mulhearn/pacman/vivado/README

This approach is based on:

https://www.fpgadeveloper.com/2014/08/version-control-for-vivado-projects.html/
