mulhearn/pacman/docs/notes/table_JB1-3.tex

JB1.35 & TILE7\_POSI0 & B35\_L10\_N & IO\_L10N\_T1\_AD11N\_35 & A19 \\ 
JB1.37 & TILE7\_POSI1 & B35\_L10\_P & IO\_L10P\_T1\_AD11P\_35 & A18 \\ 
JB1.39 & TILE7\_POSI2 & B35\_L9\_N & IO\_L9N\_T1\_DQS\_AD3N\_35 & A17 \\ 
JB1.41 & TILE7\_POSI3 & B35\_L9\_P & IO\_L9P\_T1\_DQS\_AD3P\_35 & A16 \\ 
JB1.45 & TILE7\_PISO0 & B35\_L7\_N & IO\_L7N\_T1\_AD2N\_35 & B15 \\ 
JB1.47 & TILE7\_PISO1 & B35\_L7\_P & IO\_L7P\_T1\_AD2P\_35 & C15 \\ 
JB1.49 & TILE7\_PISO2 & B35\_L2\_N & IO\_L2N\_T0\_AD8N\_35 & D17 \\ 
JB1.51 & TILE7\_PISO3 & B35\_L2\_P & IO\_L2P\_T0\_AD8P\_35 & D16 \\ 
JB1.55 & TILE6\_POSI0 & B35\_L8\_N & IO\_L8N\_T1\_AD10N\_35 & B17 \\ 
JB1.57 & TILE6\_POSI1 & B35\_L8\_P & IO\_L8P\_T1\_AD10P\_35 & B16 \\ 
JB1.59 & TILE6\_POSI2 & B35\_L21\_N & IO\_L21N\_T3\_DQS\_AD14N\_35 & E20 \\ 
JB1.61 & TILE6\_POSI3 & B35\_L21\_P & IO\_L21P\_T3\_DQS\_AD14P\_35 & E19 \\ 
JB1.65 & TILE6\_PISO0 & B35\_L11\_N & IO\_L11N\_T1\_SRCC\_35 & C18 \\ 
JB1.67 & TILE6\_PISO1 & B35\_L11\_P & IO\_L11P\_T1\_SRCC\_35 & C17 \\ 
JB1.69 & TILE6\_PISO2 & B35\_L23\_N & IO\_L23N\_T3\_35 & F22 \\ 
JB1.71 & TILE6\_PISO3 & B35\_L23\_P & IO\_L23P\_T3\_35 & F21 \\ 
JB1.75 & TILE9\_POSI0 & B35\_L5\_N & IO\_L5N\_T0\_AD9N\_35 & E18 \\ 
JB1.77 & TILE9\_POSI1 & B35\_L5\_P & IO\_L5P\_T0\_AD9P\_35 & F18 \\ 
JB1.79 & TILE9\_POSI2 & B35\_L3\_N & IO\_L3N\_T0\_DQS\_AD1N\_35 & D15 \\ 
JB1.81 & TILE9\_POSI3 & B35\_L3\_P & IO\_L3P\_T0\_DQS\_AD1P\_35 & E15 \\ 
JB1.85 & TILE9\_PISO0 & B35\_L6\_N & IO\_L6N\_T0\_VREF\_35 & F17 \\ 
JB1.87 & TILE9\_PISO1 & B35\_L6\_P & IO\_L6P\_T0\_35 & G17 \\ 
JB1.93 & TILE9\_PISO2 & B35\_L1\_N & IO\_L1N\_T0\_AD0N\_35 & E16 \\ 
JB1.95 & TILE9\_PISO3 & B35\_L1\_P & IO\_L1P\_T0\_AD0P\_35 & F16 \\ 
JB1.97 & ADC\_D2 & B35\_L19\_N & IO\_L19N\_T3\_VREF\_35 & H20 \\ 
JB1.99 & ADC\_D3 & B35\_L19\_P & IO\_L19P\_T3\_35 & H19 \\ 
JB1.32 & TILE4\_POSI0 & B35\_L16\_N & IO\_L16N\_T2\_35 & C22 \\ 
JB1.34 & TILE4\_POSI1 & B35\_L16\_P & IO\_L16P\_T2\_35 & D22 \\ 
JB1.36 & TILE4\_POSI2 & B35\_L24\_N & IO\_L24N\_T3\_AD15N\_35 & G22 \\ 
JB1.38 & TILE4\_POSI3 & B35\_L24\_P & IO\_L24P\_T3\_AD15P\_35 & H22 \\ 
JB1.42 & TILE4\_PISO0 & B35\_L18\_N & IO\_L18N\_T2\_AD13N\_35 & B22 \\ 
JB1.44 & TILE4\_PISO1 & B35\_L18\_P & IO\_L18P\_T2\_AD13P\_35 & B21 \\ 
JB1.46 & TILE4\_PISO2 & B35\_L15\_N & IO\_L15N\_T2\_DQS\_AD12N\_35 & A22 \\ 
JB1.48 & TILE4\_PISO3 & B35\_L15\_P & IO\_L15P\_T2\_DQS\_AD12P\_35 & A21 \\ 
JB1.50 & TILE1\_ENABLE & B35\_L22\_N & IO\_L22N\_T3\_AD7N\_35 & G21 \\ 
JB1.52 & TILE1\_TRIG & B35\_L22\_P & IO\_L22P\_T3\_AD7P\_35 & G20 \\ 
JB1.56 & TILE1\_POSI0 & B35\_L17\_N & IO\_L17N\_T2\_AD5N\_35 & D21 \\ 
JB1.58 & TILE1\_POSI1 & B35\_L17\_P & IO\_L17P\_T2\_AD5P\_35 & E21 \\ 
JB1.60 & TILE1\_POSI2 & B35\_L13\_N & IO\_L13N\_T2\_MRCC\_35 & B20 \\ 
JB1.62 & TILE1\_POSI3 & B35\_L13\_P & IO\_L13P\_T2\_MRCC\_35 & B19 \\ 
JB1.66 & TILE1\_PISO0 & B35\_L14\_N & IO\_L14N\_T2\_AD4N\_SRCC\_35 & C20 \\
JB1.68 & TILE1\_PISO1 & B35\_L14\_P & IO\_L14P\_T2\_AD4P\_SRCC\_35 & D20 \\ 
JB1.70 & TILE1\_PISO2 & B35\_L4\_N & IO\_L4N\_T0\_34 & M17 \\
JB1.72 & TILE1\_PISO3 & B35\_L4\_P & IO\_L4P\_T0\_35 & G15 \\ 
JB1.76 & GLOBAL\_CLK & B35\_L12\_N & IO\_L12N\_T1\_MRCC\_35 & C19 \\ 
JB1.78 & TILE1\_SYNC & B35\_L12\_P & IO\_L12P\_T1\_MRCC\_35 & D18 \\ 
JB1.82 & ADC\_D0 & B35\_L20\_N & IO\_L20N\_T3\_AD6N\_35 & F19 \\ 
JB1.84 & ADC\_D1 & B35\_L20\_P & IO\_L20P\_T3\_AD6P\_35 & G19 \\ 
JB2.13 & SFP\_TDATA\_P & B33\_L4\_P & IO\_L4P\_T0\_33 & W20 \\ 
JB2.15 & SFP\_TDATA\_N & B33\_L4\_N & IO\_L4N\_T0\_33 & W21 \\ 
JB2.21 & CDR\_CLK\_P & B33\_L13\_P & IO\_L13P\_T2\_MRCC\_33 & W17 \\ 
JB2.23 & CDR\_CLK\_N & B33\_L13\_N & IO\_L13N\_T2\_MRCC\_33 & W18 \\ 
JB2.25 & CDR\_DATA\_P & B33\_L14\_P & IO\_L14P\_T2\_SRCC\_33 & W16 \\ 
JB2.27 & CDR\_DATA\_N & B33\_L14\_N & IO\_L14N\_T2\_SRCC\_33 & Y16 \\ 
JB2.31 & TILE2\_POSI0 & B13\_L5\_P & IO\_L5P\_T0\_13 & U12 \\ 
JB2.33 & TILE2\_POSI1 & B13\_L5\_N & IO\_L5N\_T0\_13 & U11 \\ 
JB2.35 & TILE2\_POSI2 & B13\_L6\_P & IO\_L6P\_T0\_13 & U10 \\ 
JB2.37 & TILE2\_POSI3 & B13\_L6\_N & IO\_L6N\_T0\_VREF\_13 & U9 \\ 
JB2.41 & TILE2\_PISO0 & B13\_L1\_P & IO\_L1P\_T0\_13 & V10 \\ 
JB2.43 & TILE2\_PISO1 & B13\_L1\_N & IO\_L1N\_T0\_13 & V9 \\ 
JB2.45 & TILE2\_PISO2 & B13\_L12\_P & IO\_L12P\_T1\_MRCC\_13 & Y9 \\ 
JB2.47 & TILE2\_PISO3 & B13\_L12\_N & IO\_L12N\_T1\_MRCC\_13 & Y8 \\ 
JB2.51 & TILE3\_POSI0 & B13\_L14\_P & IO\_L14P\_T2\_SRCC\_13 & AA7 \\ 
JB2.53 & TILE3\_POSI1 & B13\_L14\_N & IO\_L14N\_T2\_SRCC\_13 & AA6 \\ 
JB2.55 & TILE3\_POSI2 & B13\_L13\_P & IO\_L13P\_T2\_MRCC\_13 & Y6 \\ 
JB2.57 & TILE3\_POSI3 & B13\_L13\_N & IO\_L13N\_T2\_MRCC\_13 & Y5 \\ 
JB2.61 & TILE3\_PISO0 & B13\_L4\_P & IO\_L4P\_T0\_13 & V12 \\ 
JB2.63 & TILE3\_PISO1 & B13\_L4\_N & IO\_L4N\_T0\_13 & W12 \\ 
JB2.65 & TILE3\_PISO2 & B13\_L3\_P & IO\_L3P\_T0\_DQS\_13 & W11 \\ 
JB2.67 & TILE3\_PISO3 & B13\_L3\_N & IO\_L3N\_T0\_DQS\_13 & W10 \\ 
JB2.71 & TILE10\_POSI0 & B13\_L10\_P & IO\_L10P\_T1\_13 & Y11 \\ 
JB2.73 & TILE10\_POSI1 & B13\_L10\_N & IO\_L10N\_T1\_13 & Y10 \\ 
JB2.75 & TILE10\_POSI2 & B13\_L2\_P & IO\_L2P\_T0\_13 & V8 \\ 
JB2.77 & TILE10\_POSI3 & B13\_L2\_N & IO\_L2N\_T0\_13 & W8 \\ 
JB2.81 & TILE10\_PISO0 & B13\_L23\_P & IO\_L23P\_T3\_13 & V7 \\ 
JB2.83 & TILE10\_PISO1 & B13\_L23\_N & IO\_L23N\_T3\_13 & W7 \\ 
JB2.85 & TILE10\_PISO2 & B13\_L24\_P & IO\_L24P\_T3\_13 & W6 \\ 
JB2.87 & TILE10\_PISO3 & B13\_L24\_N & IO\_L24N\_T3\_13 & W5 \\ 
JB2.91 & ADC\_D4 & B13\_L19\_P & IO\_L19P\_T3\_13 & R6 \\ 
JB2.93 & ADC\_D5 & B13\_L19\_N & IO\_L19N\_T3\_VREF\_13 & T6 \\ 
JB2.95 & ADC\_D6 & B13\_L22\_P & IO\_L22P\_T3\_13 & U6 \\ 
JB2.97 & ADC\_D7 & B13\_L22\_N & IO\_L22N\_T3\_13 & U5 \\ 
JB2.12  & SFP\_TCLK\_P & B33\_L7\_P & IO\_L7P\_T1\_33 & AA22 \\ 
JB2.14 & SFP\_TCLK\_N & B33\_L7\_N & IO\_L7N\_T1\_33 & AB22 \\ 
JB2.16 & SFP\_FAULT & B33\_L8\_P & IO\_L8P\_T1\_33 & AA21 \\ 
JB2.18 & SFP\_LOS & B33\_L8\_N & IO\_L8N\_T1\_33 & AB21 \\ 
JB2.22 & SFP\_MOD & B33\_L11\_P & IO\_L11P\_T1\_SRCC\_33 & Y19 \\ 
JB2.24 & SFP\_DISABLE & B33\_L11\_N & IO\_L11N\_T1\_SRCC\_33 & AA19 \\ 
JB2.26 & ADC\_D8 & B33\_L12\_P & IO\_L12P\_T1\_MRCC\_33 & Y18 \\ 
JB2.28 & ADC\_D9 & B33\_L12\_N & IO\_L12N\_T1\_MRCC\_33 & AA18 \\ 
JB2.32 & ADC\_D10 & B33\_L17\_P & IO\_L17P\_T2\_33 & AA17 \\ 
JB2.34 & ADC\_D11 & B33\_L17\_N & IO\_L17N\_T2\_33 & AB17 \\
JB2.36 & ADC\_OF & B33\_L18\_P & IO\_L18P\_T2\_33 & AA16 \\ 
JB2.38 & ADC\_EN & B33\_L18\_N & IO\_L18N\_T2\_33 & AB16 \\ 
JB2.42 & TILE5\_POSI3 & B13\_L7\_P & IO\_L7P\_T1\_13 & AA12 \\ 
JB2.44 & TILE5\_POSI2 & B13\_L7\_N & IO\_L7N\_T1\_13 & AB12 \\ 
JB2.46 & TILE5\_POSI1 & B13\_L8\_P & IO\_L8P\_T1\_13 & AA11 \\ 
JB2.48 & TILE5\_POSI0 & B13\_L8\_N & IO\_L8N\_T1\_13 & AB11 \\ 
JB2.52 & TILE5\_PISO3 & B13\_L11\_P & IO\_L11P\_T1\_SRCC\_13 & AA9 \\ 
JB2.54 & TILE5\_PISO2 & B13\_L11\_N & IO\_L11N\_T1\_SRCC\_13 & AA8 \\ 
JB2.56 & TILE5\_PISO1 & B13\_L9\_P & IO\_L9P\_T1\_DQS\_13 & AB10 \\ 
JB2.58 & TILE5\_PISO0 & B13\_L9\_N & IO\_L9N\_T1\_DQS\_13 & AB9 \\ 
JB2.62 & TILE8\_POSI3 & B13\_L20\_P & IO\_L20P\_T3\_13 & T4 \\ 
JB2.64 & TILE8\_POSI2 & B13\_L20\_N & IO\_L20N\_T3\_13 & U4 \\ 
JB2.66 & TILE8\_POSI1 & B13\_L17\_P & IO\_L17P\_T2\_13 & AB7 \\ 
JB2.68 & TILE8\_POSI0 & B13\_L17\_N & IO\_L17N\_T2\_13 & AB6 \\ 
JB2.72 & TILE8\_PISO3 & B13\_L16\_P & IO\_L16P\_T2\_13 & AB5 \\ 
JB2.74 & TILE8\_PISO2 & B13\_L16\_N & IO\_L16N\_T2\_13 & AB4 \\ 
JB2.76 & TILE8\_PISO1 & B13\_L18\_P & IO\_L18P\_T2\_13 & Y4 \\ 
JB2.78 & TILE8\_PISO0 & B13\_L18\_N & IO\_L18N\_T2\_13 & AA4 \\ 
JB2.82 & TEST\_OUT1 & B13\_L15\_P & IO\_L15P\_T2\_DQS\_13 & AB2 \\ 
JB2.84 & TEST\_OUT2 & B13\_L15\_N & IO\_L15N\_T2\_DQS\_13 & AB1 \\ 
JB2.86 & CDR\_LOL & B13\_L21\_P & IO\_L21P\_T3\_DQS\_13 & V5 \\ 
JB2.88 & CDR\_LOS & B13\_L21\_N & IO\_L21N\_T3\_DQS\_13 & V4 \\ 
JB3.7 & ADC\_CLK & B34\_L1\_P & IO\_L1P\_T0\_34 & J15 \\ 
JB3.9 & TILE4\_ENABLE & B34\_L1\_N & IO\_L1N\_T0\_34 & K15 \\ 
JB3.13 & TILE7\_ENABLE & B34\_L18\_P & IO\_L18P\_T2\_34 & P20 \\ 
JB3.15 & TILE6\_ENABLE & B34\_L18\_N & IO\_L18N\_T2\_34 & P21 \\ 
JB3.19 & TILE3\_ENABLE & B34\_L20\_P & IO\_L20P\_T3\_34 & P17 \\ 
JB3.21 & TILE2\_ENABLE & B34\_L20\_N & IO\_L20N\_T3\_34 & P18 \\ 
JB3.25 & TILE5\_ENABLE & B34\_L10\_P & IO\_L10P\_T1\_34 & L21 \\ 
JB3.27 & TILE8\_ENABLE & B34\_L10\_N & IO\_L10N\_T1\_34 & L22 \\ 
JB3.31 & TILE9\_ENABLE & B34\_L13\_P & IO\_L13P\_T2\_MRCC\_34 & M19 \\ 
JB3.33 & TILE10\_ENABLE & B34\_L13\_N & IO\_L13N\_T2\_MRCC\_34 & M20 \\ 
JB3.37 & (not used) & B34\_L21\_P & IO\_L21P\_T3\_DQS\_34 & T16 \\ 
JB3.39 & TILE4\_TRIG & B34\_L21\_N & IO\_L21N\_T3\_DQS\_34 & T17 \\ 
JB3.41 & TILE7\_TRIG & B34\_L15\_P & IO\_L15P\_T2\_DQS\_34 & M21 \\ 
JB3.43 & TILE6\_TRIG & B34\_L15\_N & IO\_L15N\_T2\_DQS\_34 & M22 \\ 
JB3.47 & TILE3\_TRIG & B34\_L17\_P & IO\_L17P\_T2\_34 & R20 \\ 
JB3.49 & TILE2\_TRIG & B34\_L17\_N & IO\_L17N\_T2\_34 & R21 \\ 
JB3.51 & TILE5\_TRIG & B34\_L23\_P & IO\_L23P\_T3\_34 & R18 \\ 
JB3.53 & TILE8\_TRIG & B34\_L23\_N & IO\_L23N\_T3\_34 & T18 \\ 
JB3.57 & TILE9\_TRIG & B34\_L14\_P & IO\_L14P\_T2\_SRCC\_34 & N19 \\ 
JB3.59 & TILE10\_TRIG & B34\_L14\_N & IO\_L14N\_T2\_SRCC\_34 & N20 \\ 
JB3.8 & TRIG\_ISO & B34\_L7\_P & IO\_L7P\_T1\_34 & J18 \\ 
JB3.10 & SYNC\_ISO & B34\_L7\_N & IO\_L7N\_T1\_34 & K18 \\ 
JB3.14 & ANALOG\_PWR\_EN & B34\_L2\_P & IO\_L2P\_T0\_34 & J16 \\ 
JB3.16 & TILE2\_SYNC & B34\_L2\_N & IO\_L2N\_T0\_34 & J17 \\ 
JB3.20 & TILE3\_SYNC & B34\_L4\_P & IO\_L4P\_T0\_34 & L17 \\ 
JB3.22 & TILE4\_SYNC & B34\_L4\_N & IO\_L4N\_T0\_34 & M17 \\ 
JB3.26 & TILE5\_SYNC & B34\_L5\_P & IO\_L5P\_T0\_34 & N17 \\ 
JB3.28 & TILE6\_SYNC & B34\_L5\_N & IO\_L5N\_T0\_34 & N18 \\ 
JB3.32 & ISO\_SIGNAL0 & B34\_L12\_P & IO\_L12P\_T1\_MRCC\_34 & L18 \\ 
JB3.34 & ISO\_SIGNAL1 & B34\_L12\_N & IO\_L12N\_T1\_MRCC\_34 & L19 \\ 
JB3.38 & TILE7\_SYNC & B34\_L8\_P & IO\_L8P\_T1\_34 & J21 \\ 
JB3.40 & TILE8\_SYNC & B34\_L8\_N & IO\_L8N\_T1\_34 & J22 \\ 
JB3.42 & TILE9\_SYNC & B34\_L9\_P & IO\_L9P\_T1\_DQS\_34 & J20 \\ 
JB3.44 & TILE10\_SYNC & B34\_L9\_N & IO\_L9N\_T1\_DQS\_34 & K21 \\ 
JB3.58 & LED-2 & B34\_L22\_P & IO\_L22P\_T3\_34 & R19 \\ 
JB3.60 & LED-3 & B34\_L22\_N & IO\_L22N\_T3\_34 & T19
