mulhearn/pacman/docs/legacy/v1r2/hardware.txt

Schematics for the TE0720-03-1CFA:
https://www.trenz-electronic.de/fileadmin/docs/Trenz_Electronic/Modules_and_Module_Carriers/4x5/TE0720/REV03/Documents/SCH-TE0720-03-1CFA.PDF

From which we see that it contains a XC7Z020-1CLG484C with pinout from:
https://www.xilinx.com/support/documentation/user_guides/ug865-Zynq-7000-Pkg-Pinout.pdf
https://www.xilinx.com/support/packagefiles/z7packages/xc7z020clg484pkg.txt

Tutorial that includes AXI:
https://www.xilinx.com/support/documentation/sw_manuals/xilinx2018_3/ug1165-zynq-embedded-design-tutorial.pdf

Schematics for one of our carriers:
http://www.trenz-electronic.de/fileadmin/docs/Trenz_Electronic/Modules_and_Module_Carriers/4x5/4x5_Carriers/TE0703/REV05/Documents/TRM-TE0703-05.pdf
