mulhearn/pacman/docs/demos/dma_sg/axi-dma.png

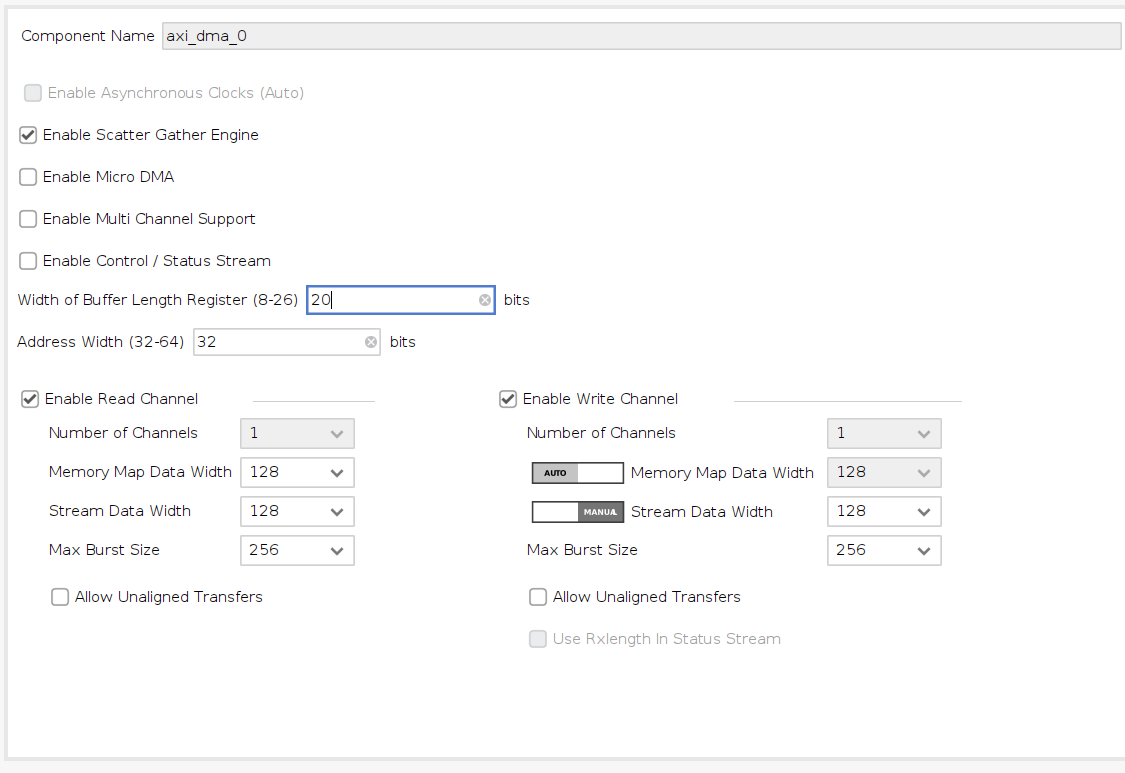
docs/demos/dma_sg/axi-dma.png
