mulhearn/pacman/docs/demos/dma_sg/fifo_a.png

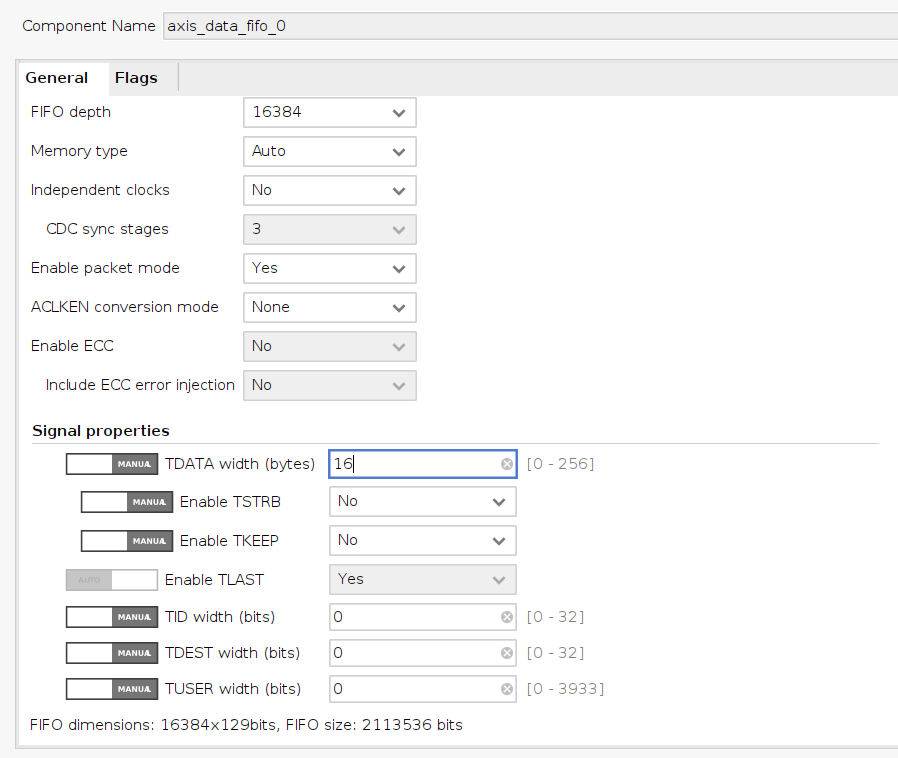
docs/demos/dma_sg/fifo_a.png
