mulhearn/pacman/docs/demos/dma_sg/fifo_b.png

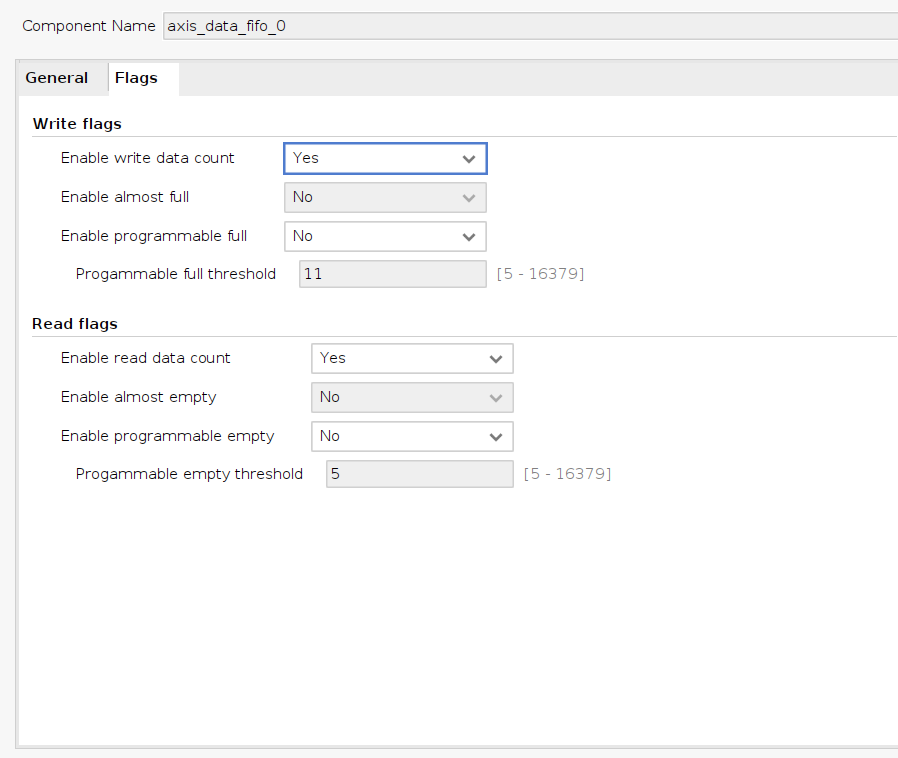
docs/demos/dma_sg/fifo_b.png
