mulhearn/pacman/petalinux/src/trenz/project-spec/configs/flash_parts.txt

flash_type=spi
boot=0 0x100000
kernel=0x100000 0x1400000
