mulhearn/pacman/docs/notes/PacMan_V5_HGB_20240520_schematics.pdf

6 | 5 | 4 | 3 | 2 | 1

D

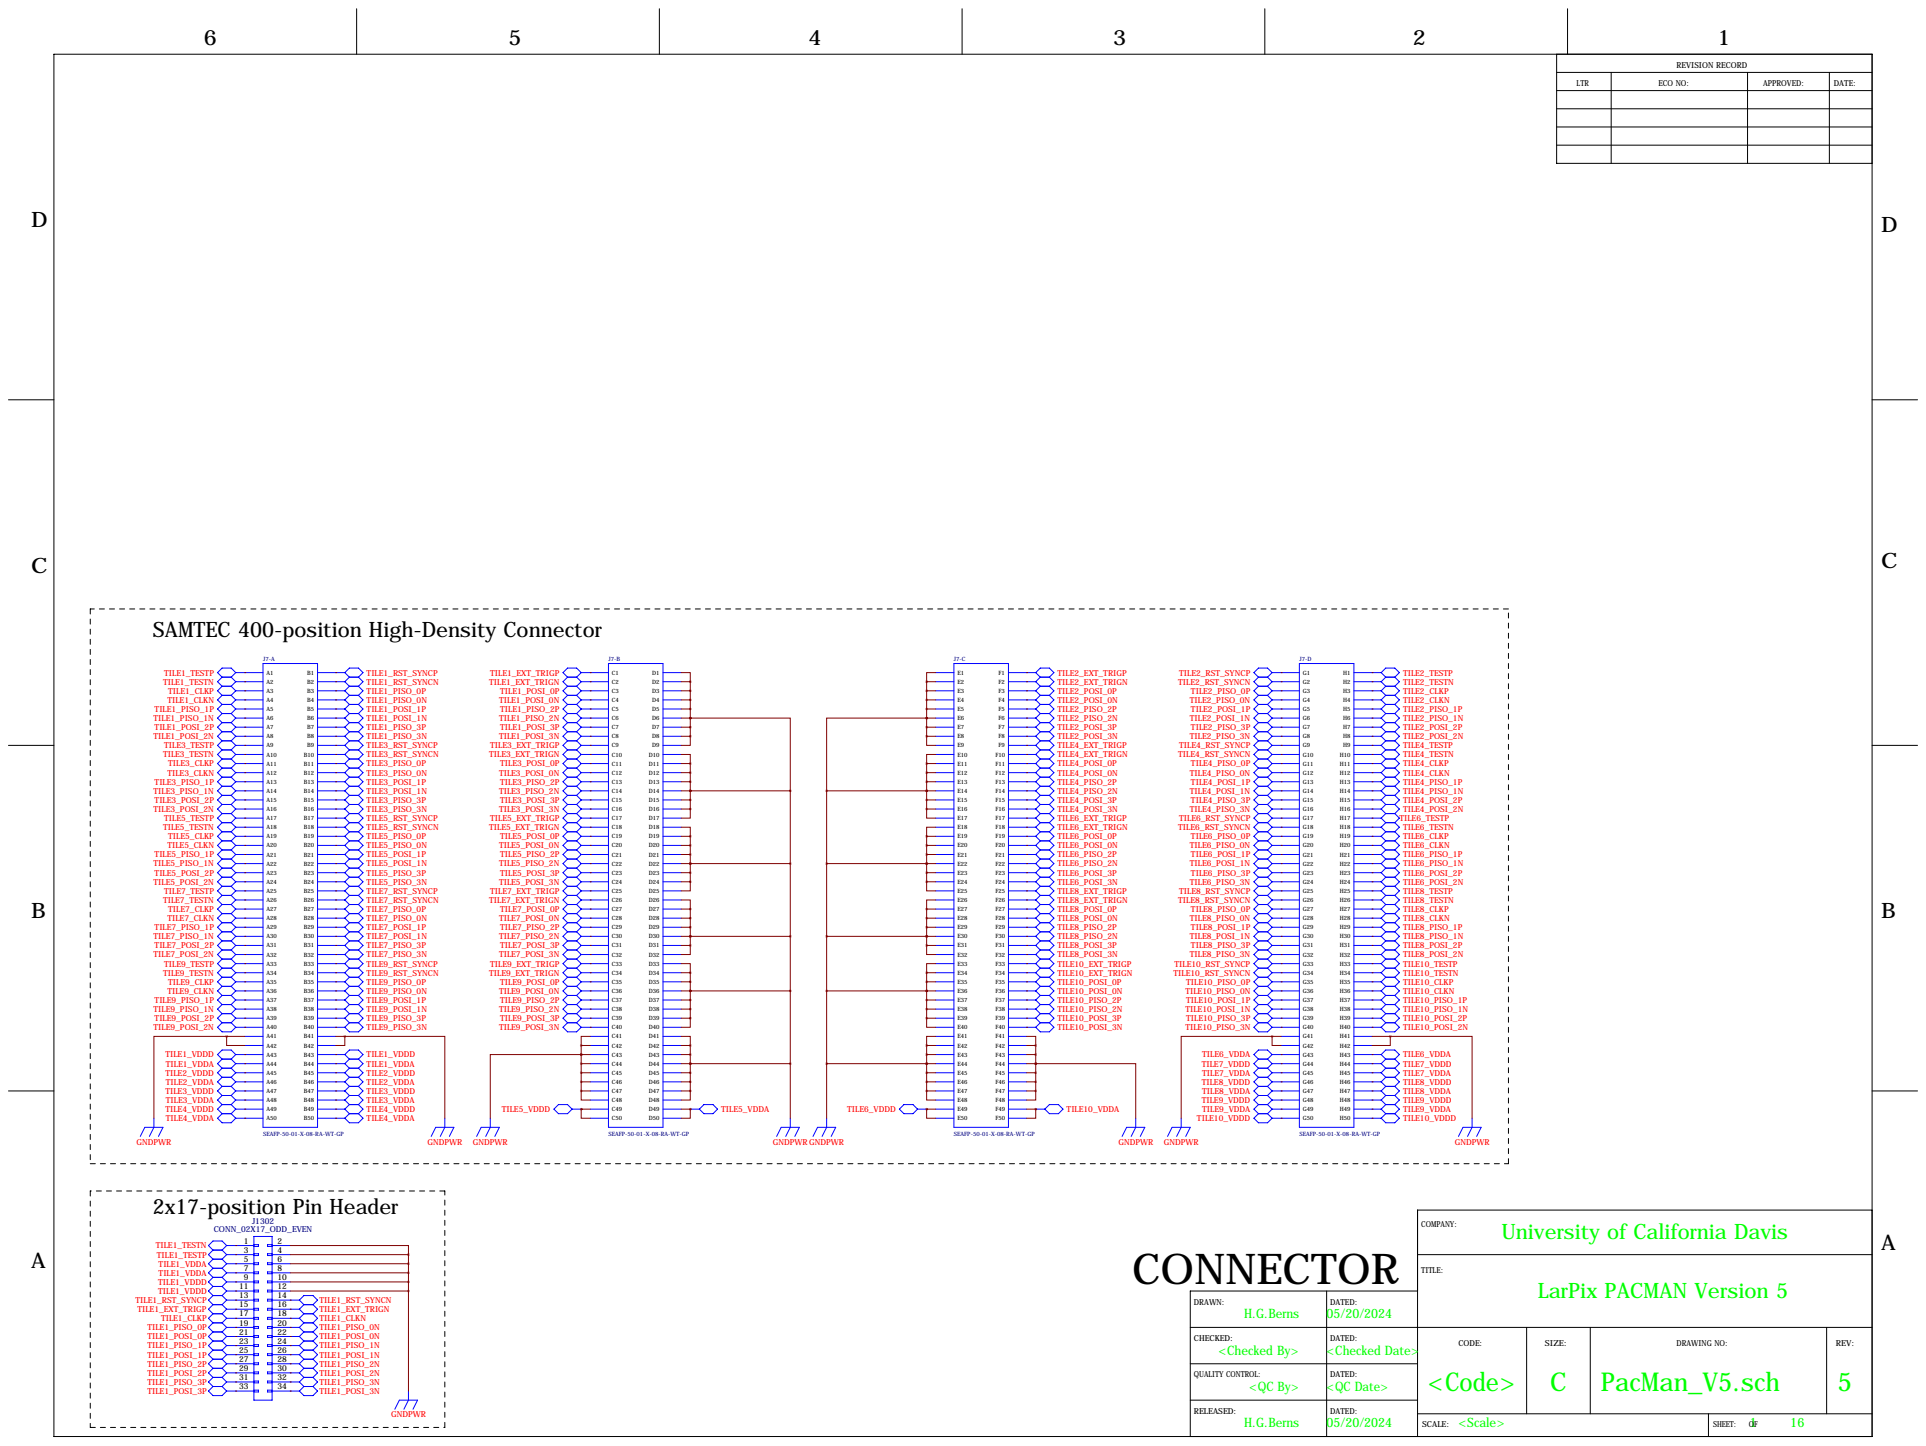
[picture p4: page 1]

REVISION RECORD

LTR | ECO NO: | APPROVED: | DATE:

SAMTEC 400-position High-Density Connector

SEAFP-50-01-X-08-RA-WT-GP

University of California Davis

DRAWN: H.G.Berns | DATED: 05/20/2024

CHECKED: <Checked By> | DATED: <Checked Date> | CODE: <Code> | SIZE: C | DRAWING NO: PacMan_V5.sch | REV: 5

QUALITY CONTROL: <QC By> | DATED: <QC Date>

RELEASED: H.G.Berns | DATED:

<Scale> SCALE: | 1 16 SHEET: OF

D
D

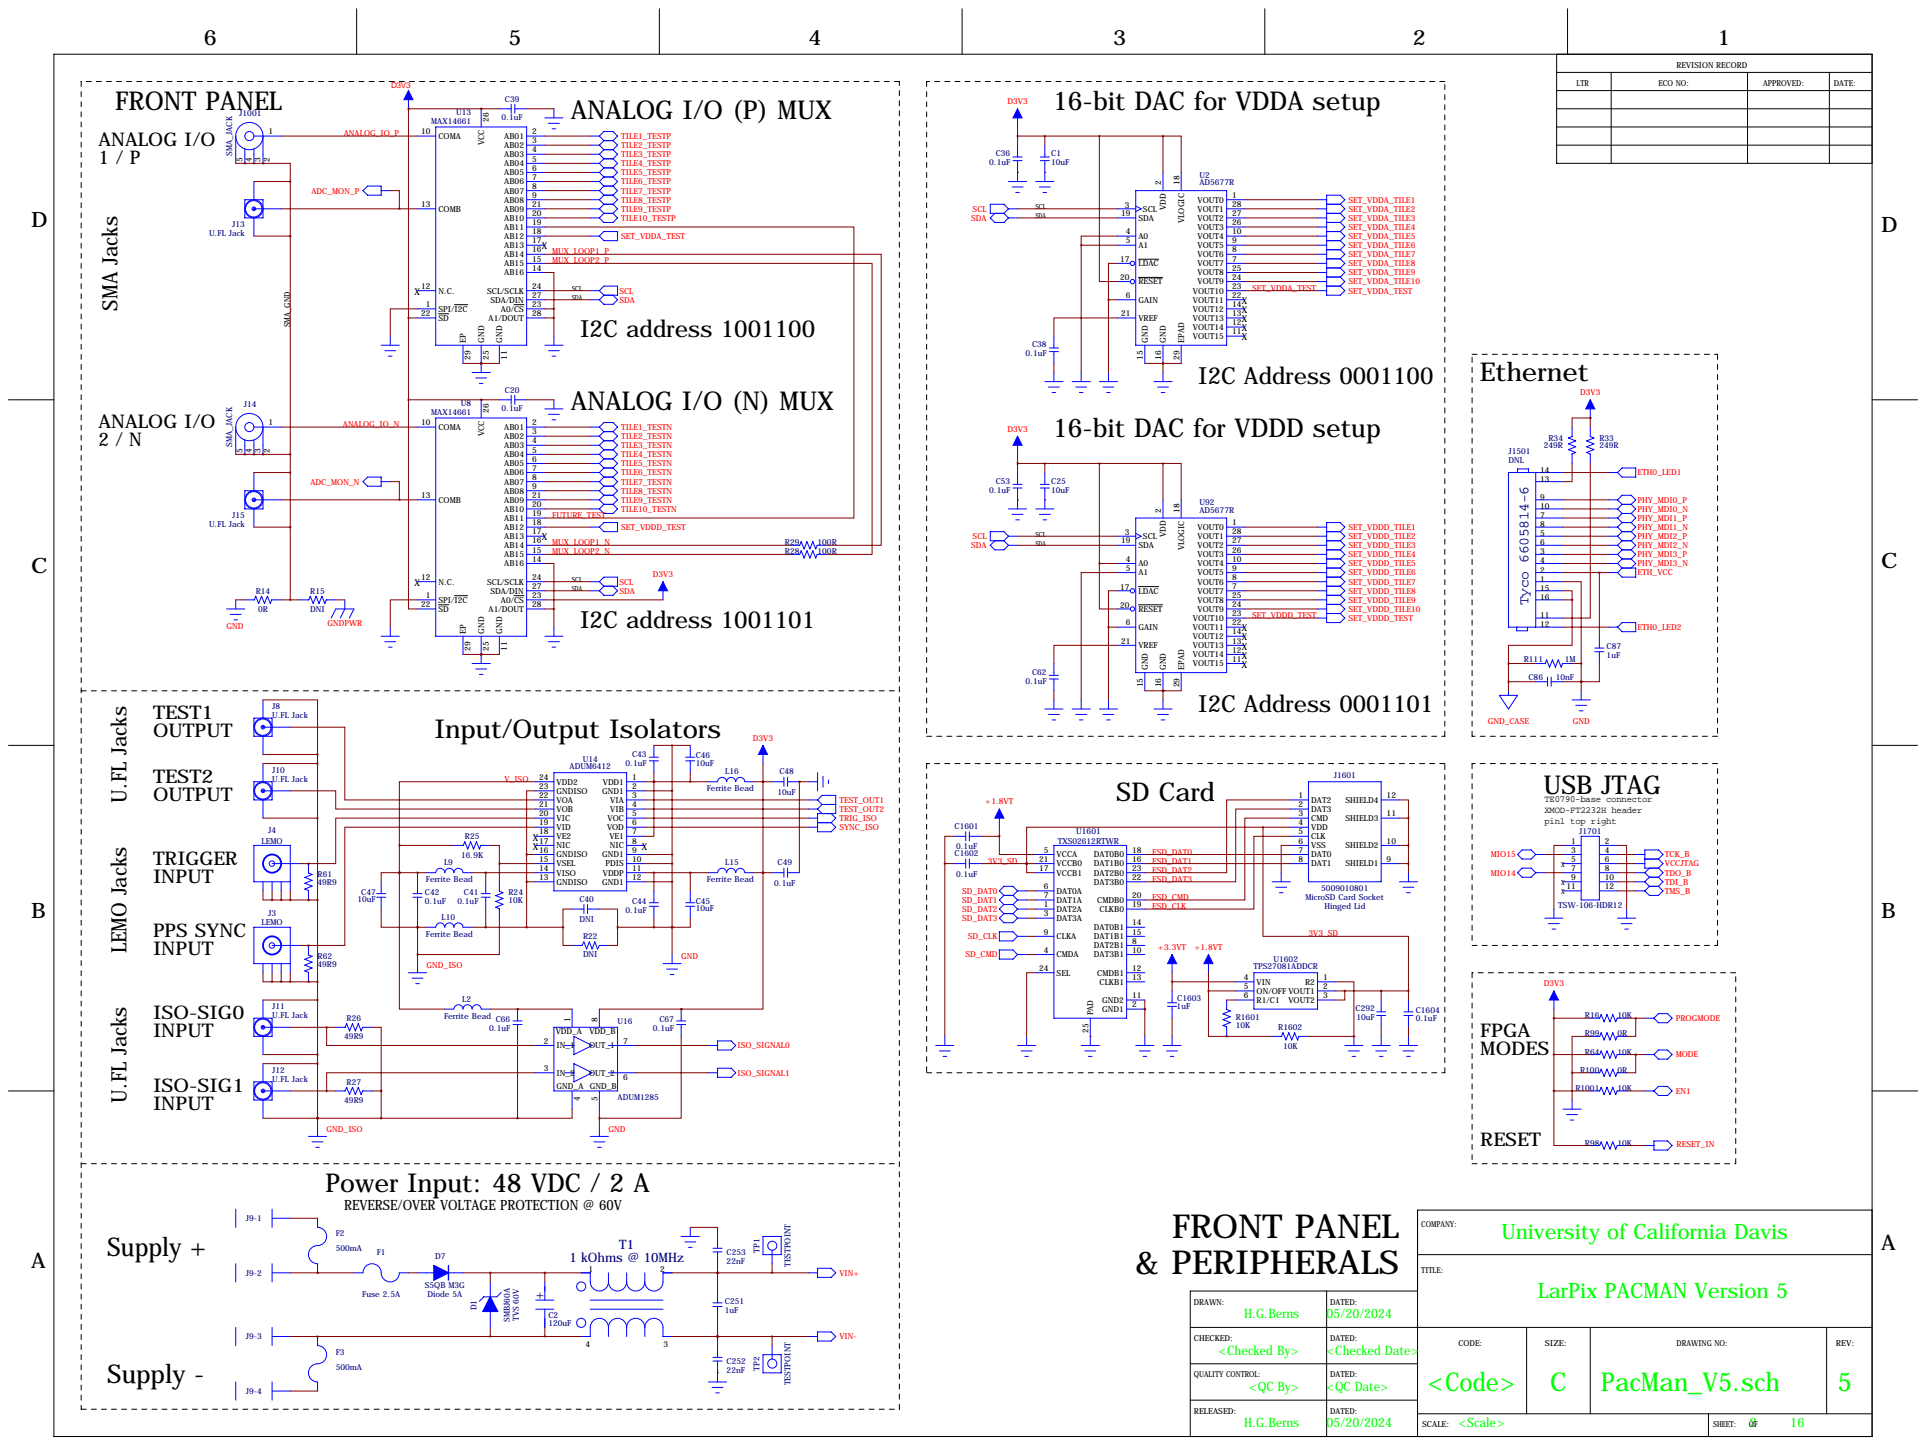
[picture p5: page 2]

24 SCL/SCLK 25 GND ²⁶ VCC

16-bit DAC for VDDA setup

16-bit DAC for VDDD setup

U.FL Jacks LEMO Jacks
TRIGGER
INPUT

REVERSE/OVER VOLTAGE PROTECTION @ 60V

University of California Davis

DRAWN: H.G.Berns | DATED: 05/20/2024
CHECKED: | DATED: | CODE: <Code> | SIZE: C | DRAWING NO: PacMan_V5.sch | REV: 5

D
D

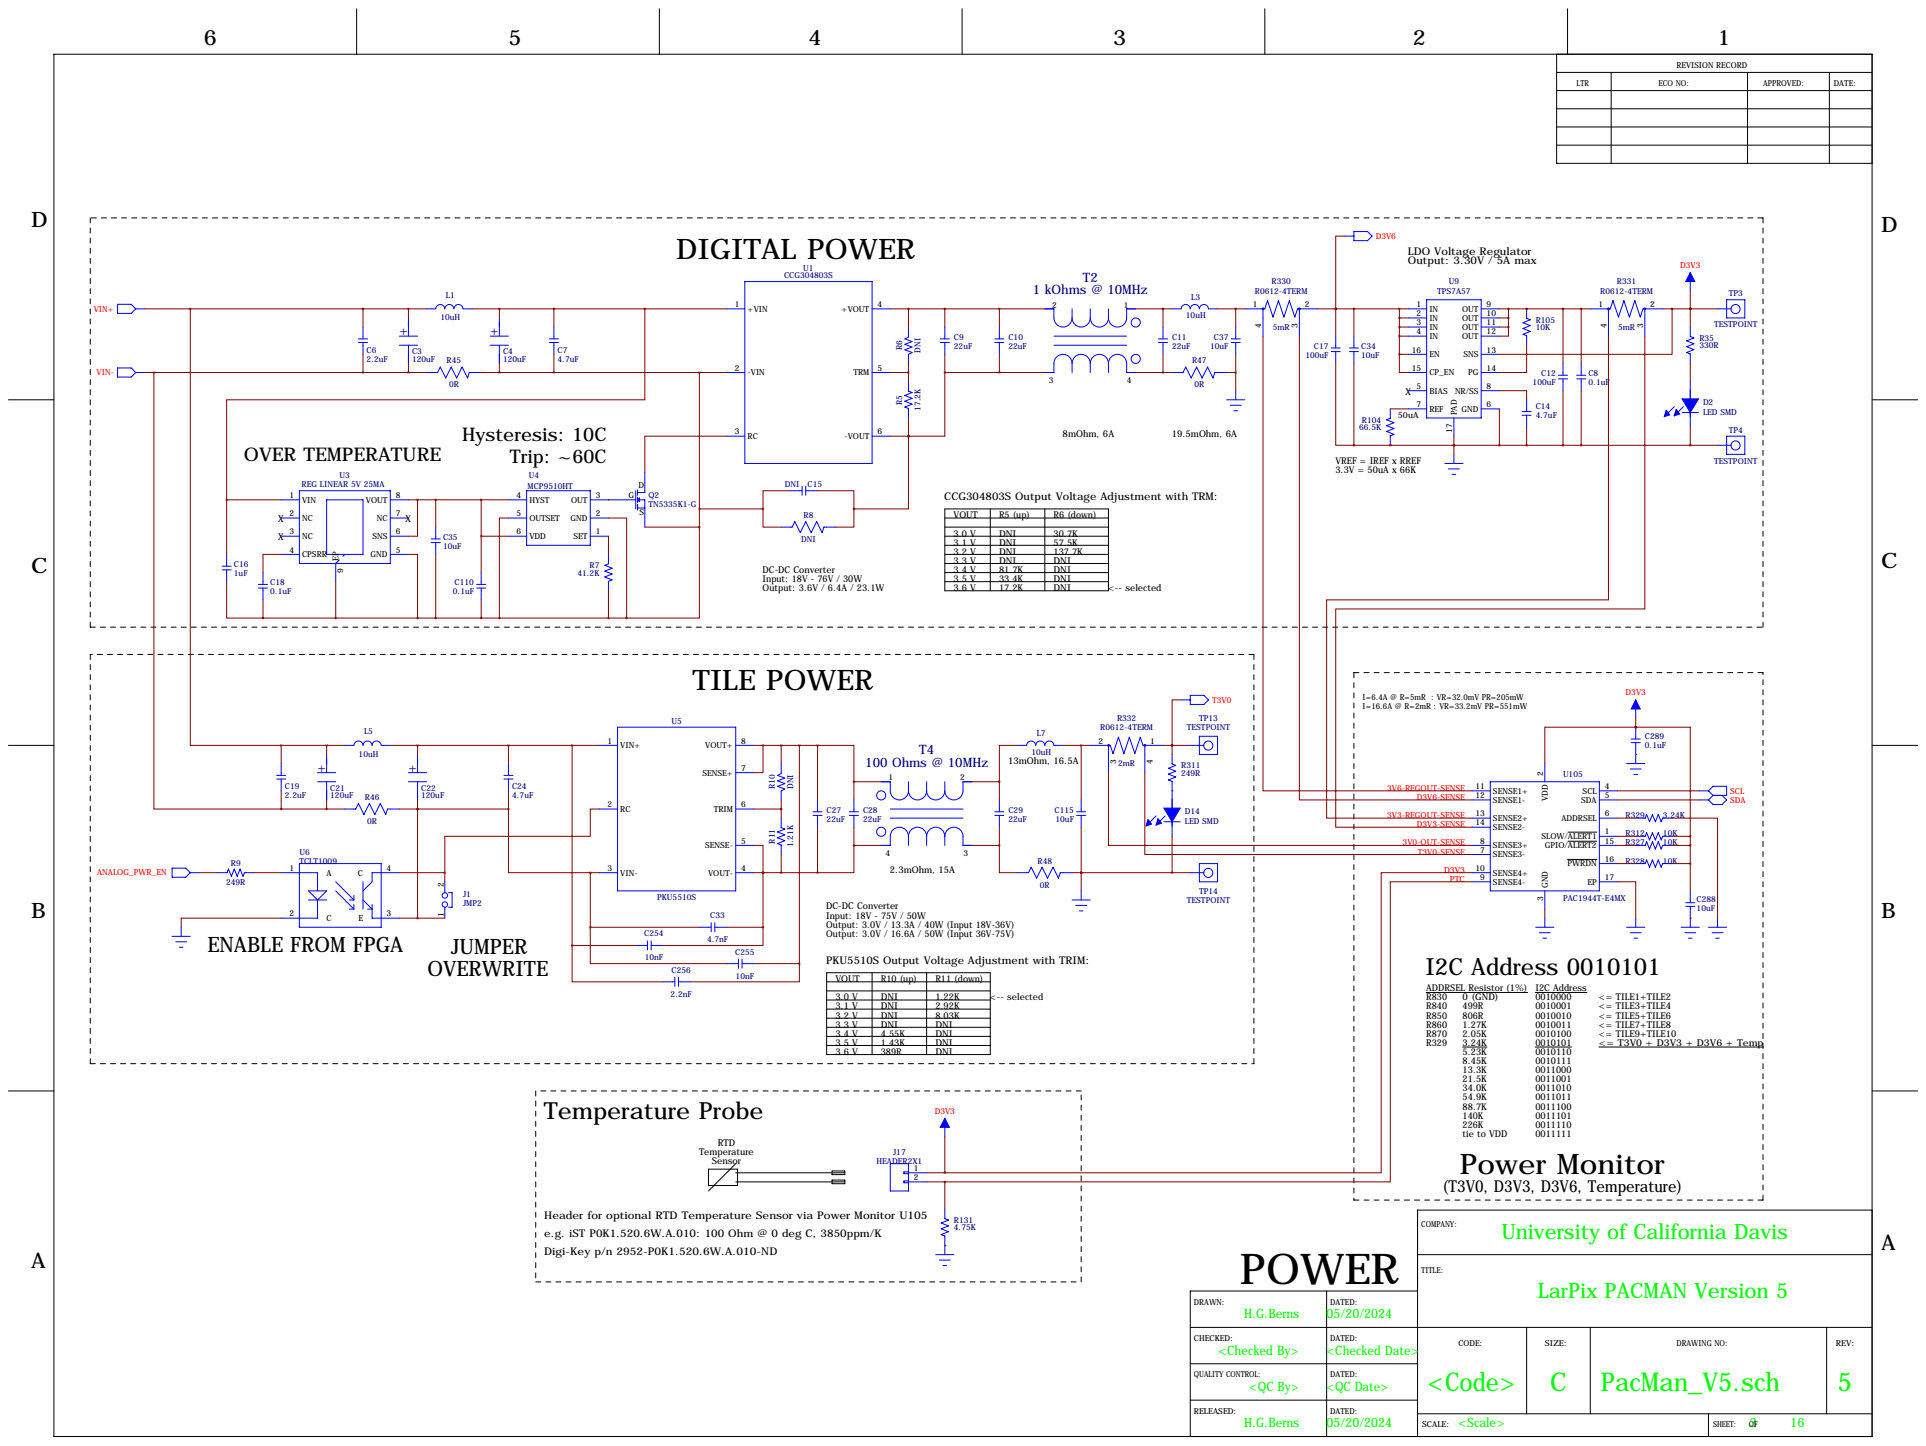
[picture p6: page 3]

CCG304803S Output Voltage Adjustment with TRM:

3.2 V | DNI | 137.7K
3.3 V | DNI | DNI
3.4 V | 81.7K | DNI
3.5 V | 33.4K | DNI
3.6 V | 17.2K | DNI

PKU5510S Output Voltage Adjustment with TRIM:

3.1 V | DNI | 2.92K
3.2 V | DNI | 8.03K
3.4 V | 4.55K | DNI
3.5 V | 1.43K | DNI
3.6 V | 389R | DNI

Header for optional RTD Temperature Sensor via Power Monitor U105

University of California Davis

DRAWN: H.G.Berns | DATED: 05/20/2024

CHECKED: | DATED: | CODE: | SIZE: | DRAWING NO: | REV:

D
D

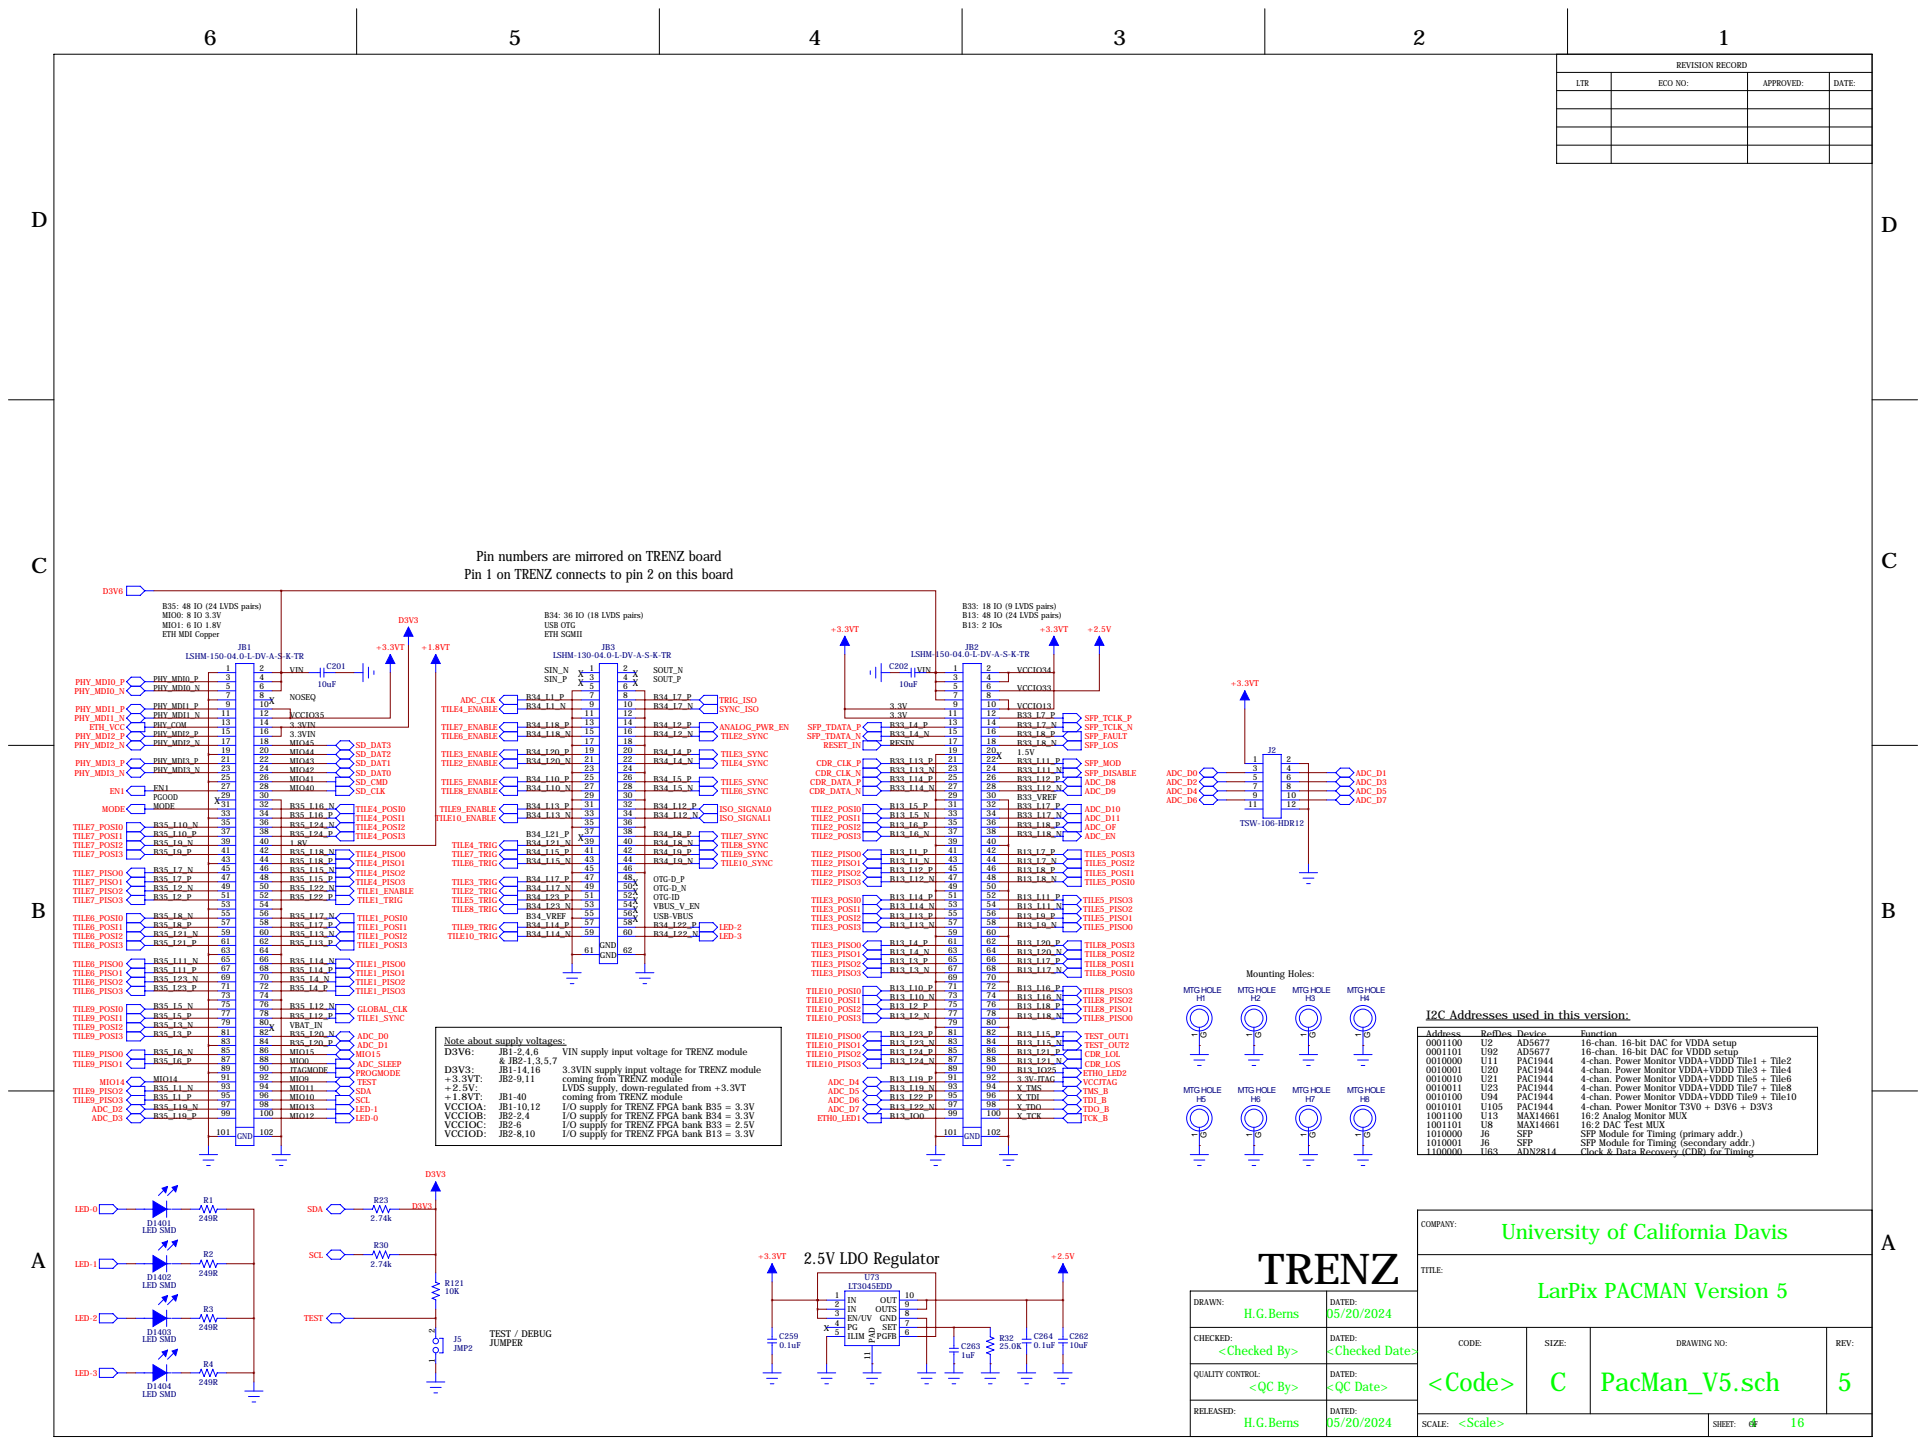
[picture p7: page 4]

Pin numbers are mirrored on TRENZ board
Pin 1 on TRENZ connects to pin 2 on this board

I2C Addresses used in this version:

Note about supply voltages:

16-chan. 16-bit DAC for VDDA setup
16-chan. 16-bit DAC for VDDD setup
4-chan. Power Monitor VDDA+VDDD Tile1 + Tile2
4-chan. Power Monitor VDDA+VDDD Tile3 + Tile4
4-chan. Power Monitor VDDA+VDDD Tile5 + Tile6
4-chan. Power Monitor VDDA+VDDD Tile7 + Tile8
4-chan. Power Monitor VDDA+VDDD Tile9 + Tile10
4-chan. Power Monitor T3V0 + D3V6 + D3V3
16:2 Analog Monitor MUX
16:2 DAC Test MUX
SFP Module for Timing (primary addr.)

VIN supply input voltage for TRENZ module

coming from TRENZ module

I/O supply for TRENZ FPGA bank B35 = 3.3V
I/O supply for TRENZ FPGA bank B34 = 3.3V
I/O supply for TRENZ FPGA bank B33 = 2.5V
I/O supply for TRENZ FPGA bank B13 = 3.3V

SFP Module for Timing (secondary addr.)
Clock & Data Recovery (CDR) for Timing

University of California Davis

D
D

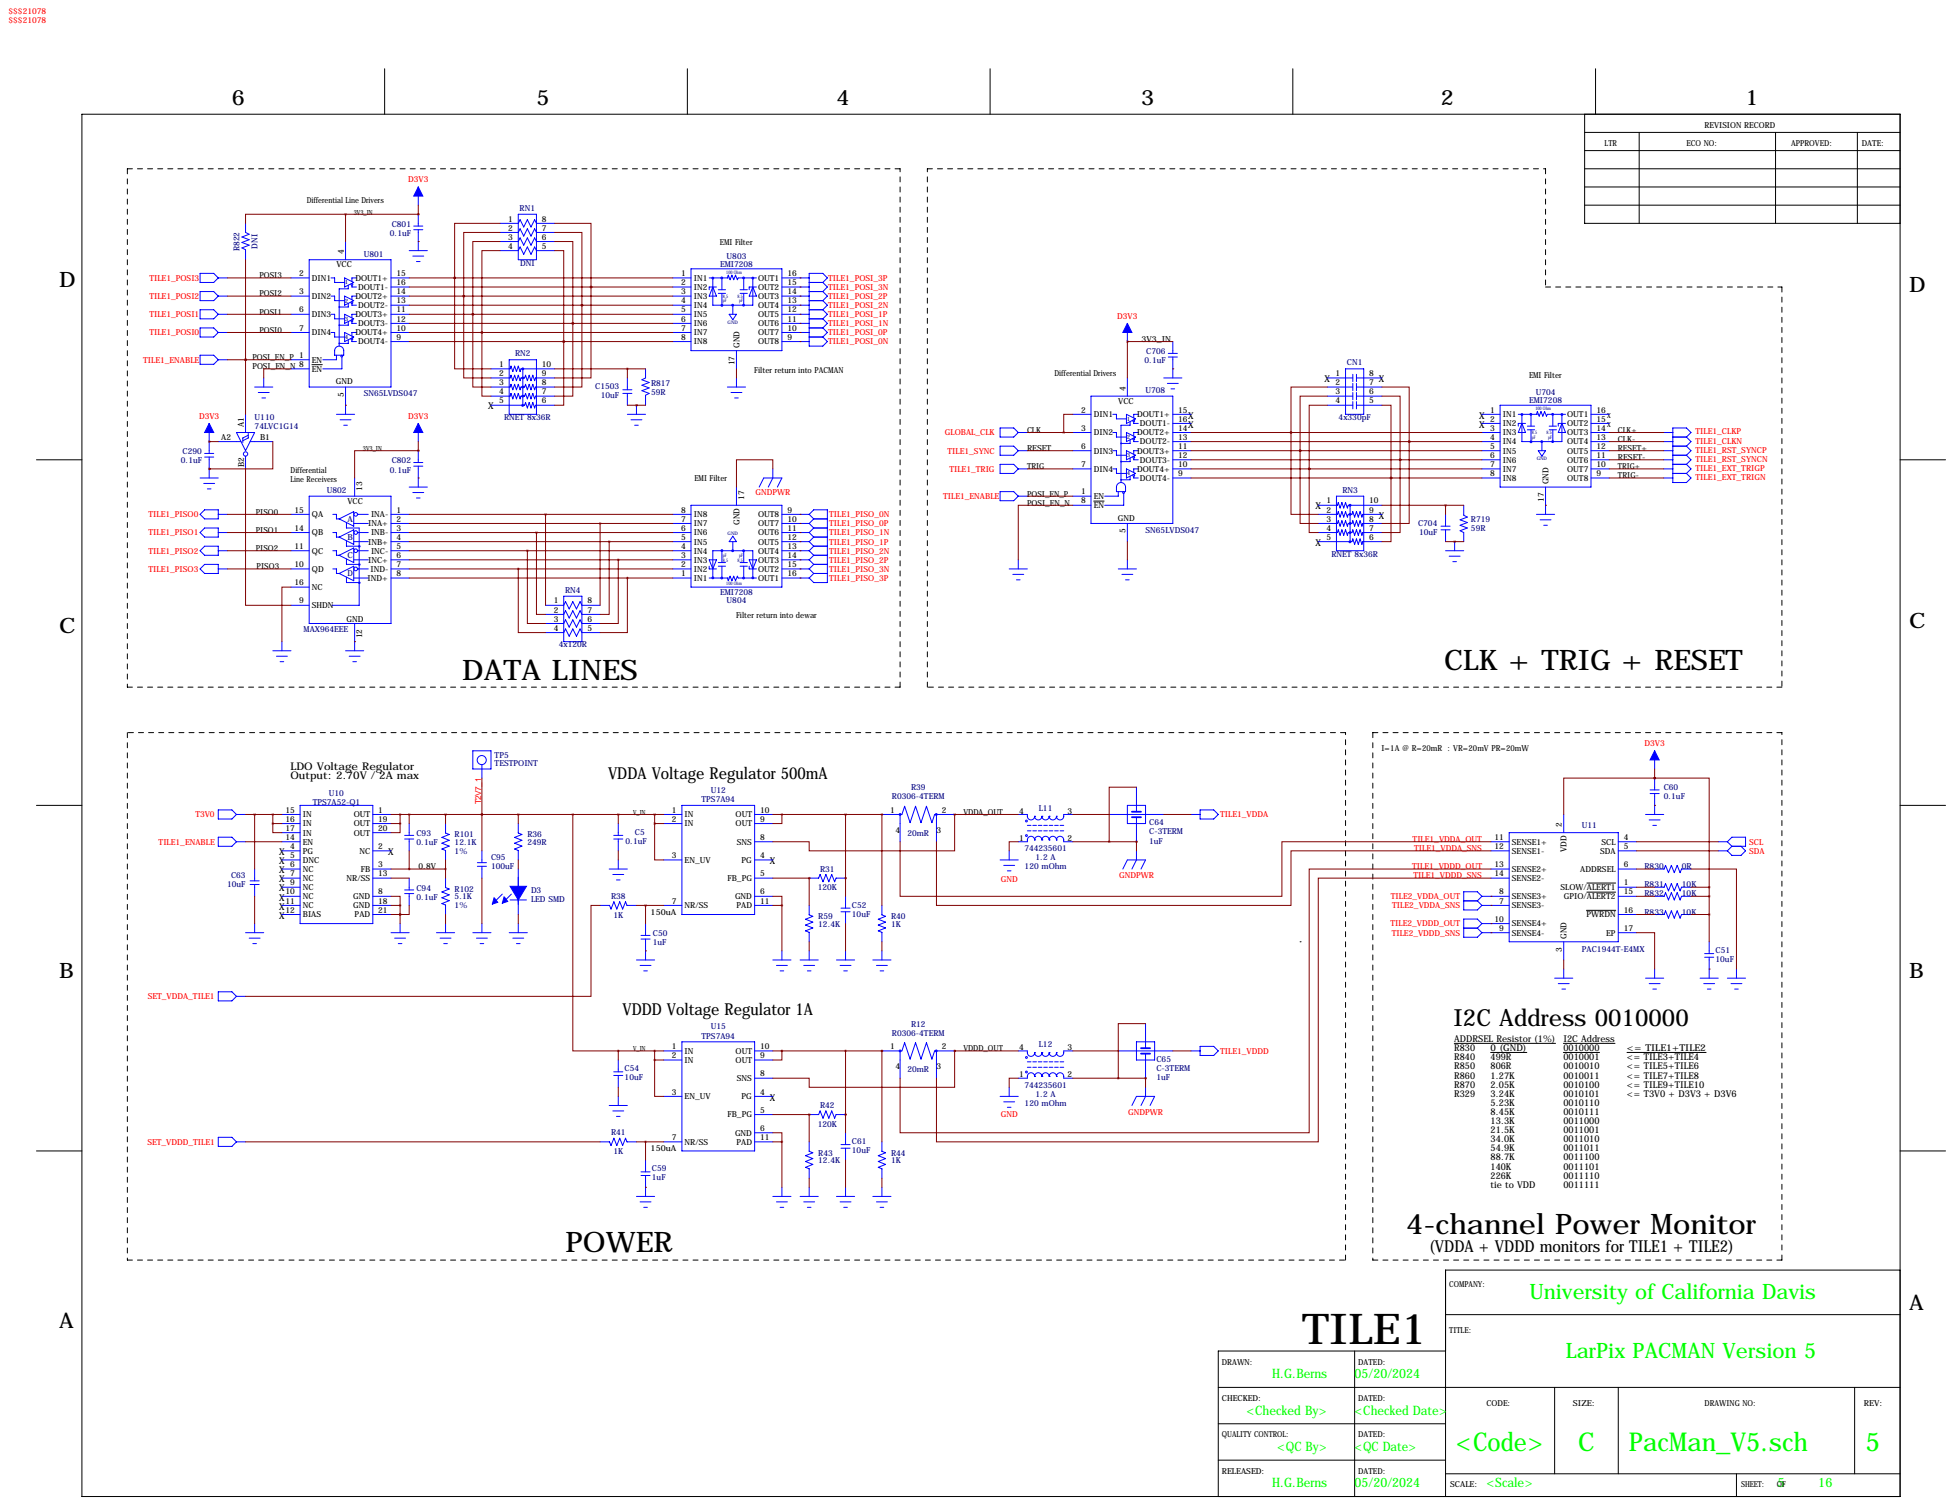
[picture p8: page 5]

Filter return into PACMAN

Filter return into dewar

4-channel Power Monitor
(VDDA + VDDD monitors for TILE1 + TILE2)

University of California Davis

DRAWN: H.G.Berns | DATED: 05/20/2024

CHECKED: | DATED: | CODE: | SIZE: | DRAWING NO: | REV:

D
D

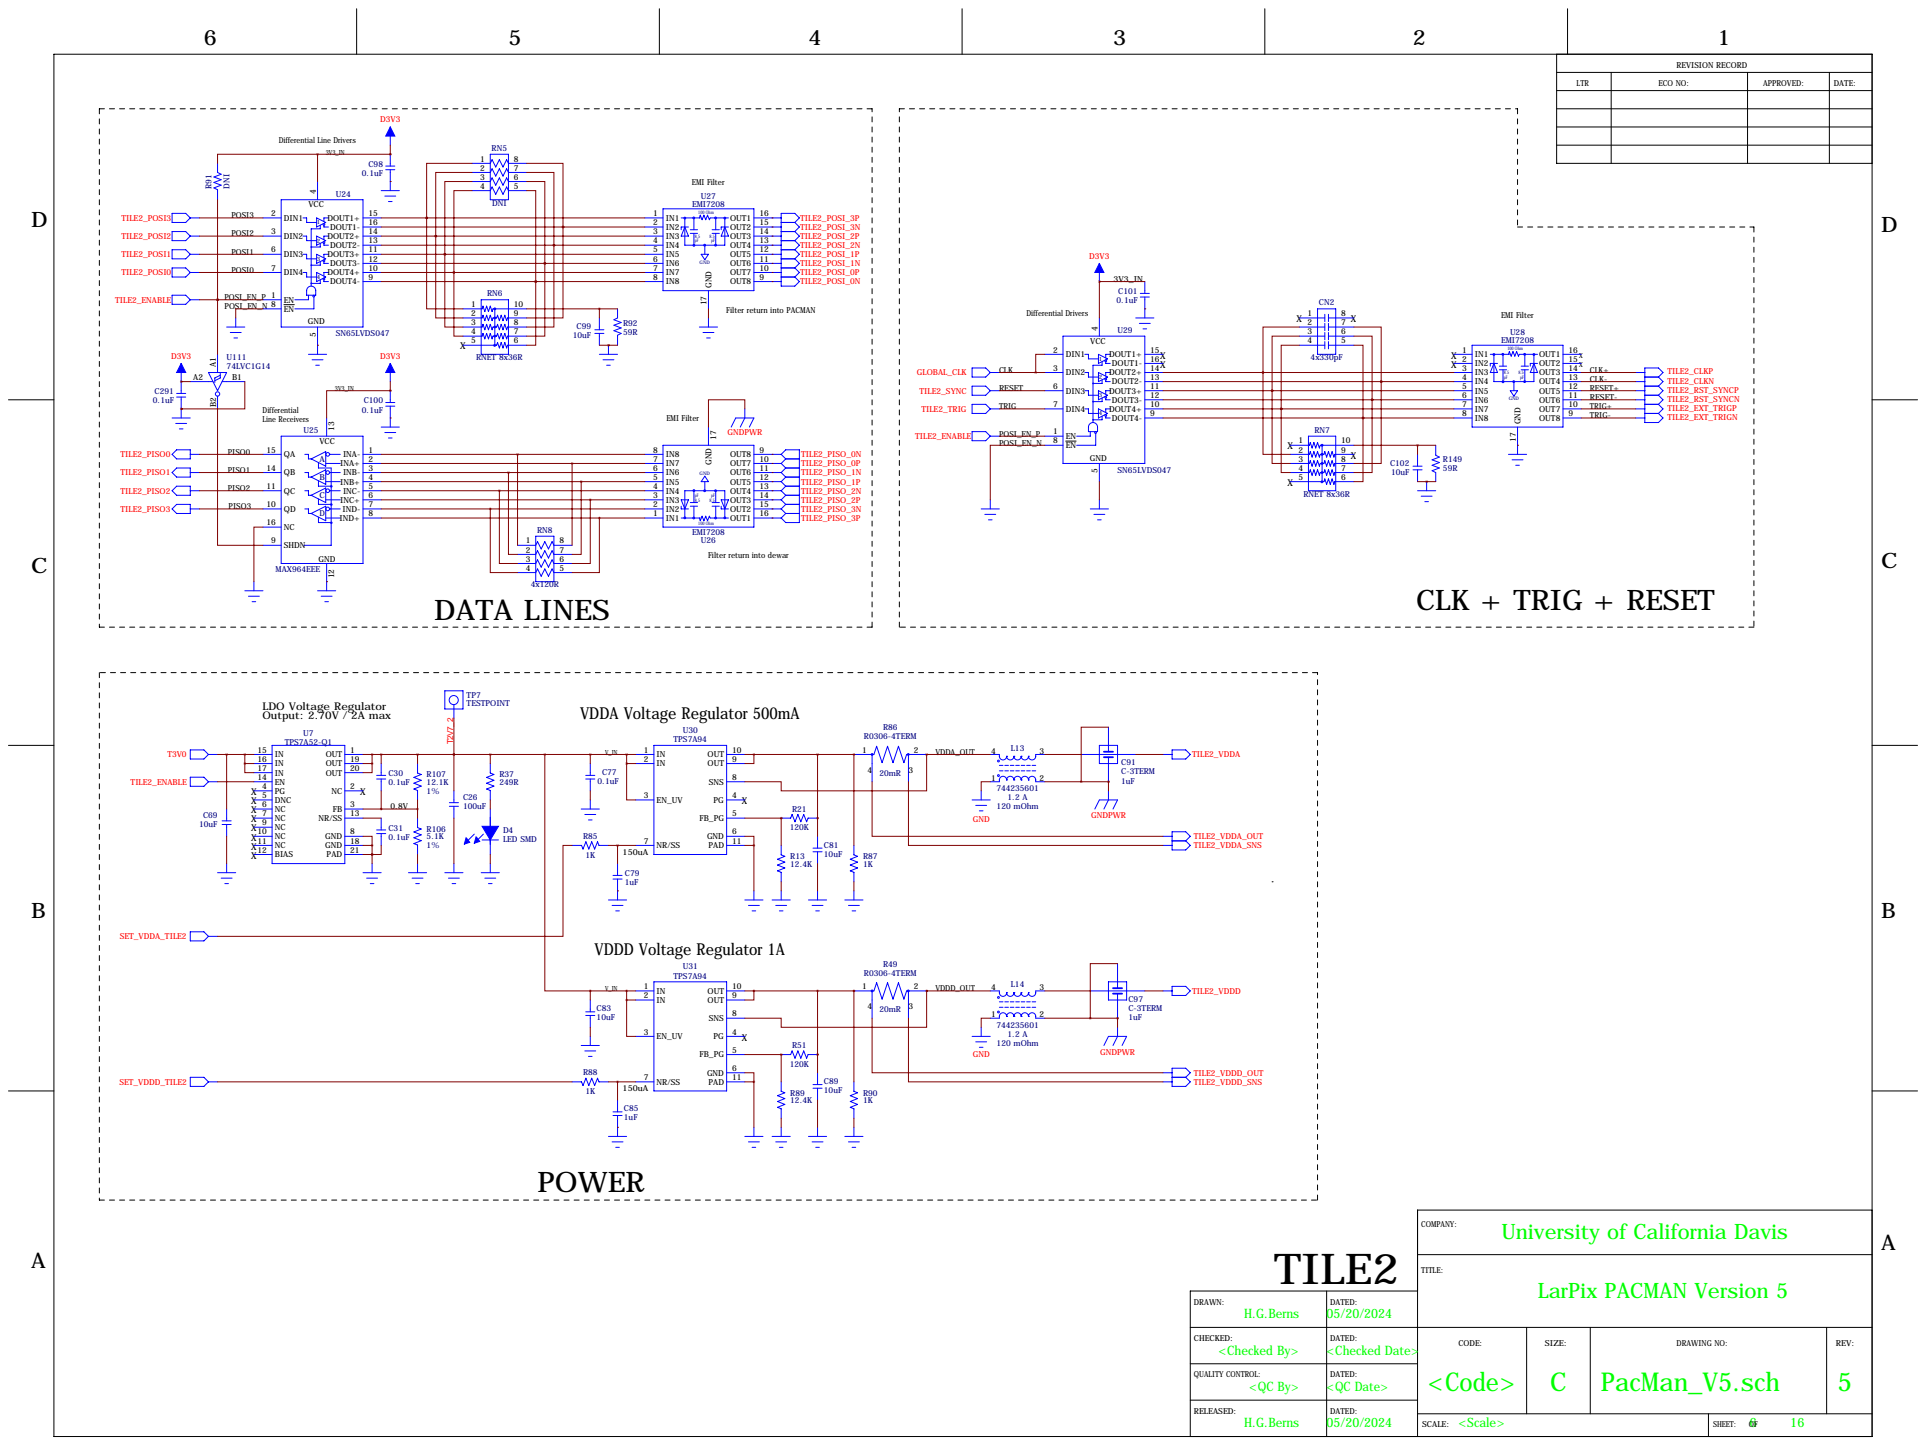
[picture p9: page 6]

Filter return into PACMAN

Filter return into dewar

University of California Davis

DRAWN: H.G.Berns | DATED: 05/20/2024

CHECKED: | DATED: | CODE: | SIZE: | DRAWING NO: | REV:

D
D

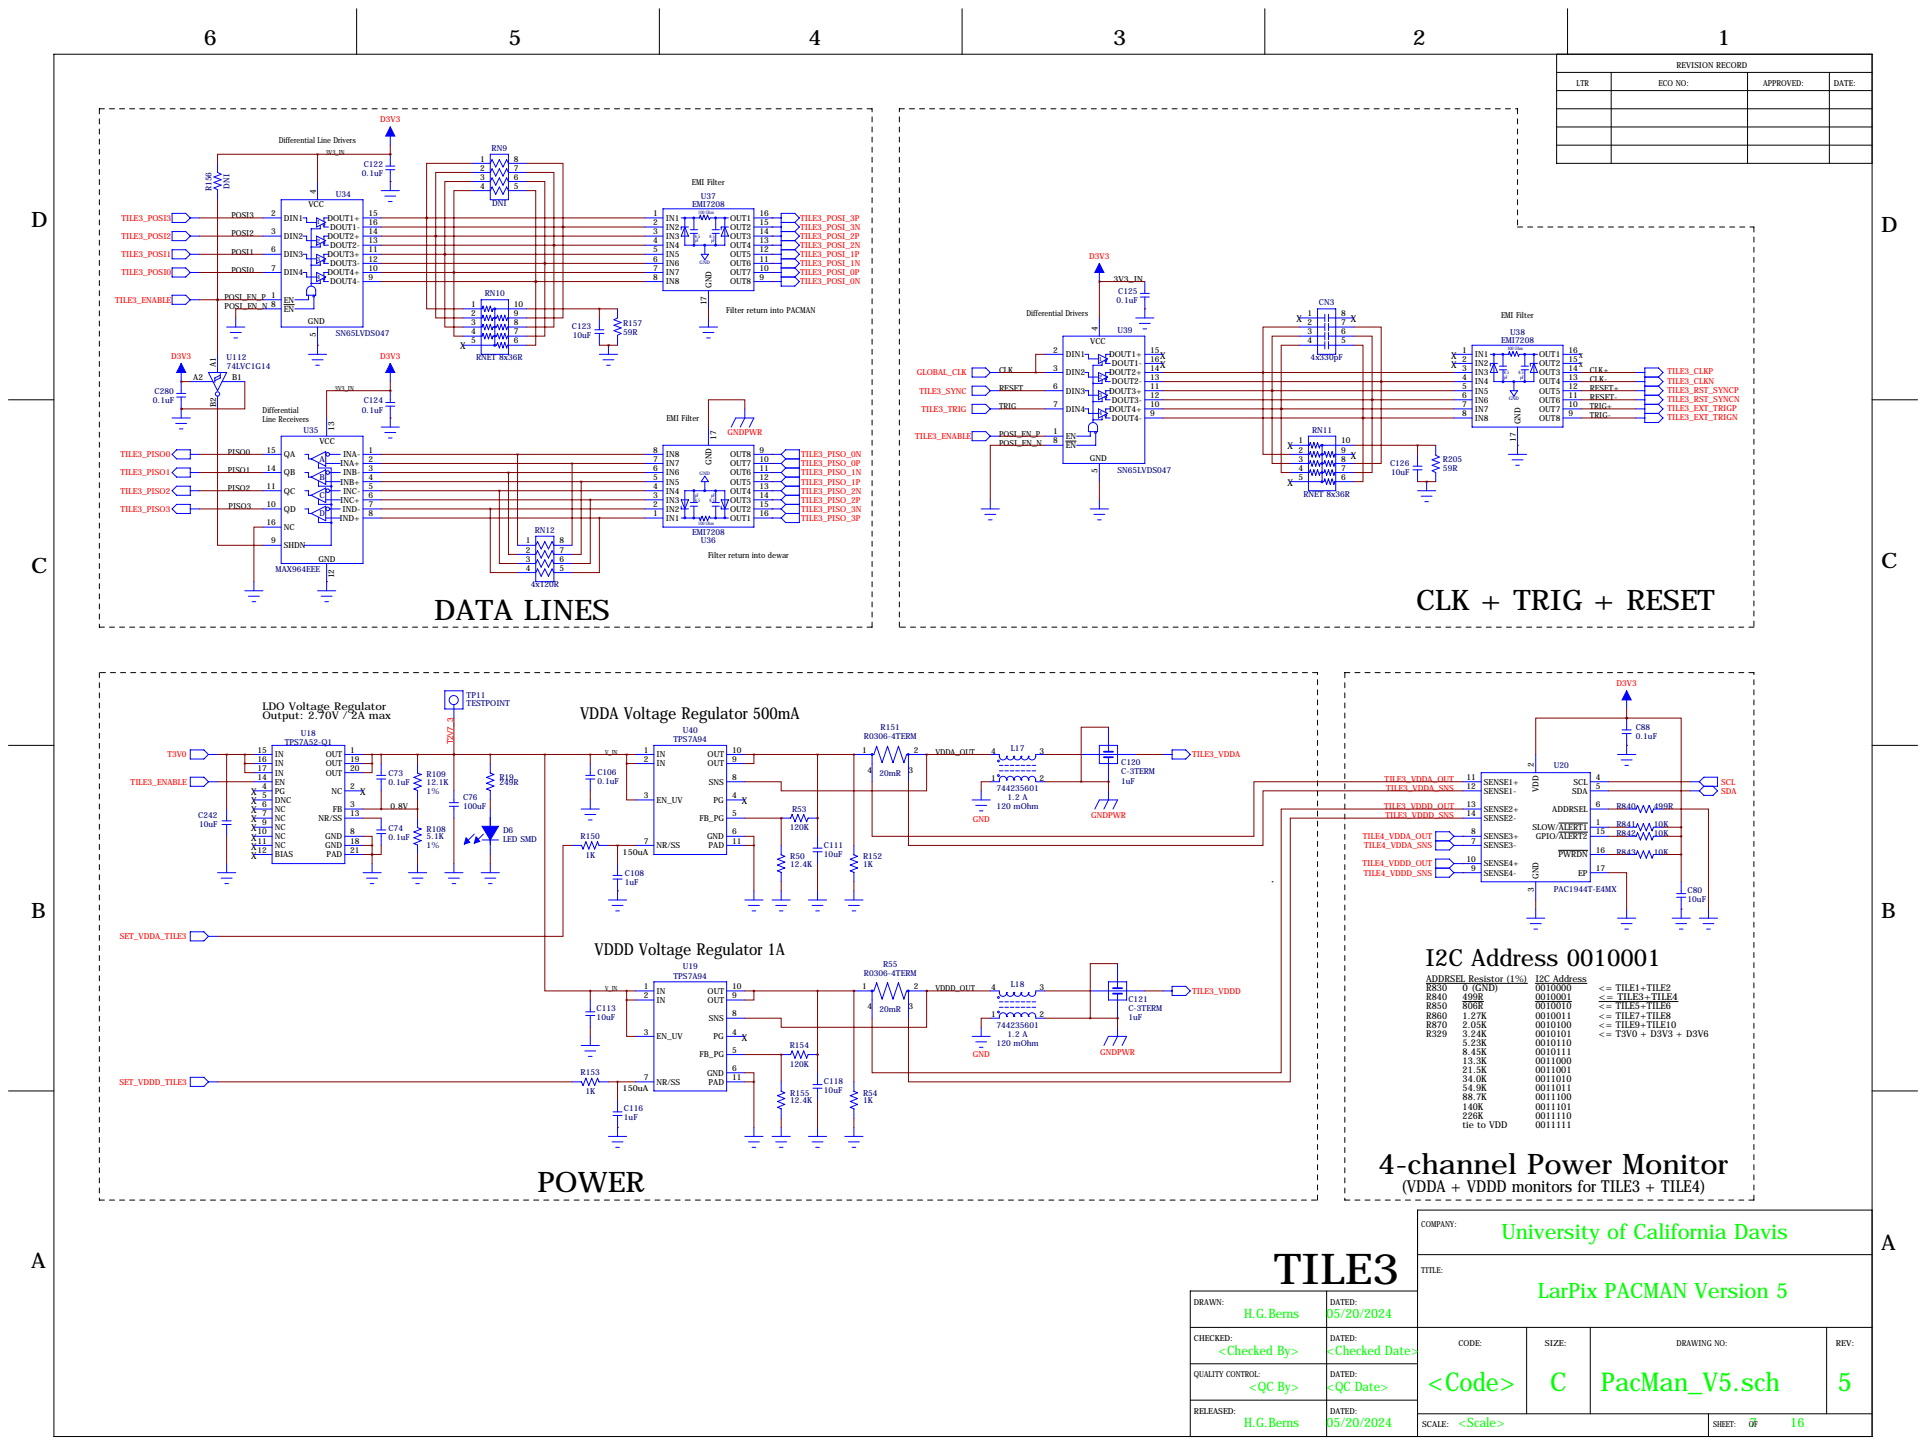
[picture p10: page 7]

Filter return into PACMAN

Filter return into dewar

4-channel Power Monitor
(VDDA + VDDD monitors for TILE3 + TILE4)

University of California Davis

DRAWN: H.G.Berns | DATED: 05/20/2024

CHECKED: | DATED: | CODE: | SIZE: | DRAWING NO: | REV:

D
D

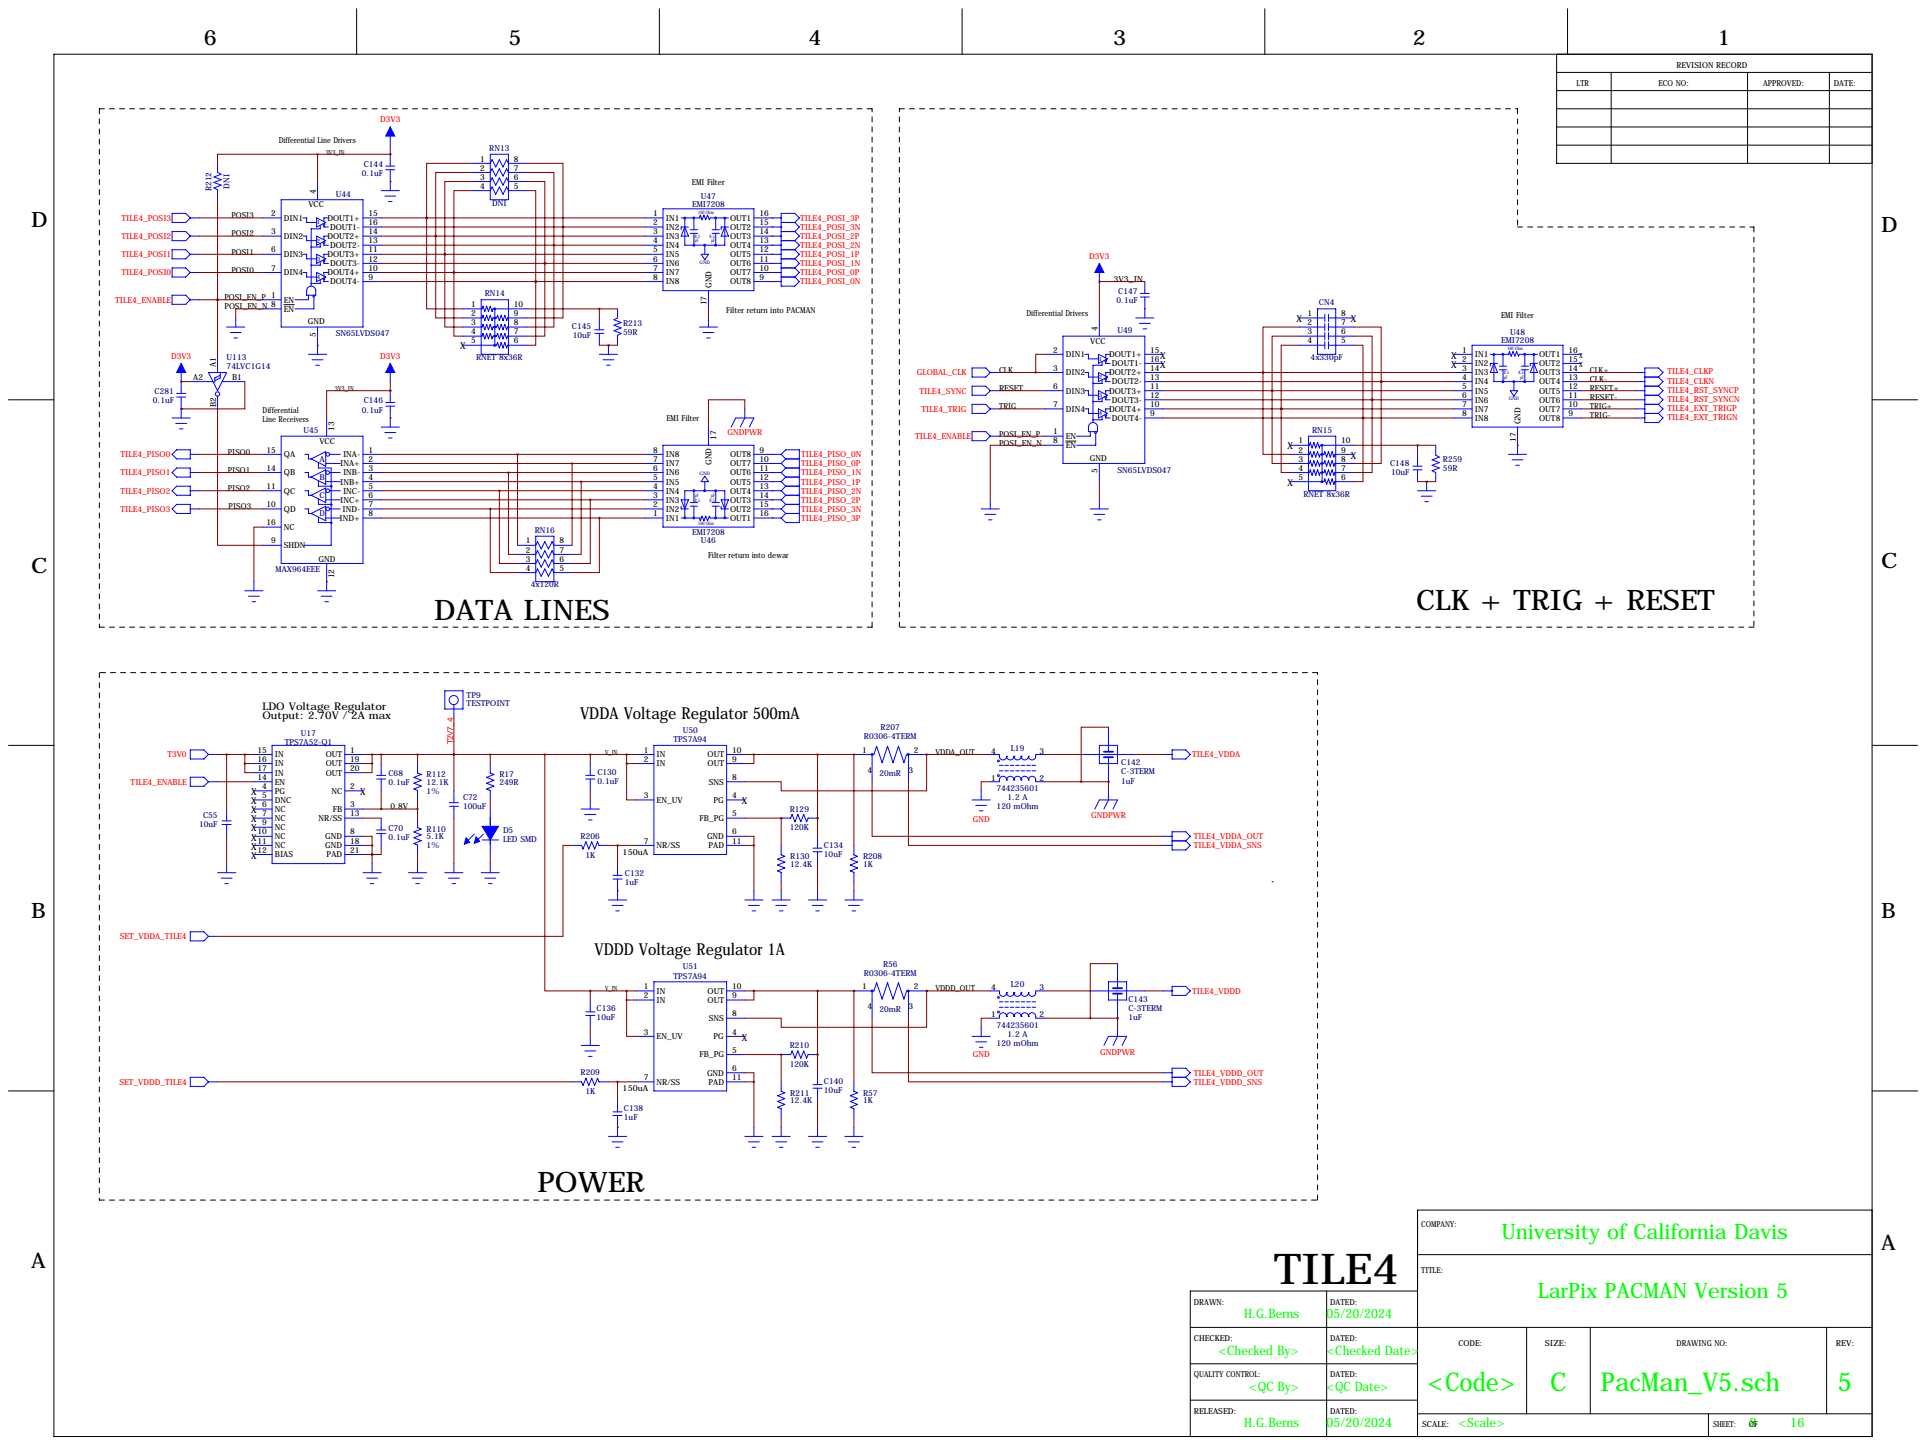
[picture p11: page 8]

Filter return into PACMAN

Filter return into dewar

University of California Davis

DRAWN: H.G.Berns | DATED: 05/20/2024

CHECKED: | DATED: | CODE: | SIZE: | DRAWING NO: | REV:

D
D

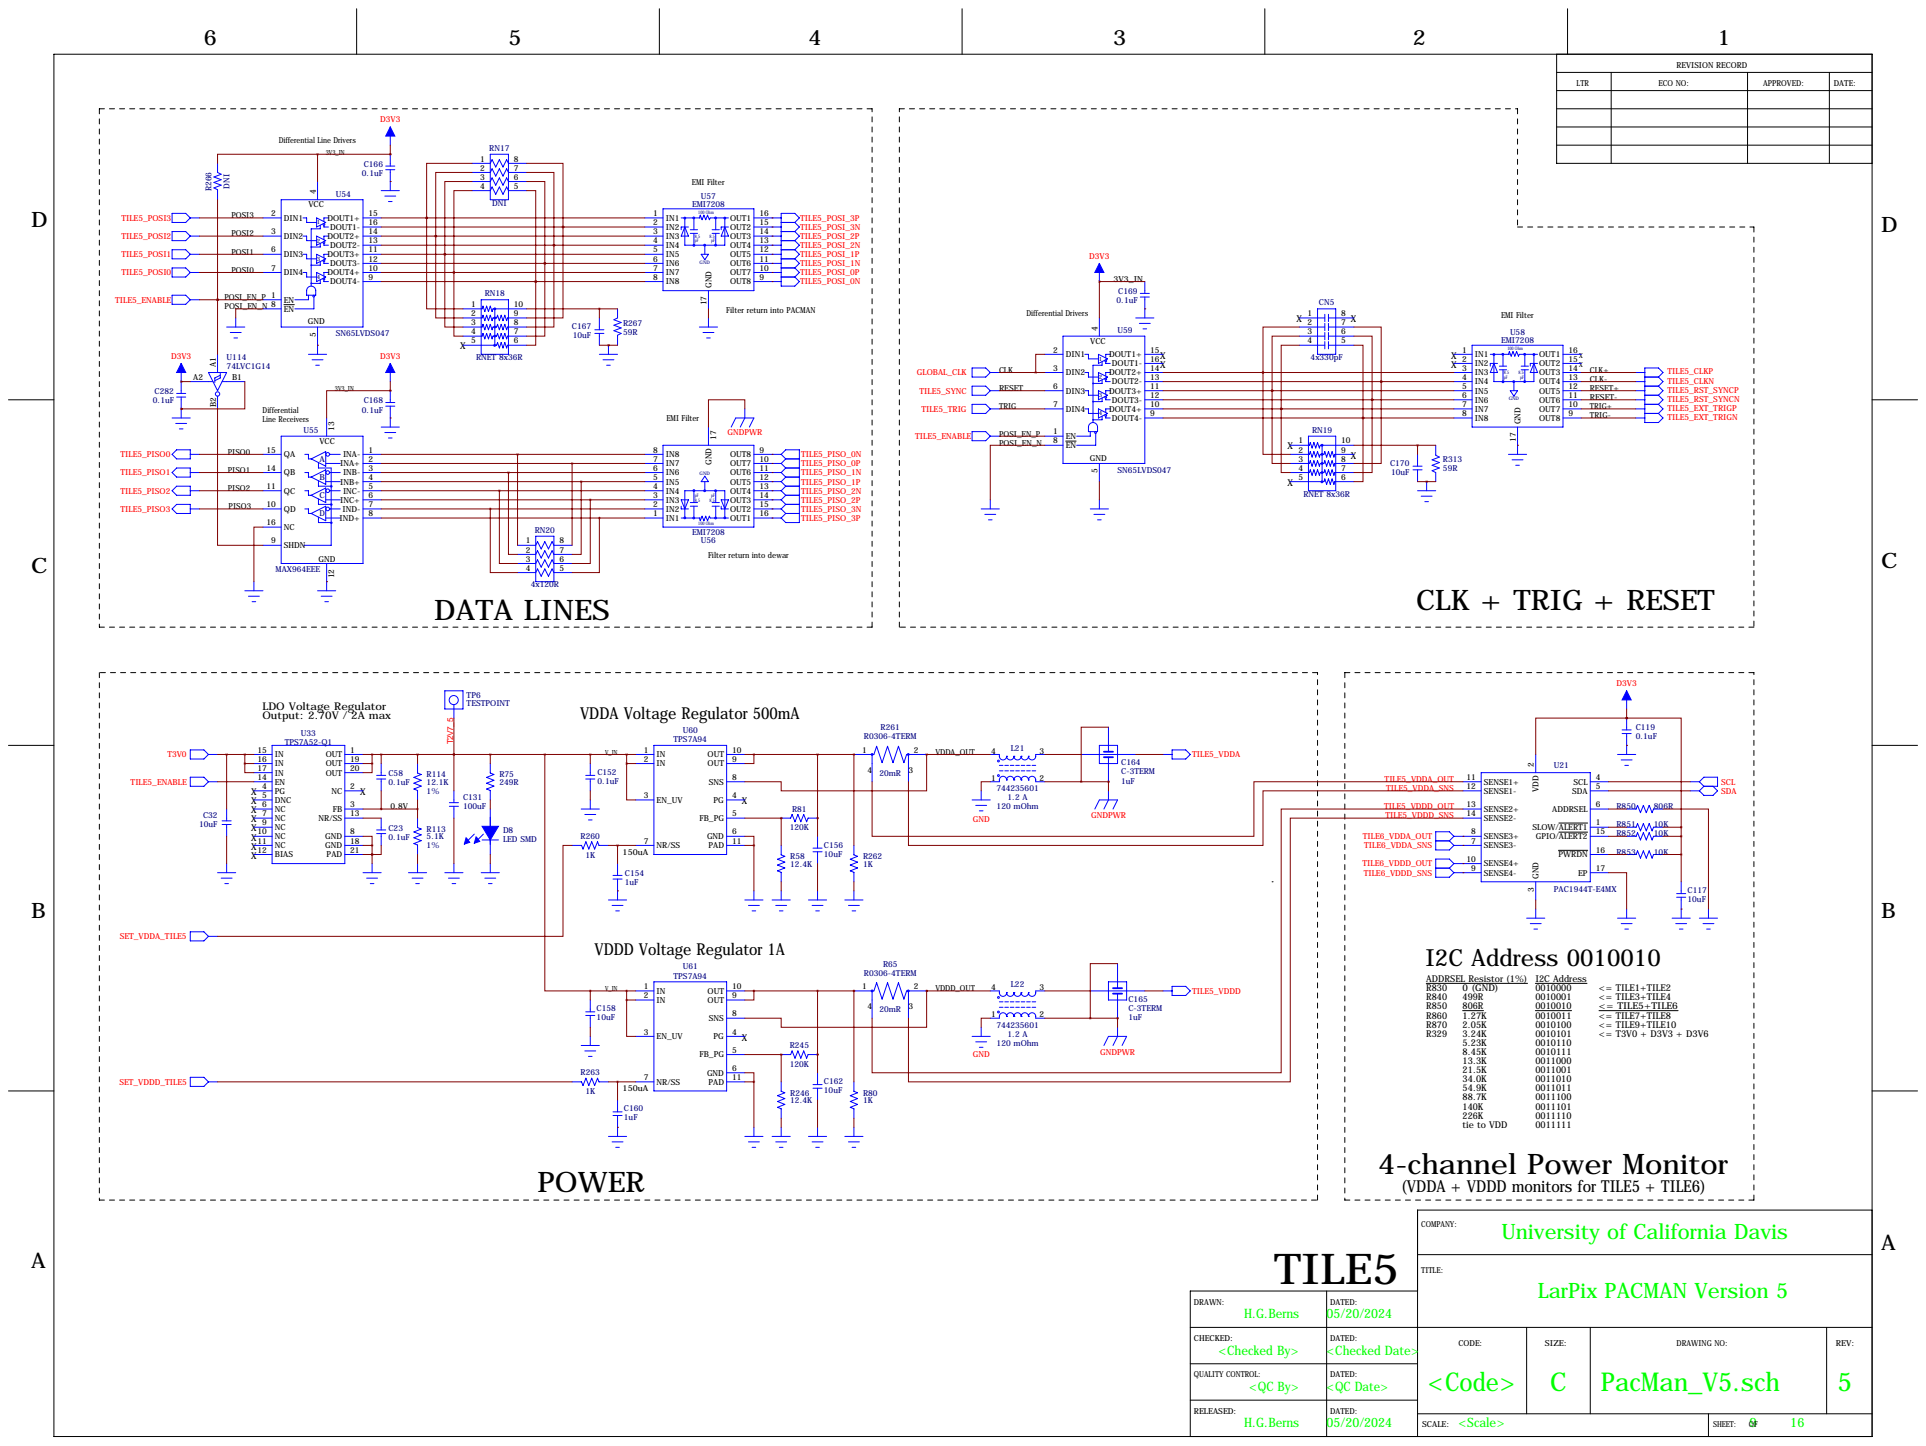
[picture p12: page 9]

Filter return into PACMAN

Filter return into dewar

4-channel Power Monitor
(VDDA + VDDD monitors for TILE5 + TILE6)

University of California Davis

DRAWN: H.G.Berns | DATED: 05/20/2024

CHECKED: | DATED: | CODE: | SIZE: | DRAWING NO: | REV:

D
D

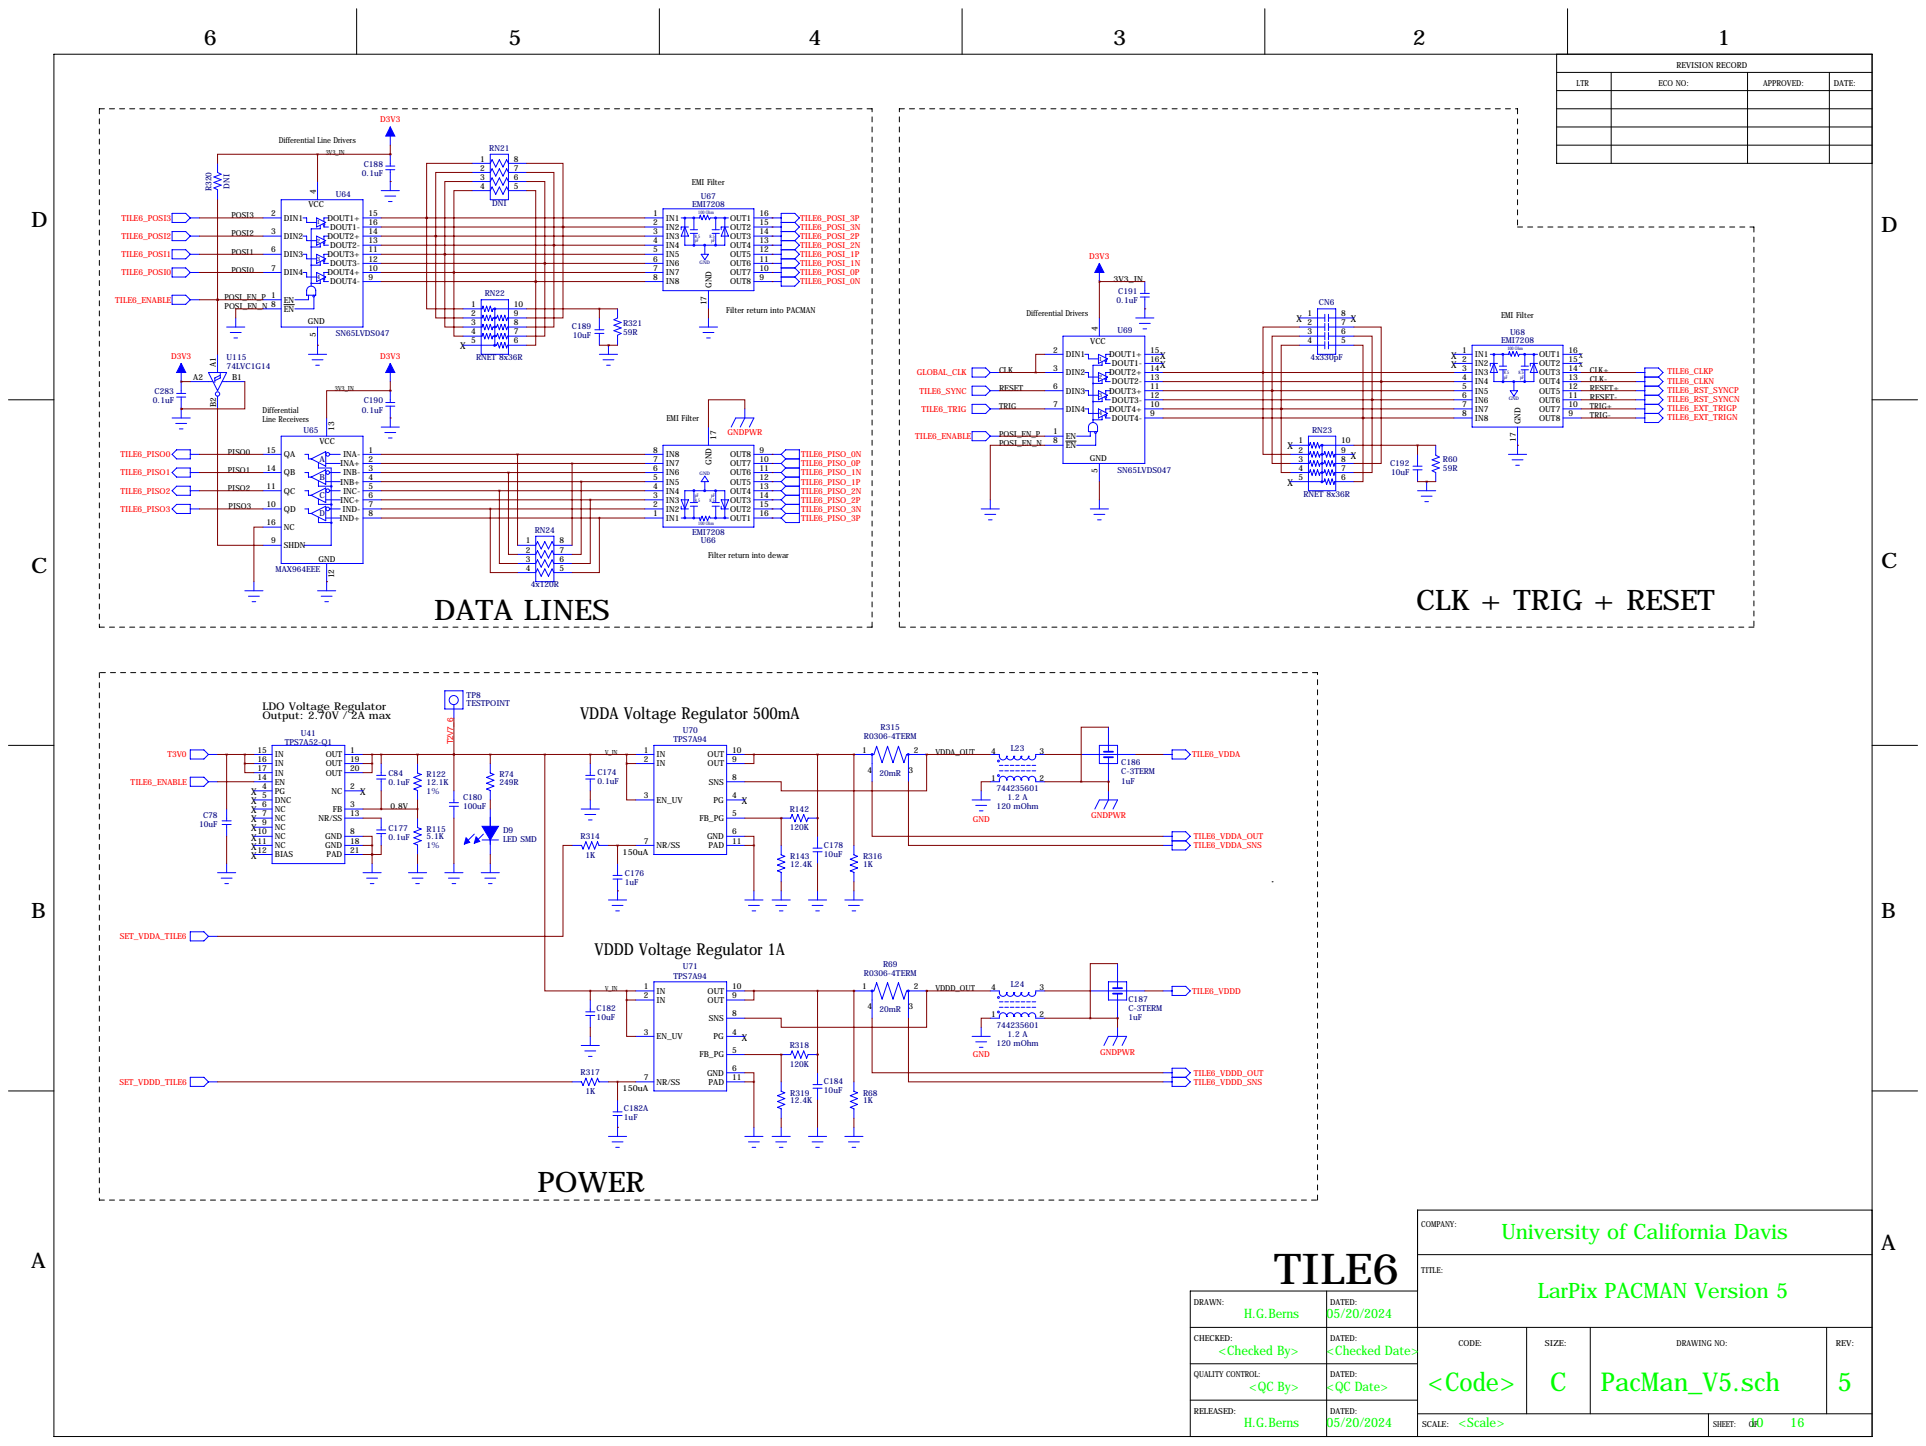
[picture p13: page 10]

Filter return into PACMAN

Filter return into dewar

University of California Davis

DRAWN: H.G.Berns | DATED: 05/20/2024

CHECKED: | DATED: | CODE: | SIZE: | DRAWING NO: | REV:

D
D

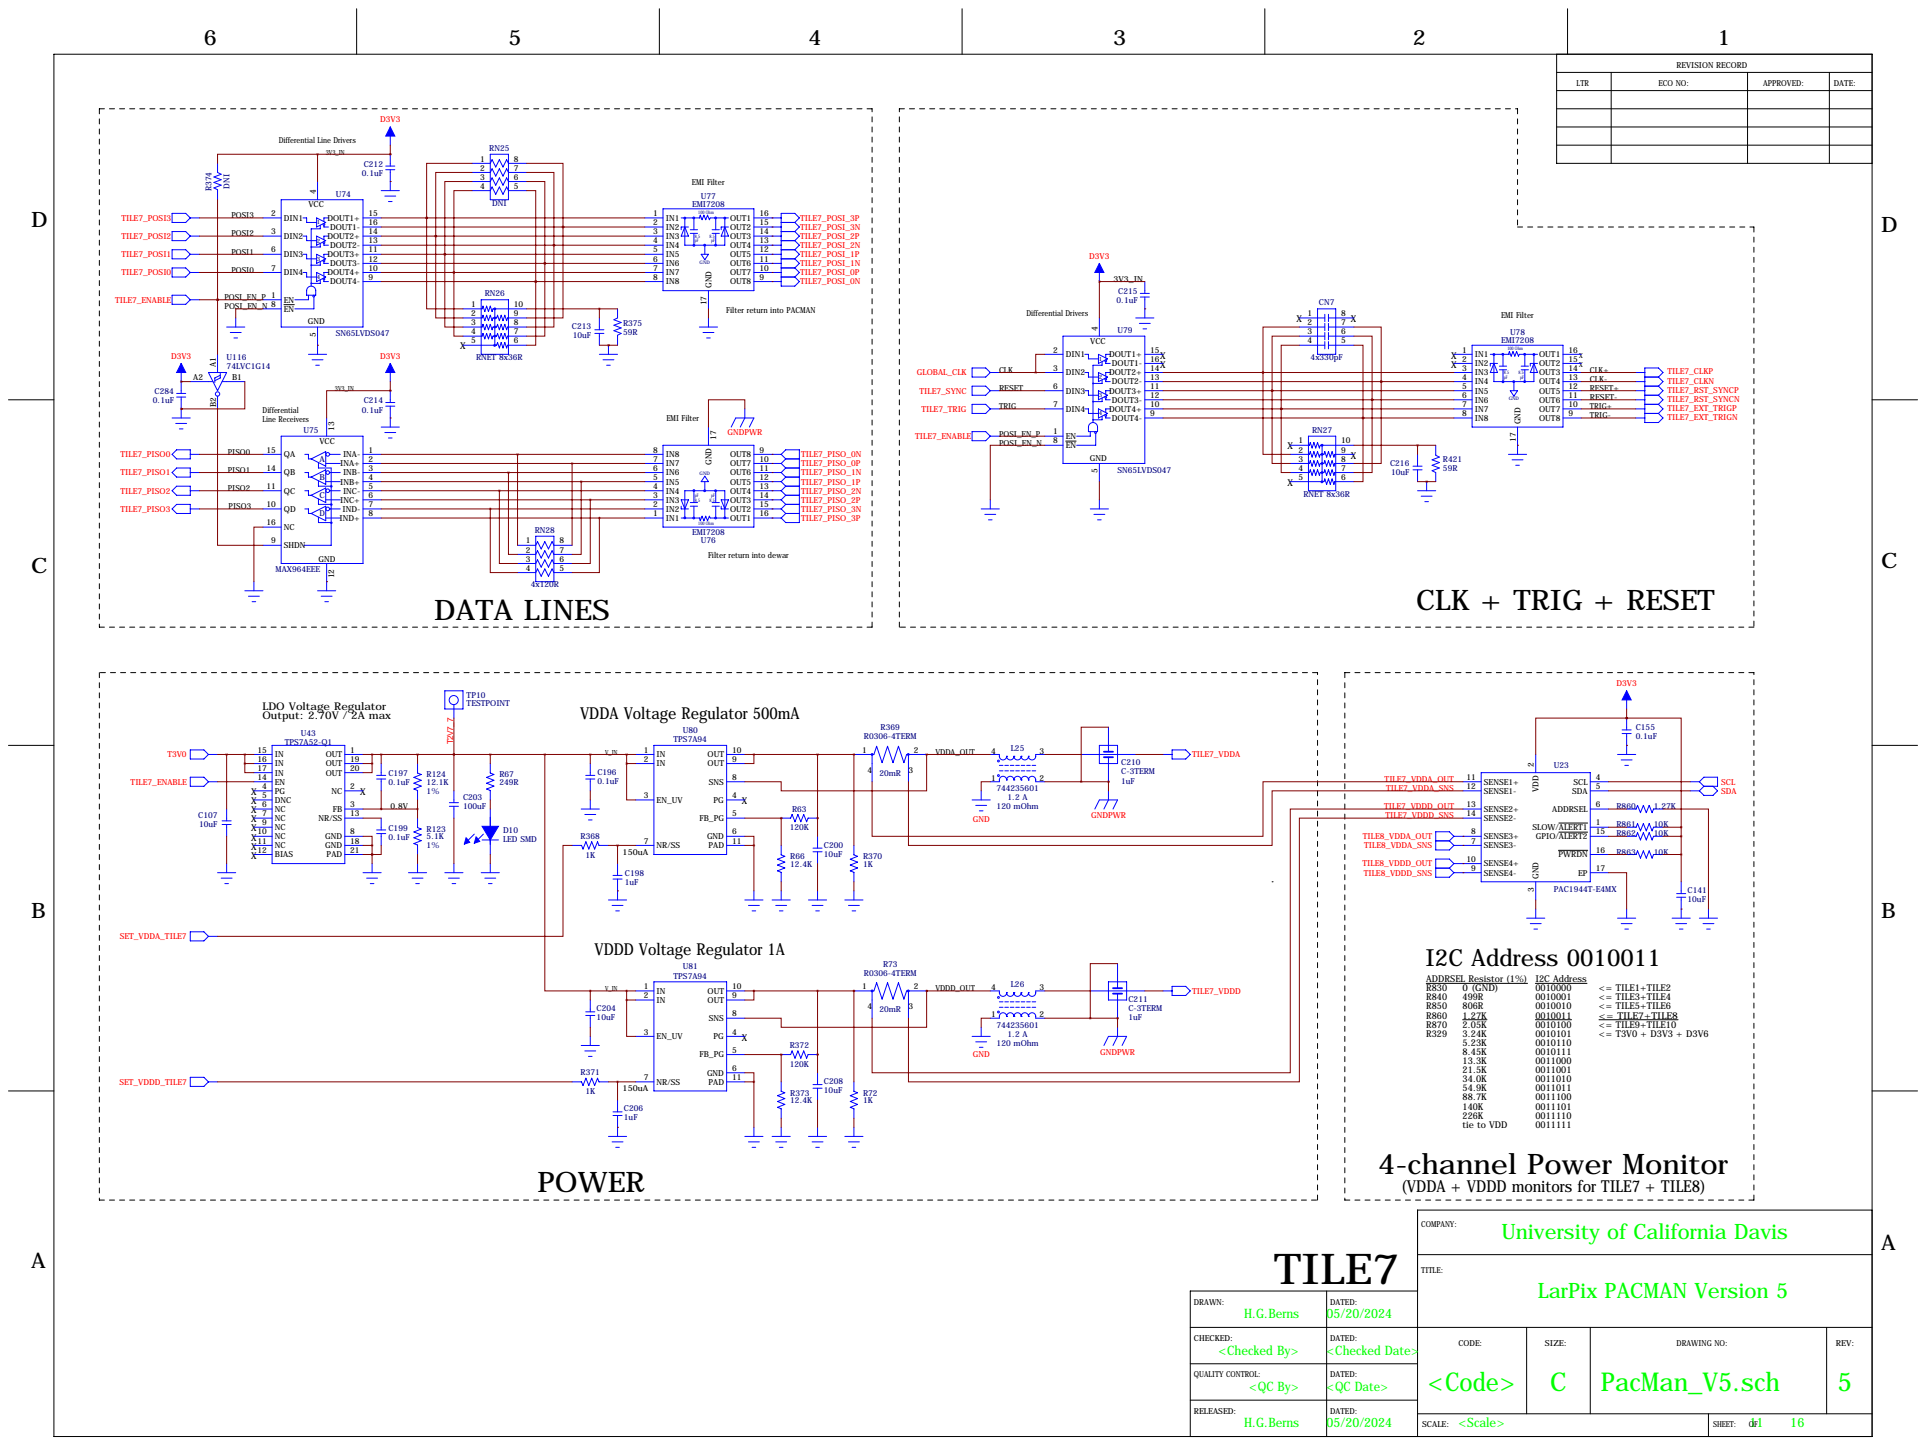
[picture p14: page 11]

Filter return into PACMAN

Filter return into dewar

4-channel Power Monitor
(VDDA + VDDD monitors for TILE7 + TILE8)

University of California Davis

DRAWN: H.G.Berns | DATED: 05/20/2024

CHECKED: | DATED: | CODE: | SIZE: | DRAWING NO: | REV:

D
D

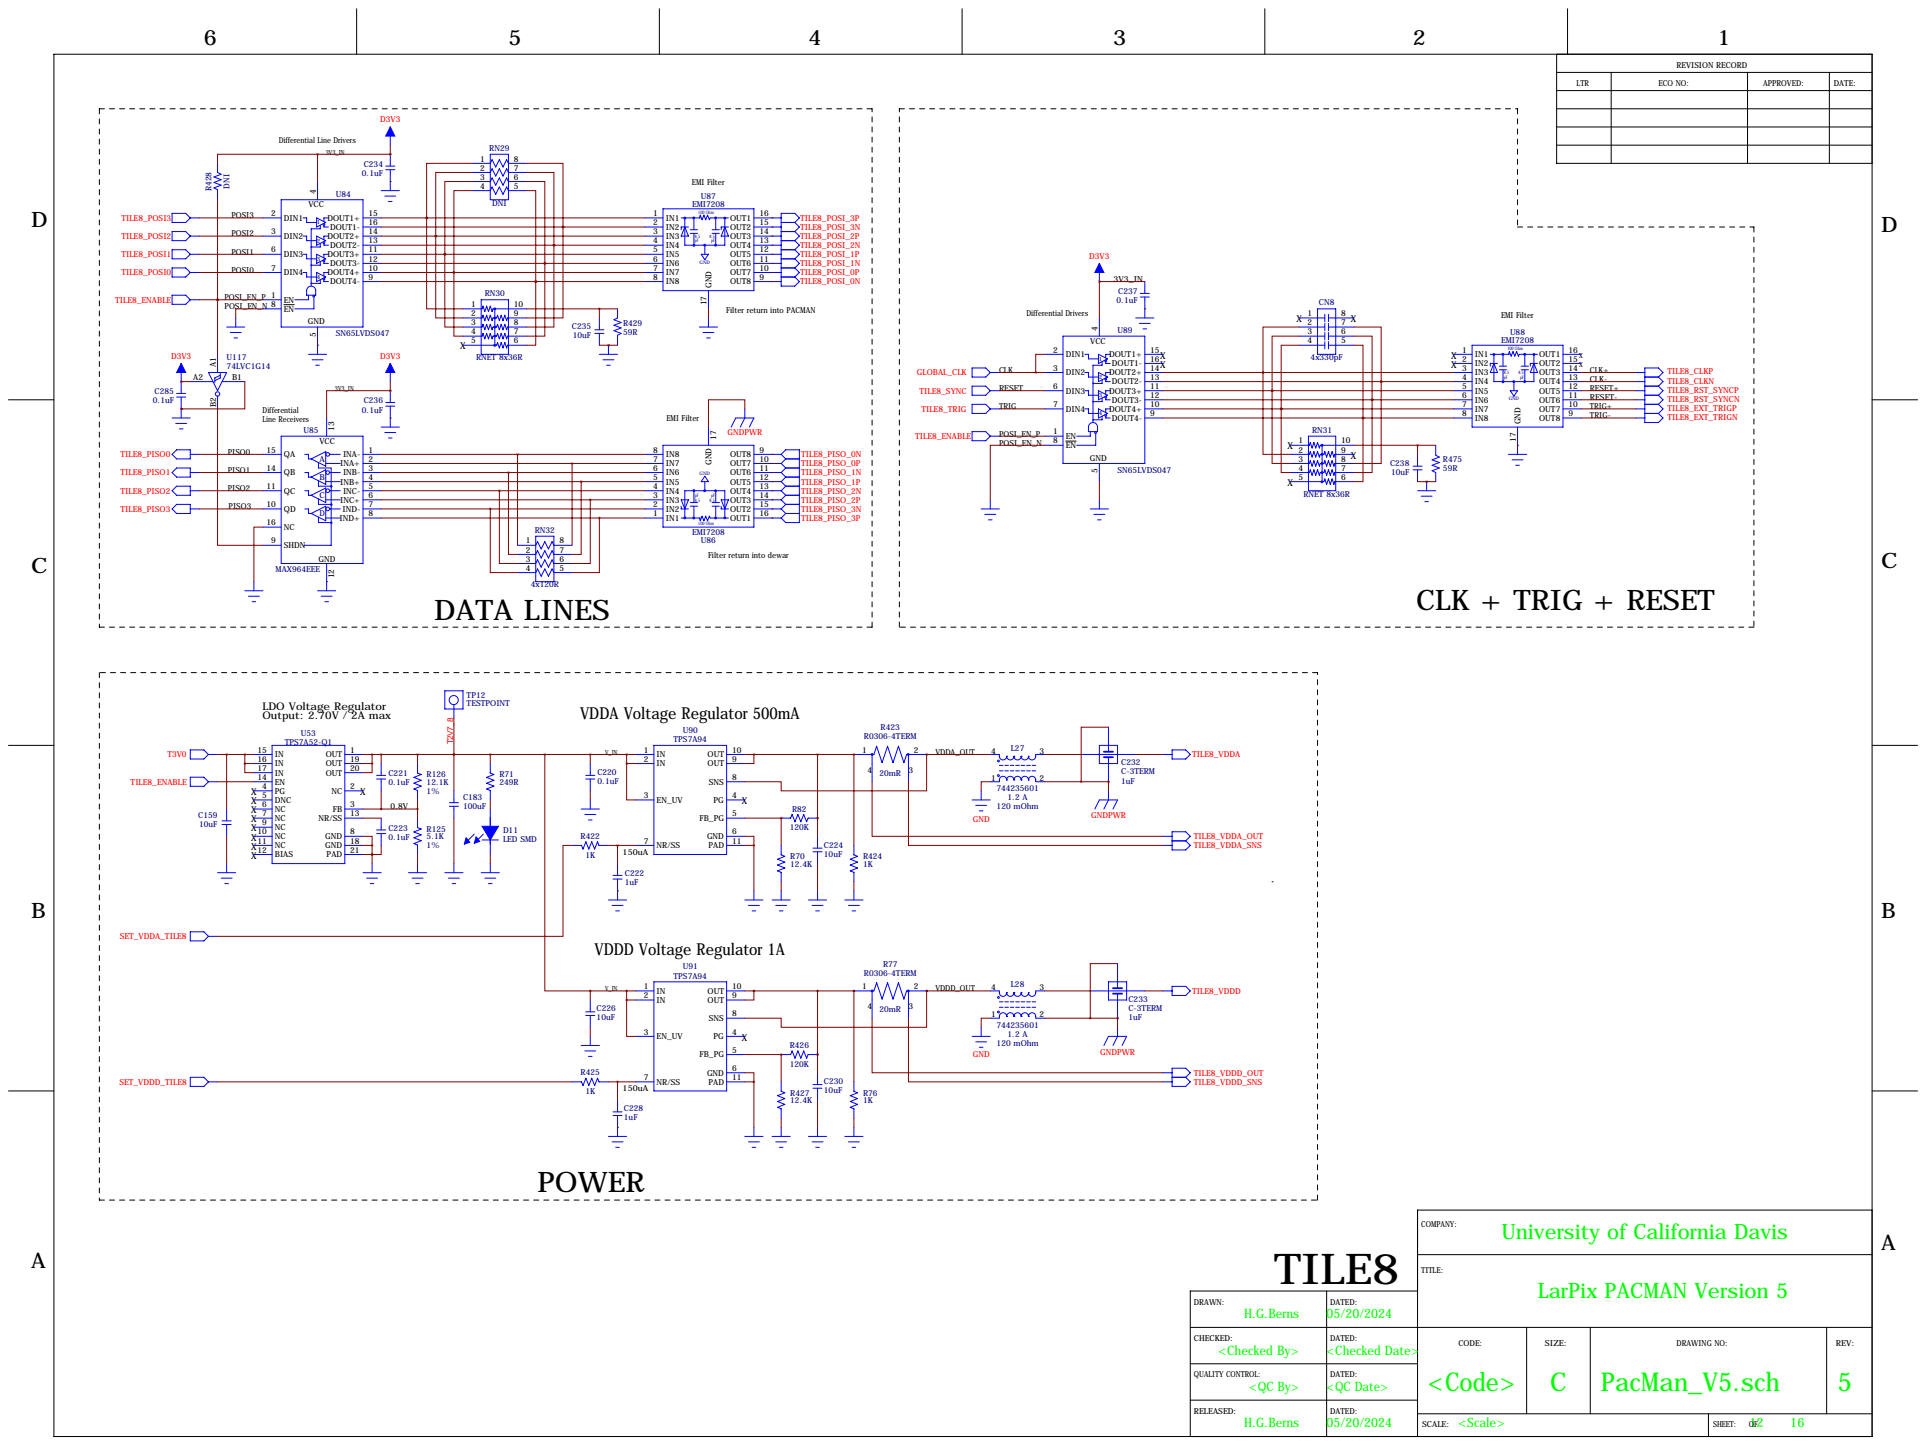
[picture p15: page 12]

Filter return into PACMAN

Filter return into dewar

University of California Davis

DRAWN: H.G.Berns | DATED: 05/20/2024

CHECKED: | DATED: | CODE: | SIZE: | DRAWING NO: | REV:

D
D

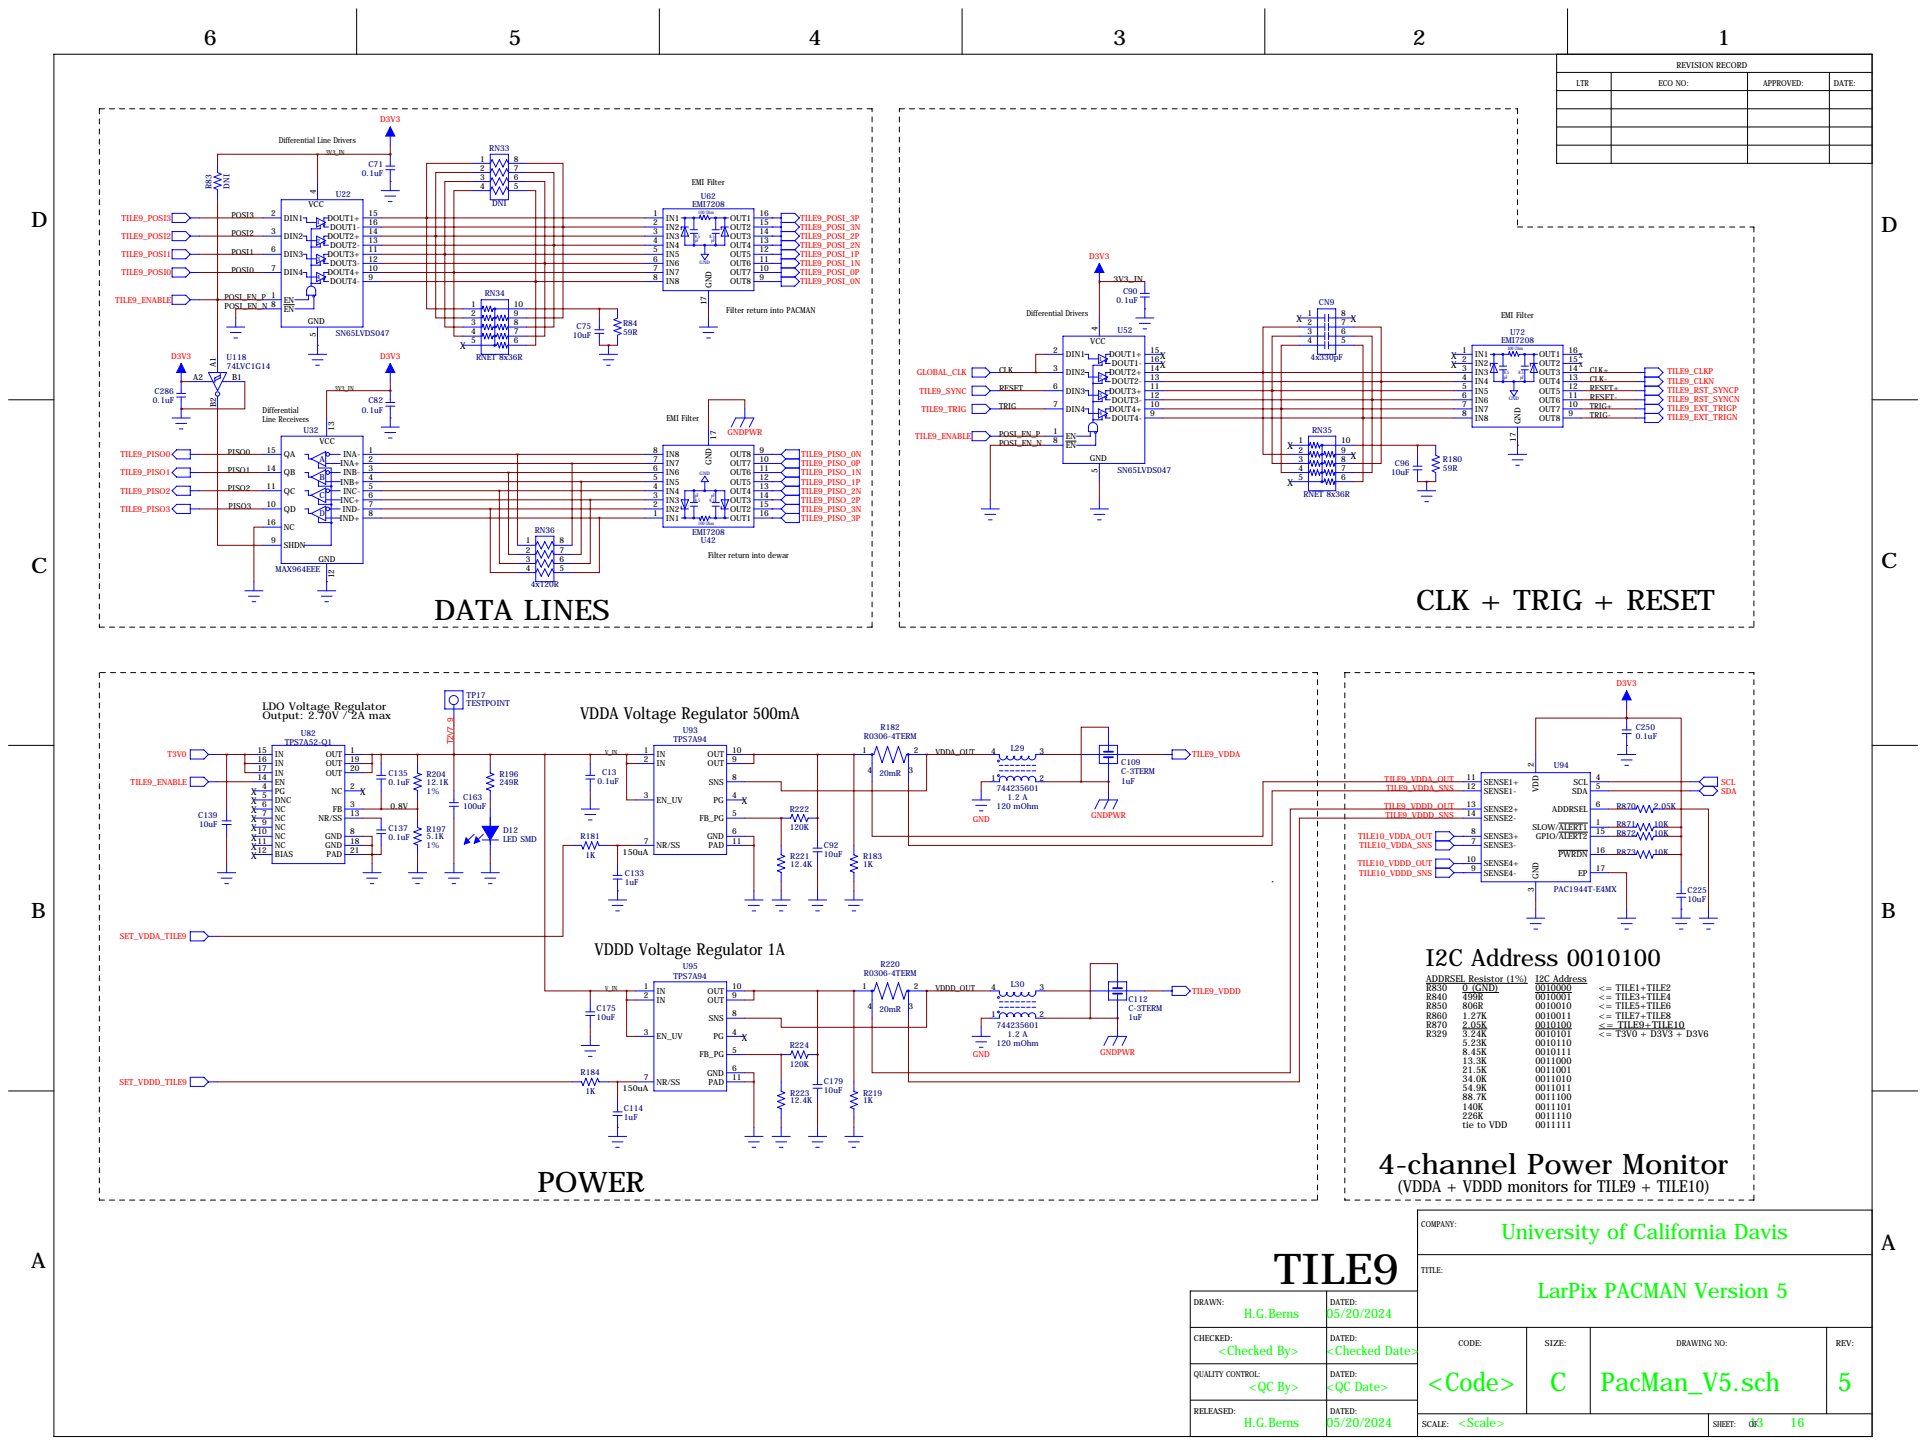
[picture p16: page 13]

Filter return into PACMAN

Filter return into dewar

4-channel Power Monitor
(VDDA + VDDD monitors for TILE9 + TILE10)

University of California Davis

DRAWN: H.G.Berns | DATED: 05/20/2024

CHECKED: | DATED: | CODE: | SIZE: | DRAWING NO: | REV:

D
D

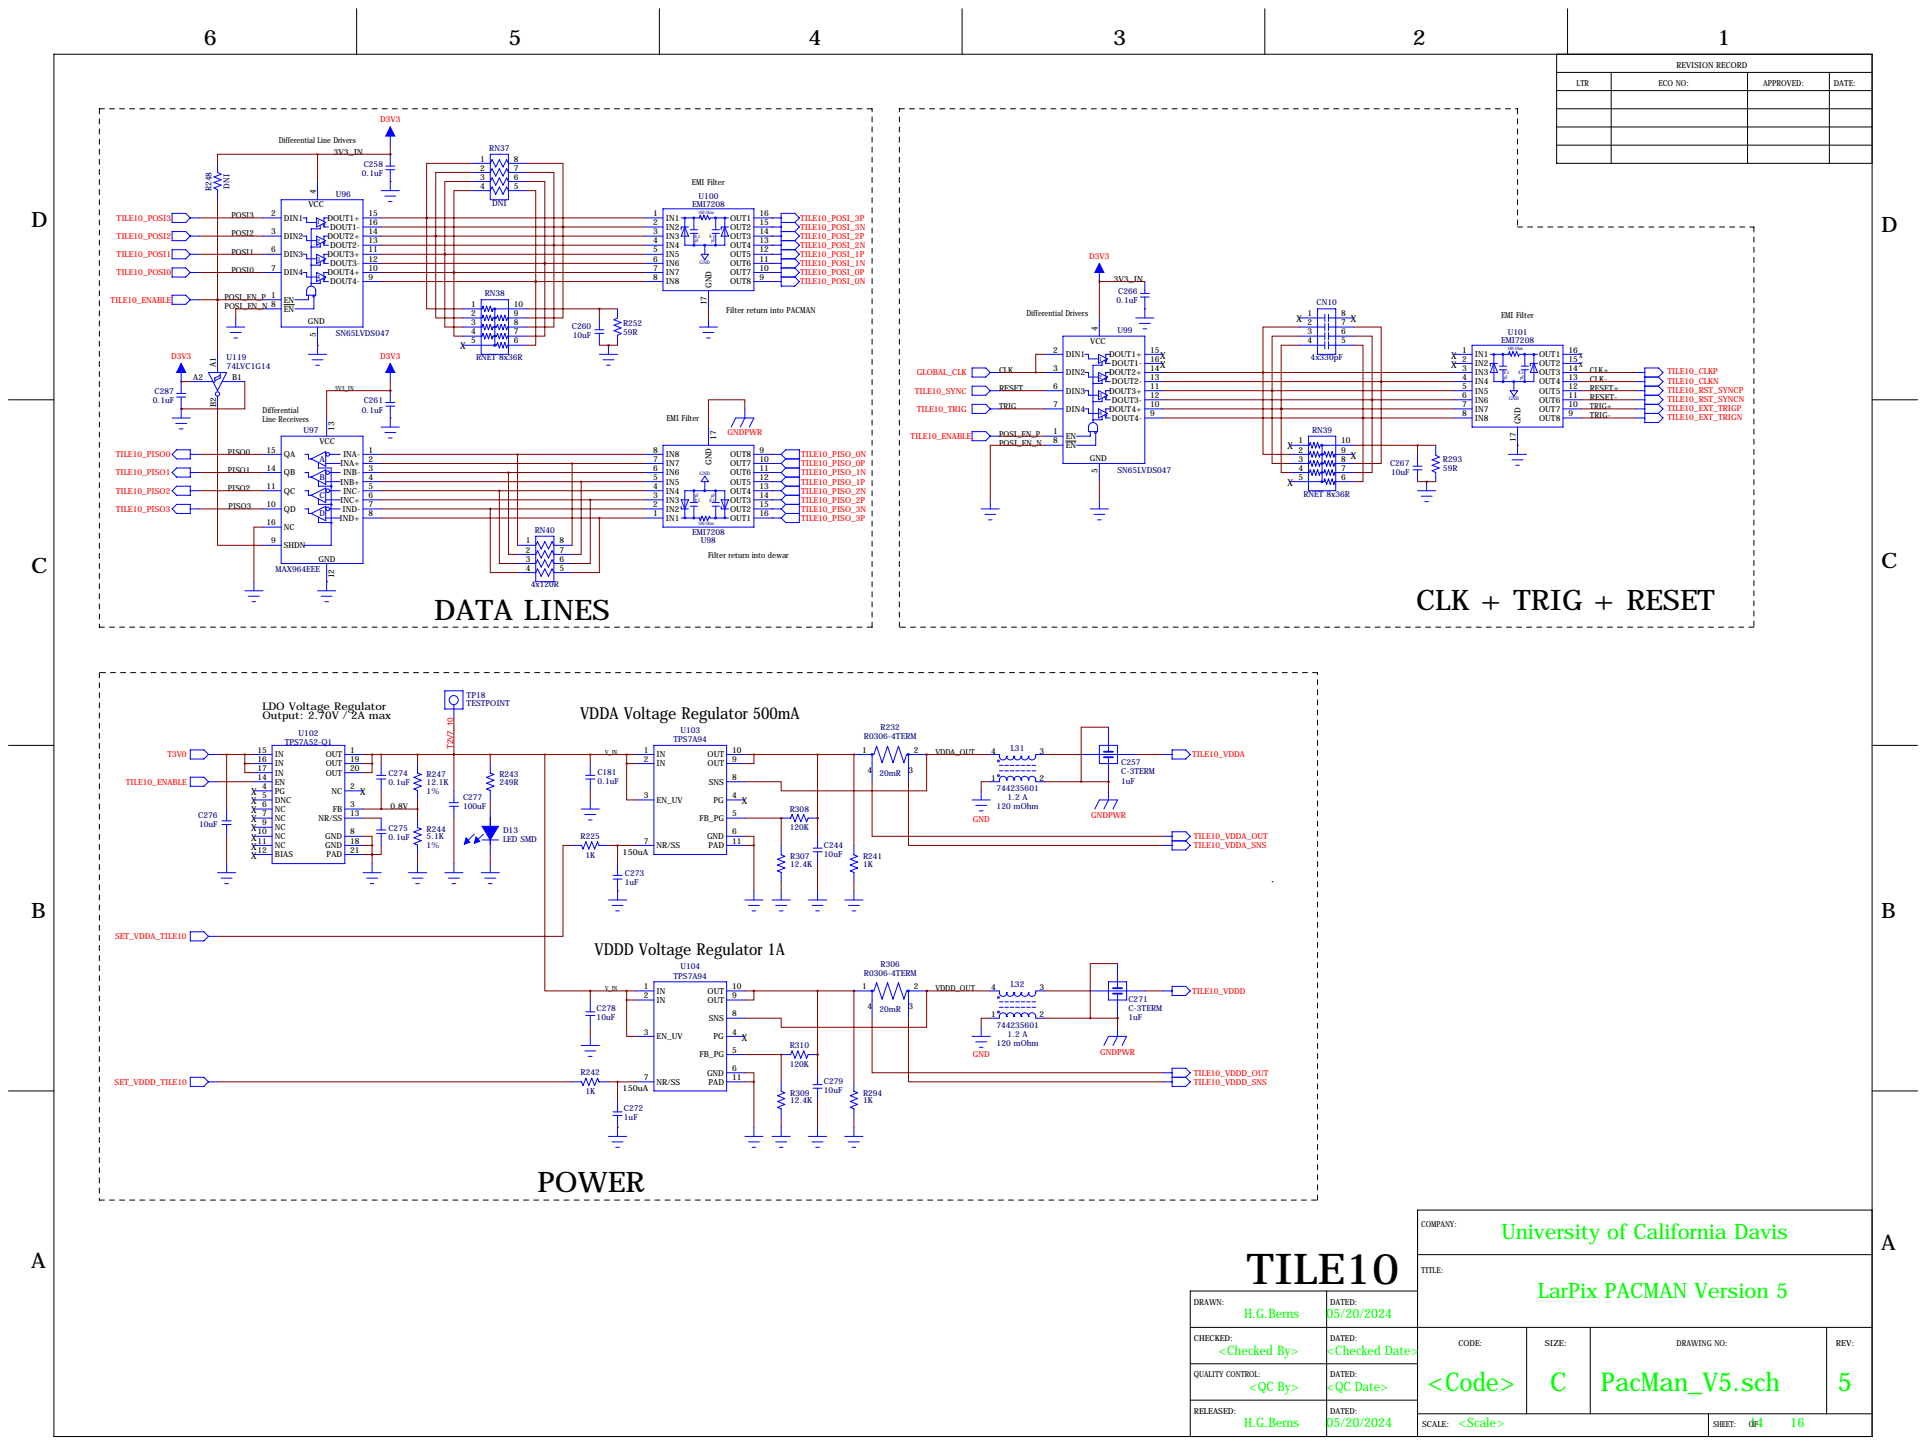
[picture p17: page 14]

Filter return into PACMAN

Filter return into dewar

University of California Davis

DRAWN: H.G.Berns | DATED: 05/20/2024

CHECKED: | DATED: | CODE: | SIZE: | DRAWING NO: | REV:

D
D

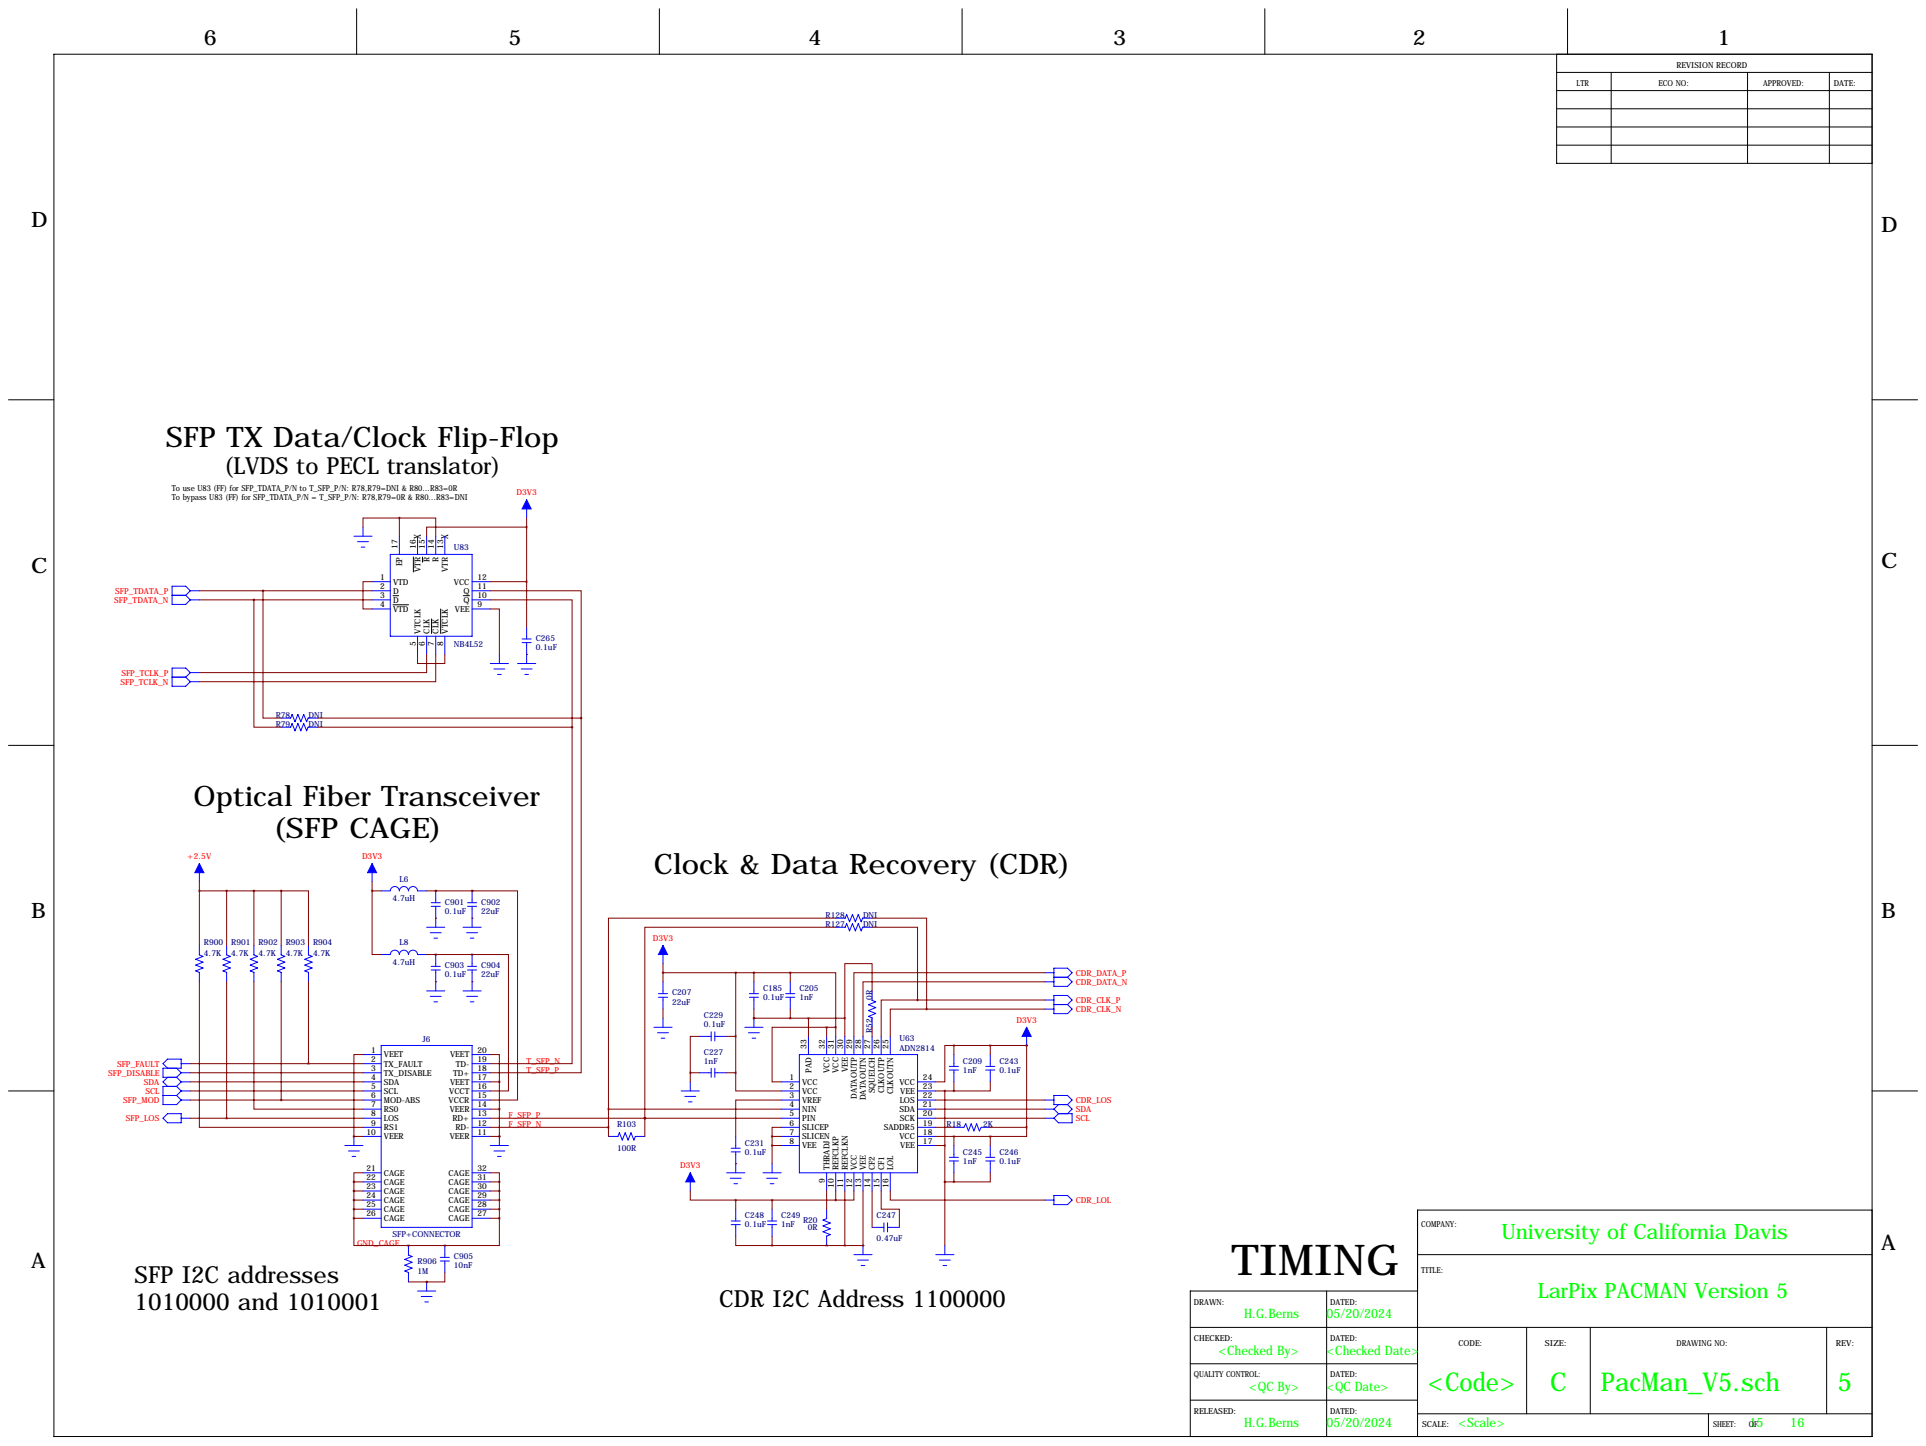
[picture p18: page 15]

SFP TX Data/Clock Flip-Flop
(LVDS to PECL translator)

To use U83 (FF) for SFP_TDATA_P/N to T_SFP_P/N: R78,R79=DNI & R80...R83=0R
To bypass U83 (FF) for SFP_TDATA_P/N = T_SFP_P/N: R78,R79=0R & R80...R83=DNI

VTD 2 | 11 Q
3 | | 10 Q

Clock & Data Recovery (CDR)

20 VEET 19 TD-18 TD+ 17 VEET 16 VCCT 15 VCCR 14 VEER 13 RD+ 12 RD-11 VEER | F_SFP_P

T_SFP_P

F_SFP_N | | PIN 6

9 THRADJ 10 REFCLKP 11 REFCLKN 12 VCC 13 VEE 14 CF2 15 CF1 16 LOL

University of California Davis

DRAWN: H.G.Berns | DATED: 05/20/2024

CHECKED: | DATED: | CODE: | SIZE: | DRAWING NO: | REV:

D
D

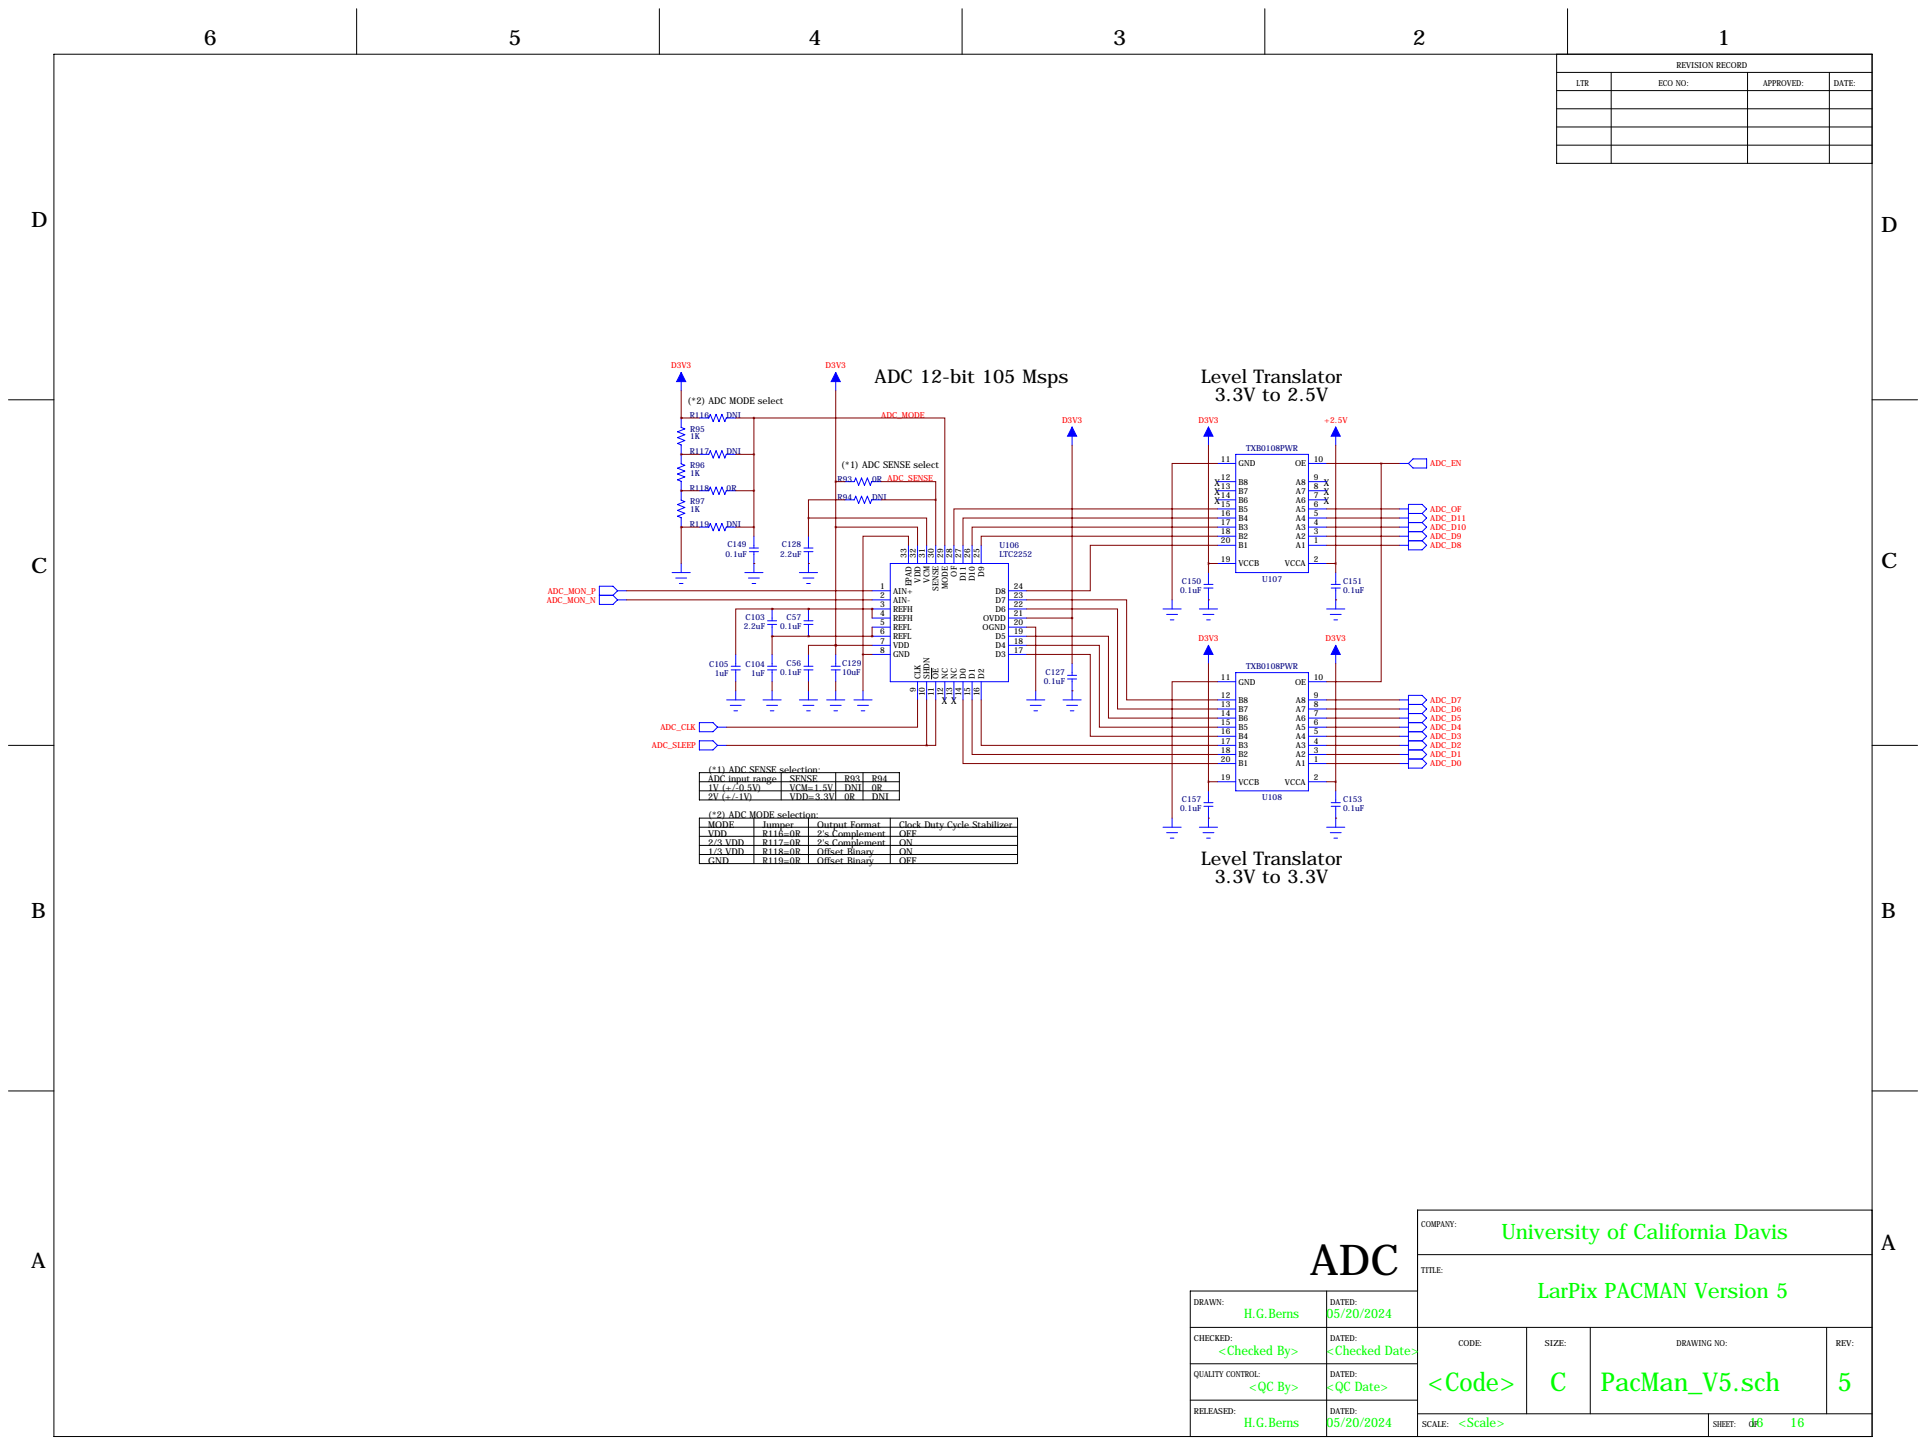
[picture p19: page 16]

REFH 4 | 21 OVDD
REFH 5 | 20 OGND
REFL 6 | 19 D5
REFL 7 | 18 D4
VDD 8

9 CLK 10 SHDN 11 OE 12 NC 13 NC 14 D0 15 D1 16 D2

ADC input range | SENSE | R93 | R94
1V (+/-0.5V) | VCM=1.5V | DNI | 0R
2V (+/-1V) | VDD=3.3V | 0R | DNI

MODE | Jumper | Output Format | Clock Duty Cycle Stabilizer
VDD | R116=0R | 2's Complement | OFF
2/3 VDD | R117=0R | 2's Complement | ON
1/3 VDD | R118=0R | Offset Binary | ON
GND | R119=0R

University of California Davis

DRAWN: H.G.Berns | DATED: 05/20/2024

CHECKED: | DATED: | CODE: | SIZE: | DRAWING NO: | REV:
