mulhearn/pacman/docs/legacy/v1r2/scheme_v1r2.pdf

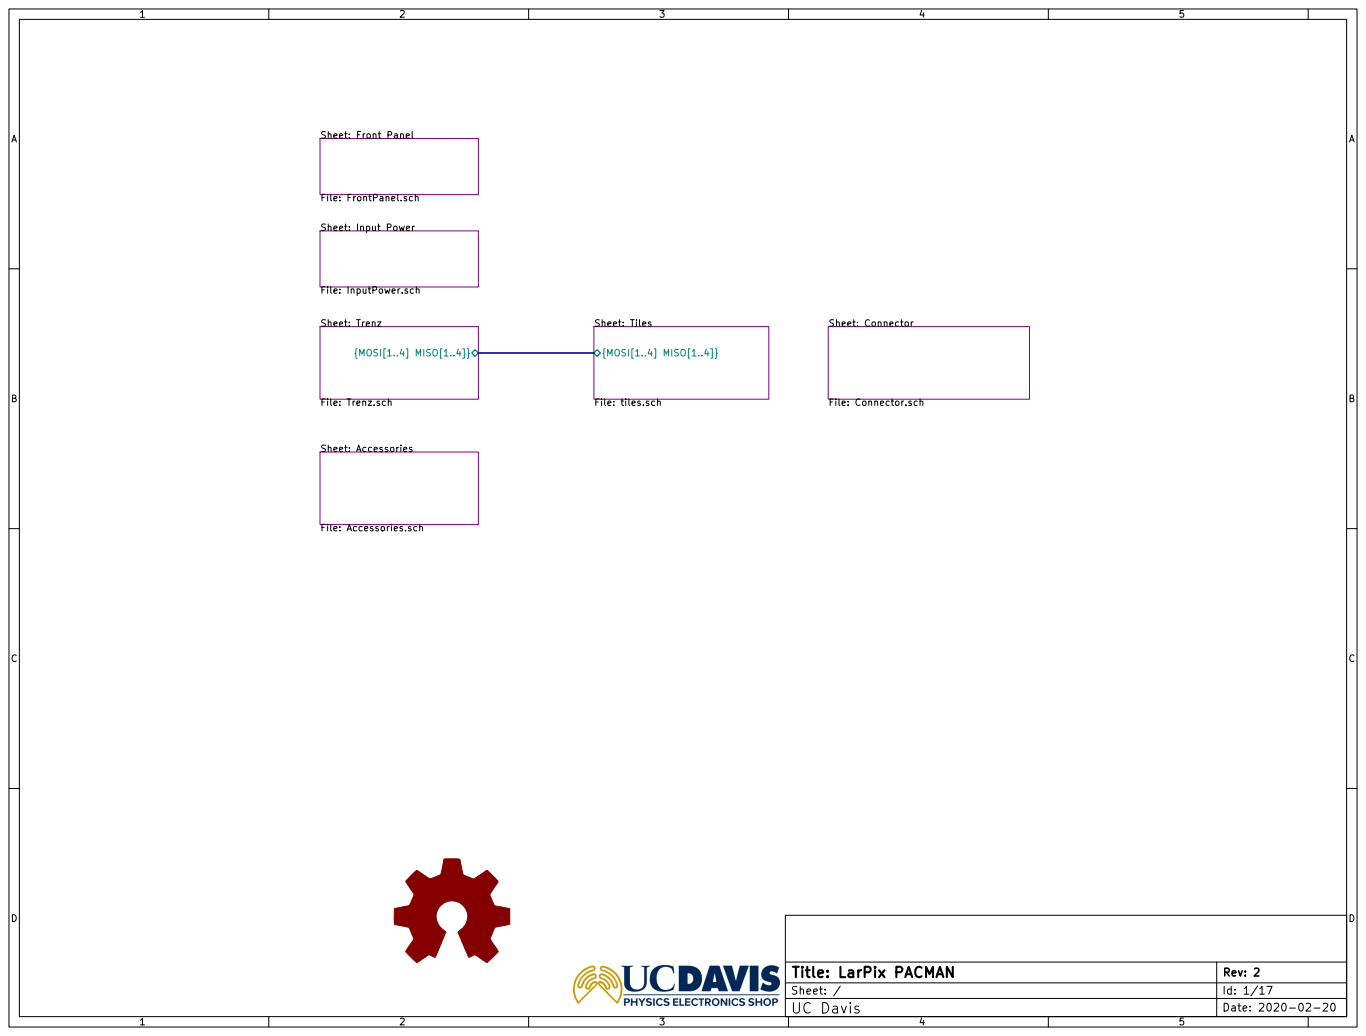
[picture p20: page 1]

Sheet: Connector File: Connector.sch Sheet: Trenz File: Trenz.sch

Id: 1/17 Title: LarPix PACMAN
Sheet: /

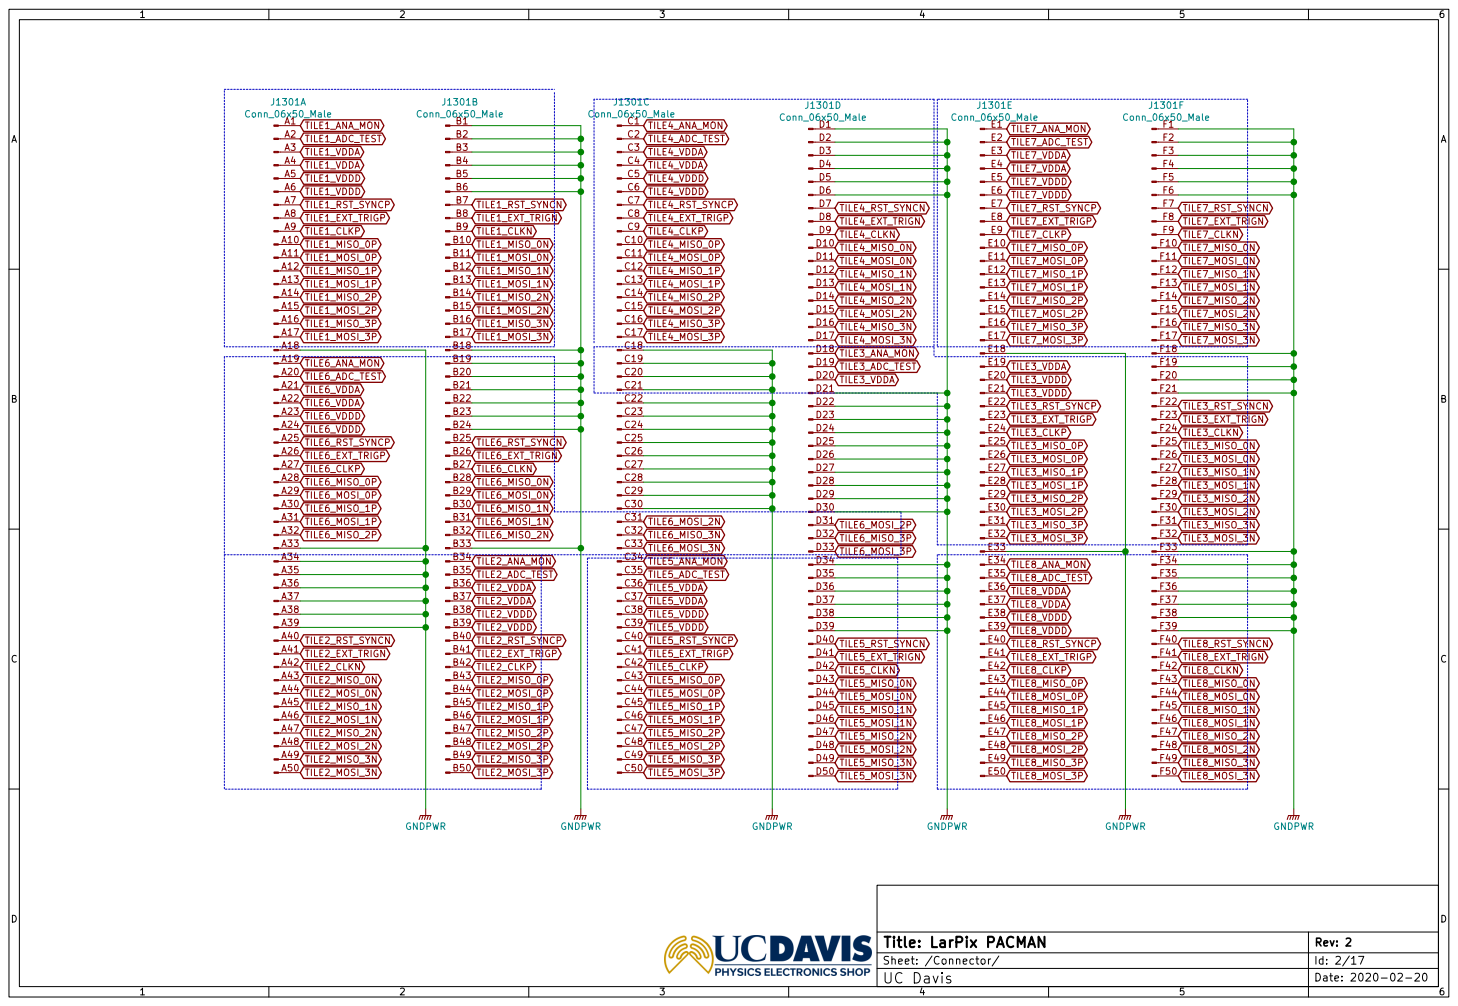
[picture p21: page 2]

Date: 2020-02-20 Rev: 2 Id: 2/17 Title: LarPix PACMAN | D UC Davis

Sheet: /Connector/

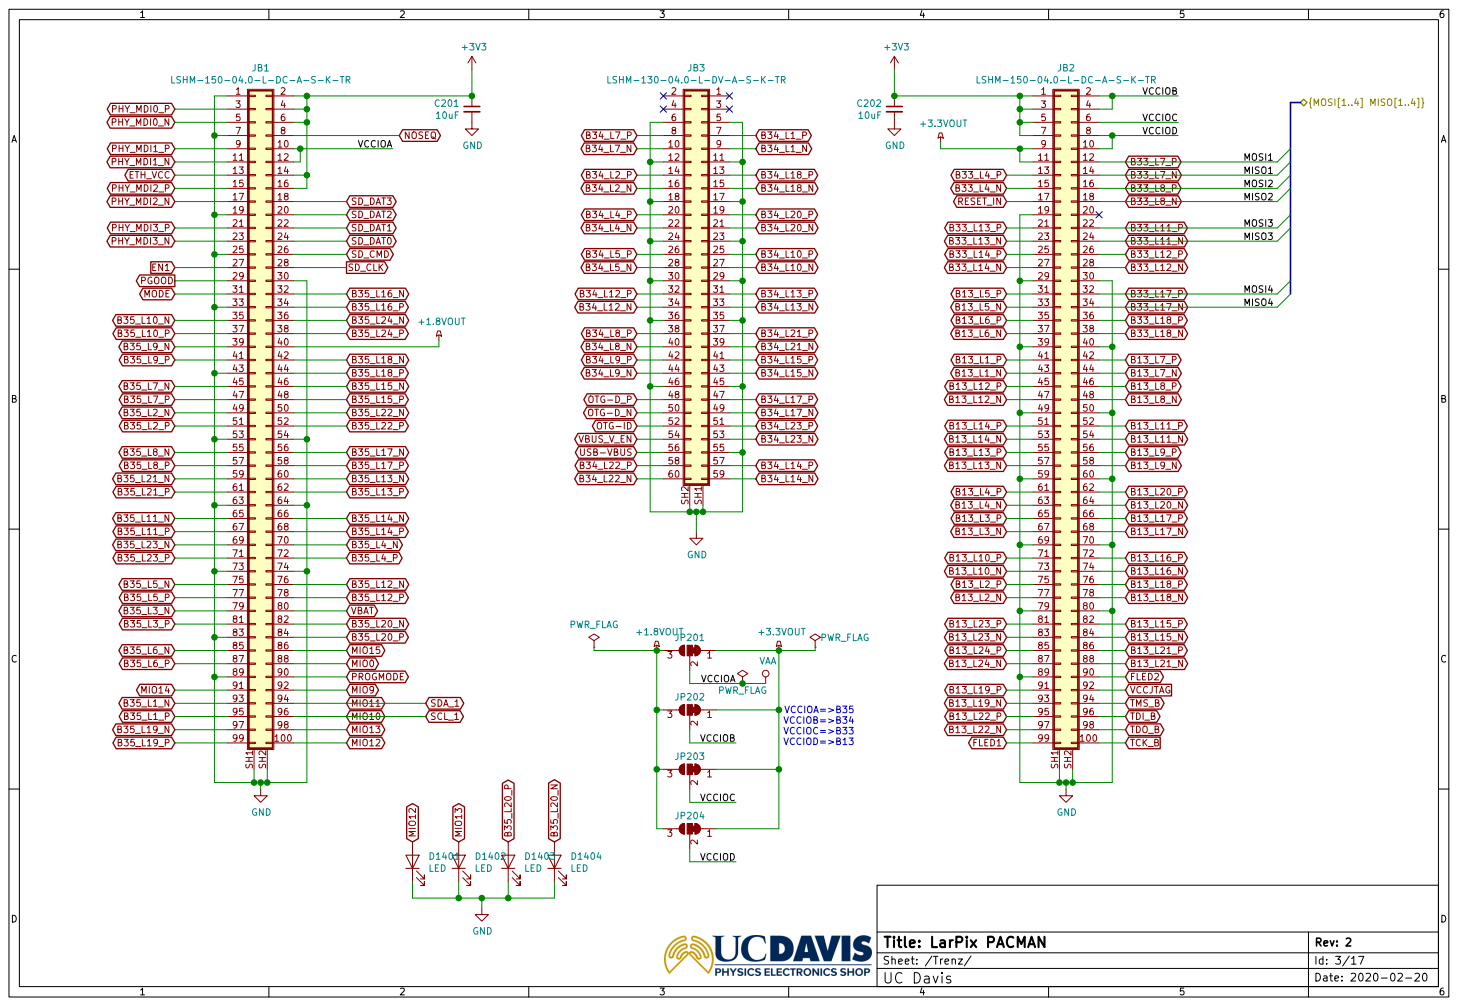
[picture p22: page 3]

LSHM-150-04.0-L-DC-A-S-K-TR GND GND

VBUS_V_EN OTG-ID OTG-D_N OTG-D_P

VCCIOA=>B35 VCCIOB=>B34 VCCIOC=>B33 VCCIOD=>B13

Id: 3/17 Title: LarPix PACMAN

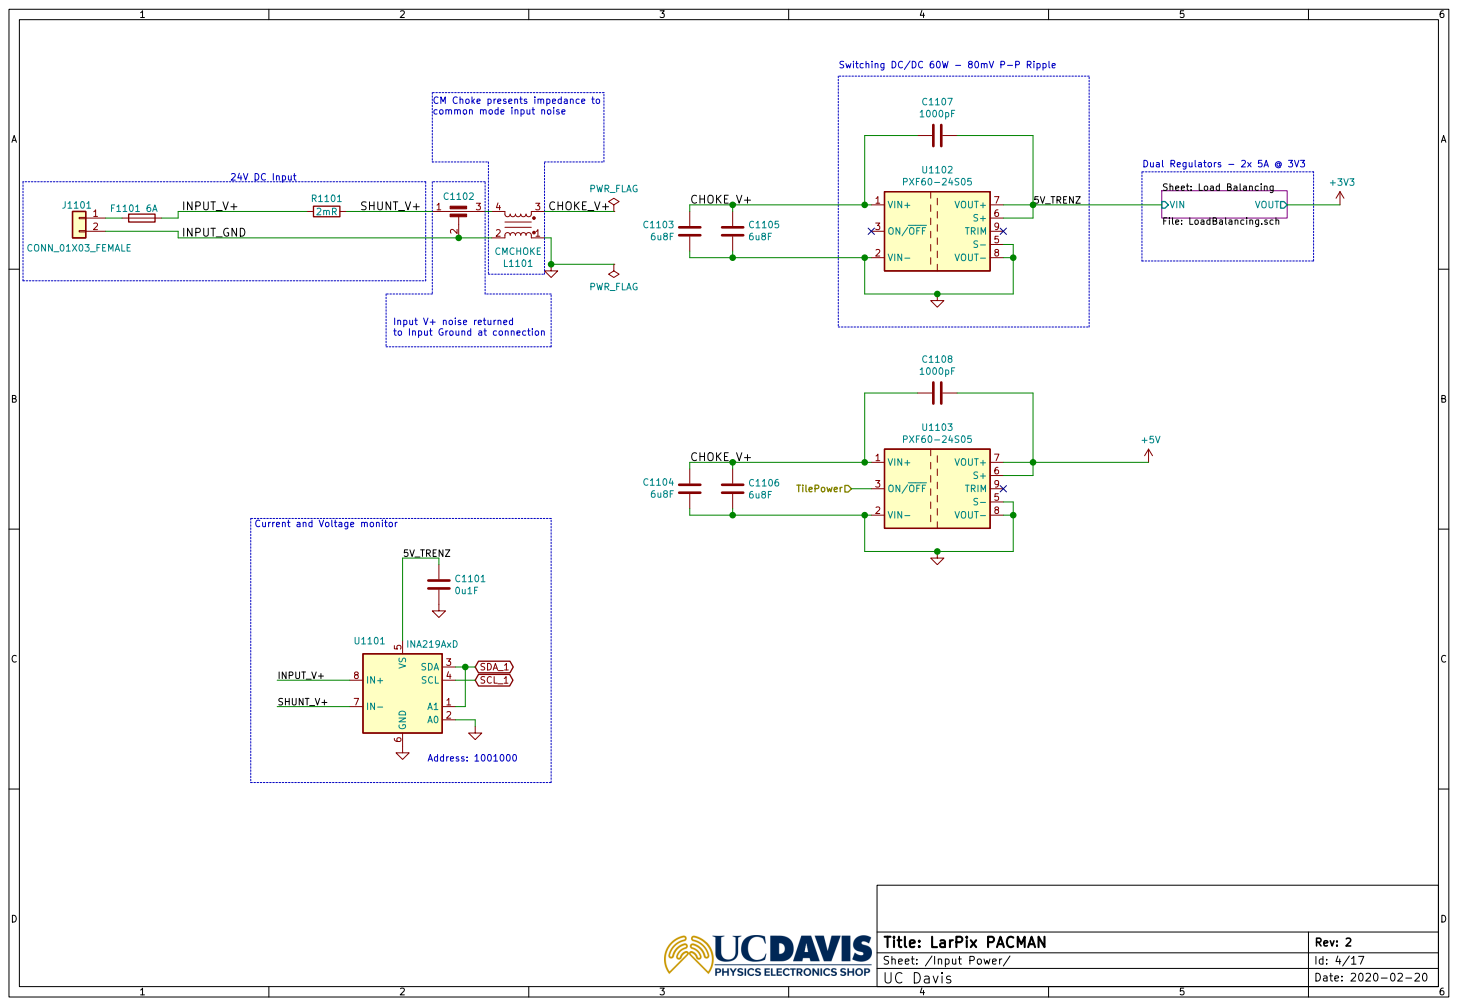
[picture p23: page 4]

Switching DC/DC 60W - 80mV P-P Ripple

CM Choke presents impedance to
common mode input noise

Input V+ noise returned
to Input Ground at connection

Current and Voltage monitor

Date: 2020-02-20 Rev: 2 Id: 4/17 Title: LarPix PACMAN | D UC Davis

Sheet: /Input Power/

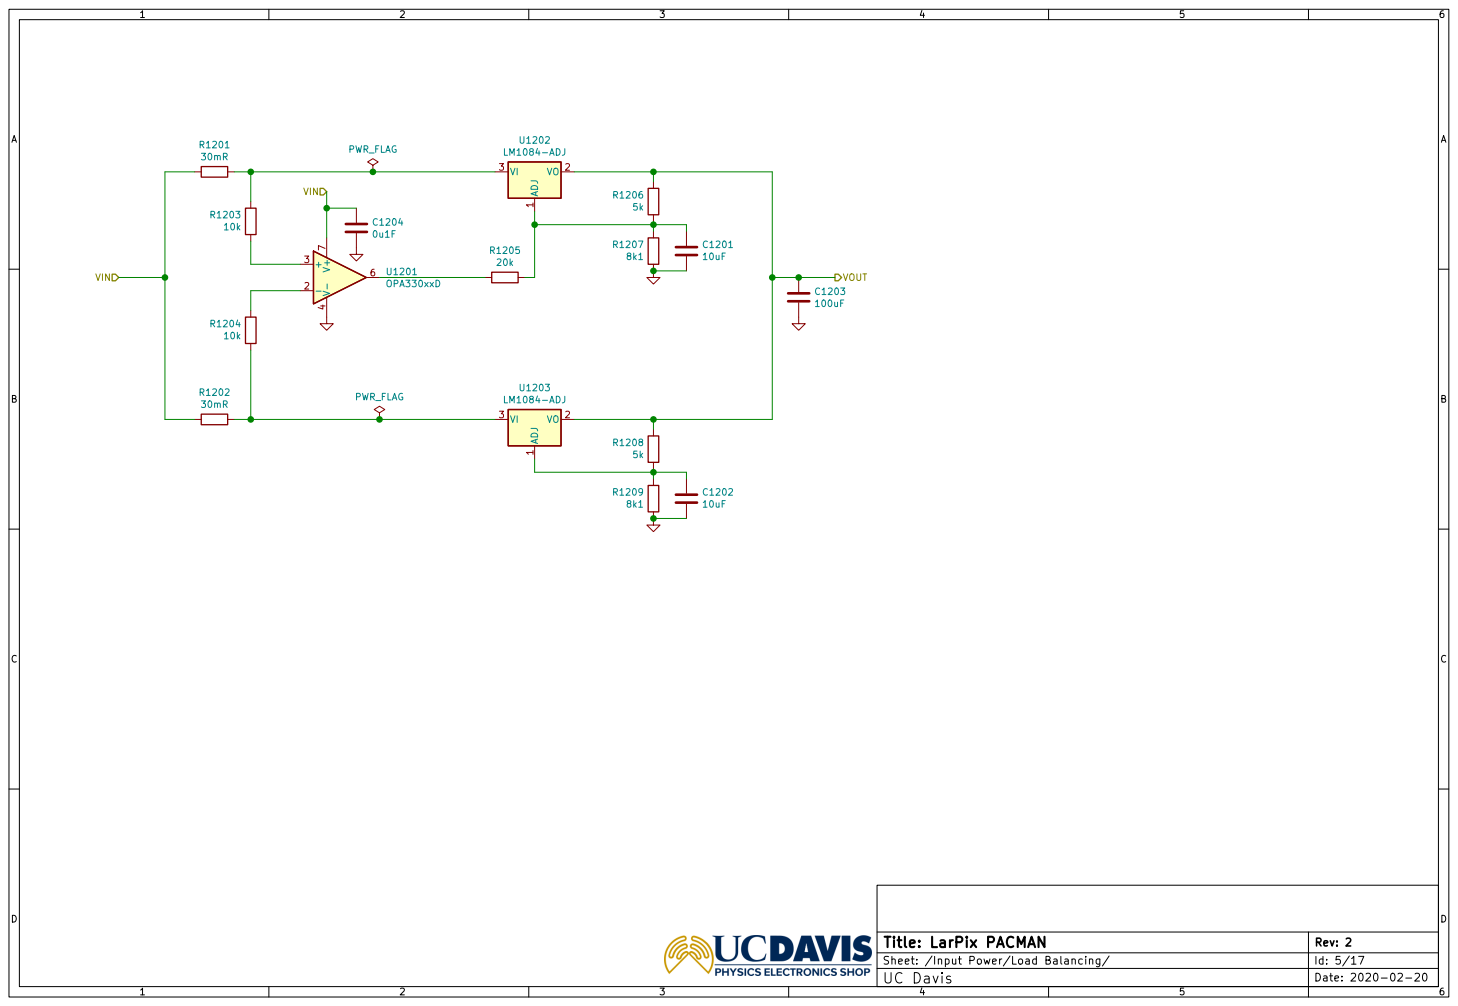
[picture p24: page 5]

Date: 2020-02-20 Rev: 2 Id: 5/17 Title: LarPix PACMAN | D UC Davis

Sheet: /Input Power/Load Balancing/

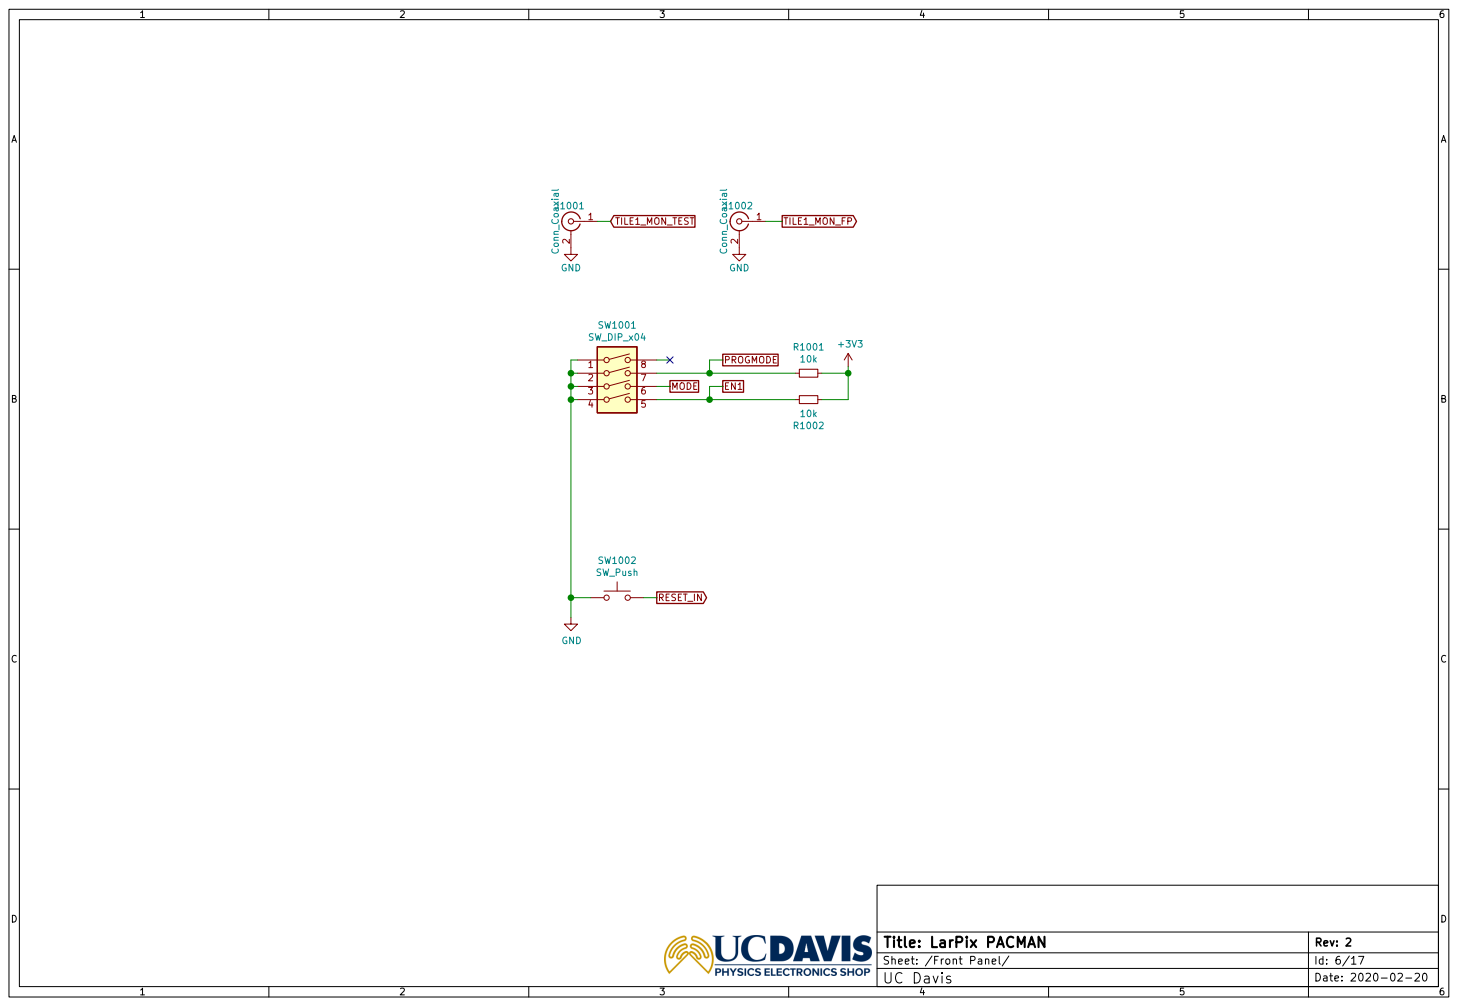
[picture p25: page 6]

Date: 2020-02-20 Rev: 2 Id: 6/17 Title: LarPix PACMAN | D UC Davis

Sheet: /Front Panel/

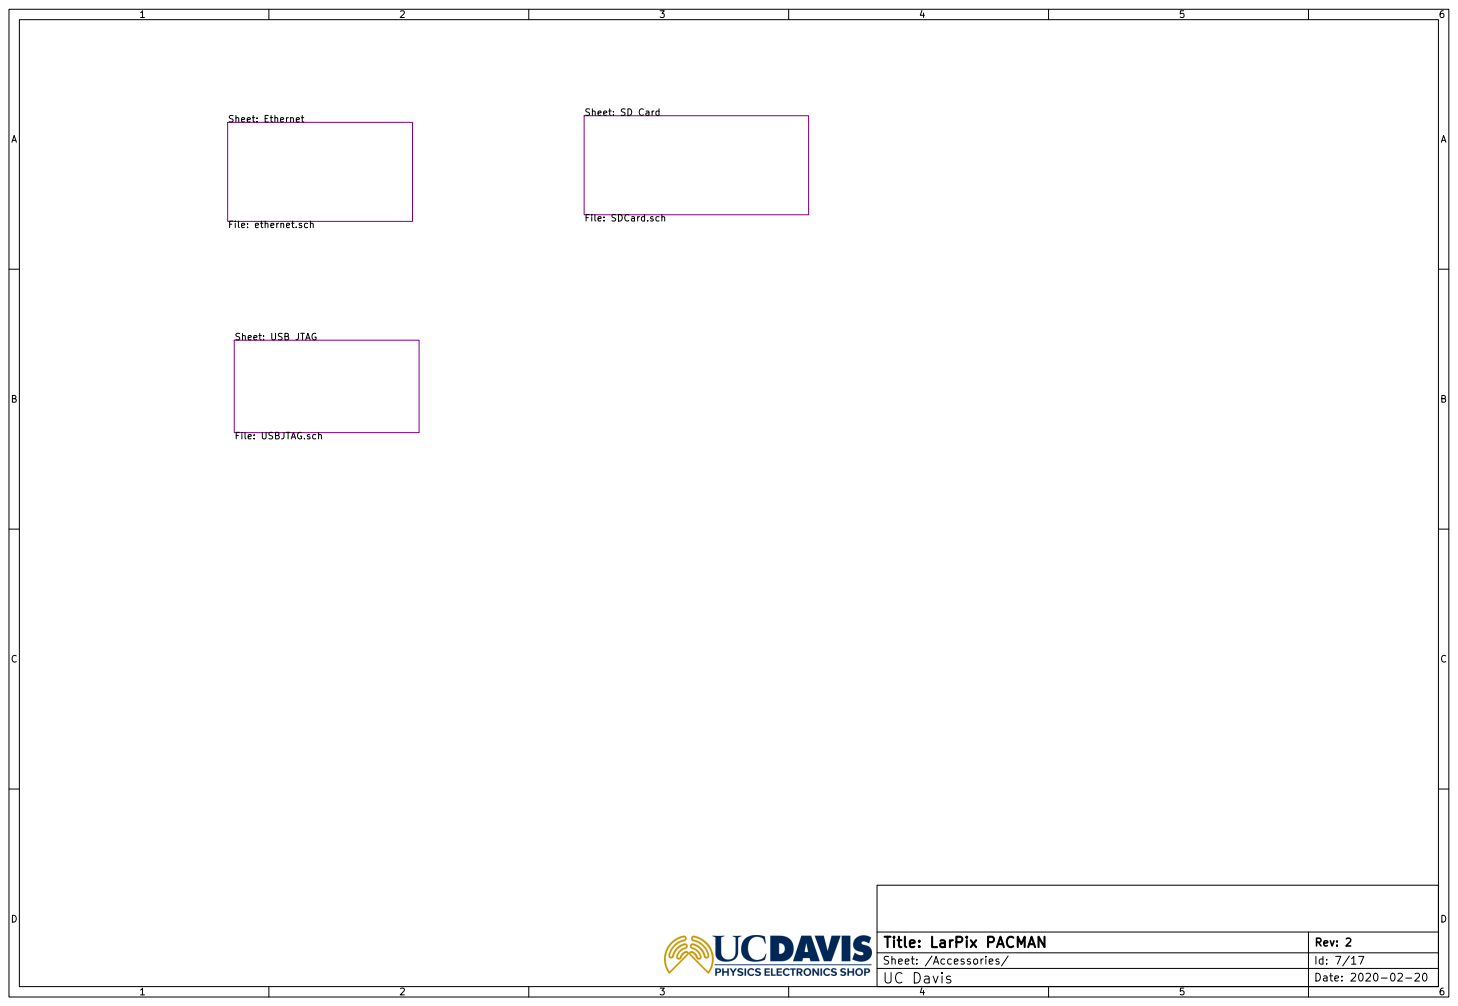
[picture p26: page 7]

Date: 2020-02-20 Rev: 2 Id: 7/17 Title: LarPix PACMAN | D UC Davis

Sheet: /Accessories/

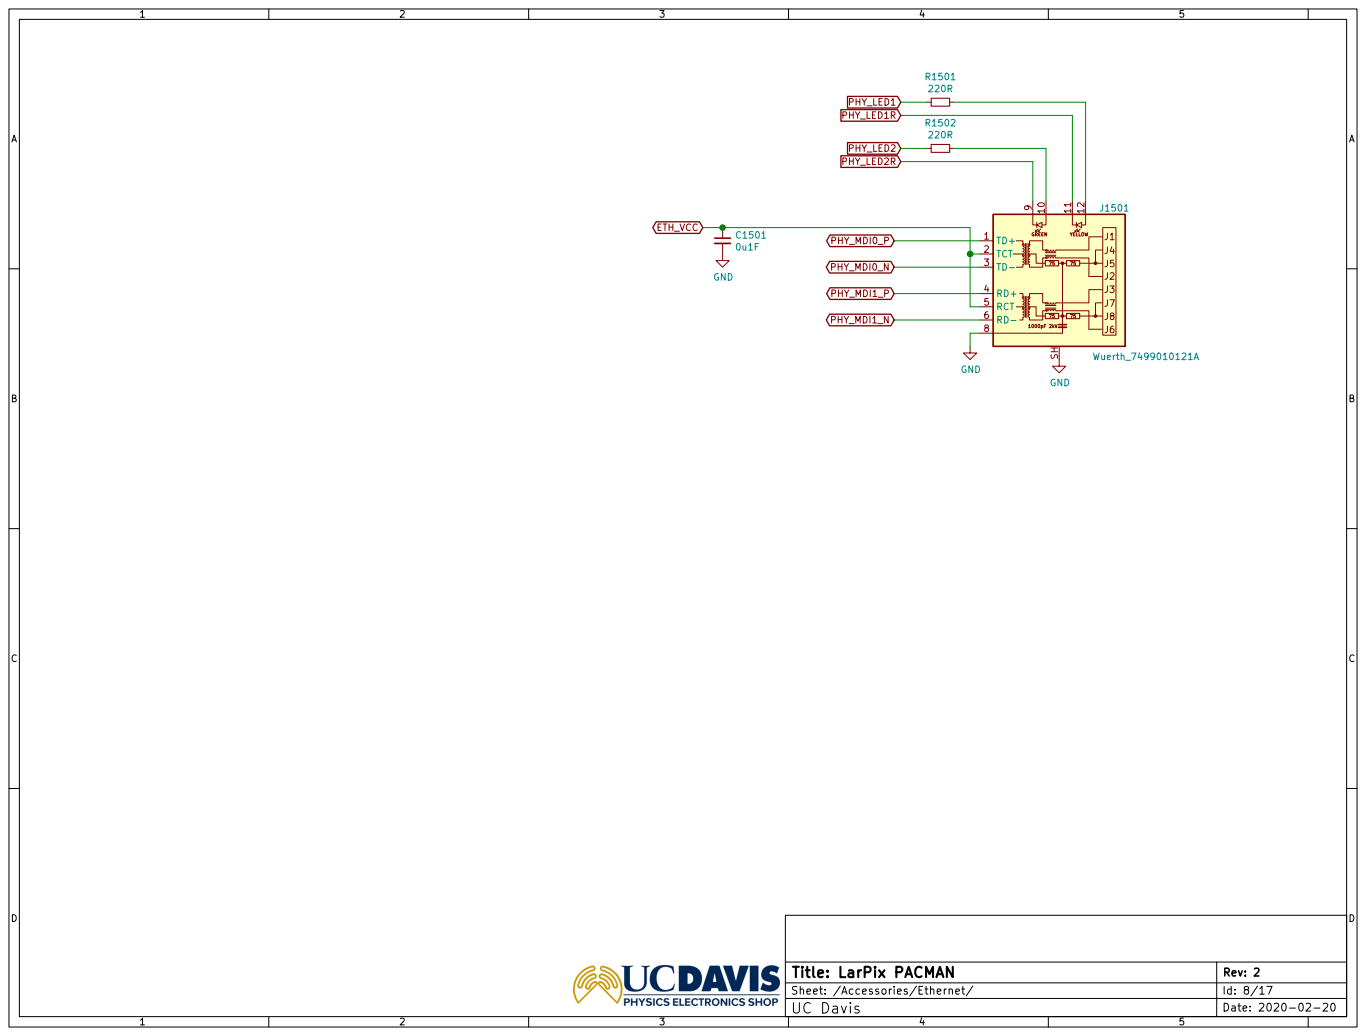
[picture p27: page 8]

Id: 8/17 Title: LarPix PACMAN
Sheet: /Accessories/Ethernet/

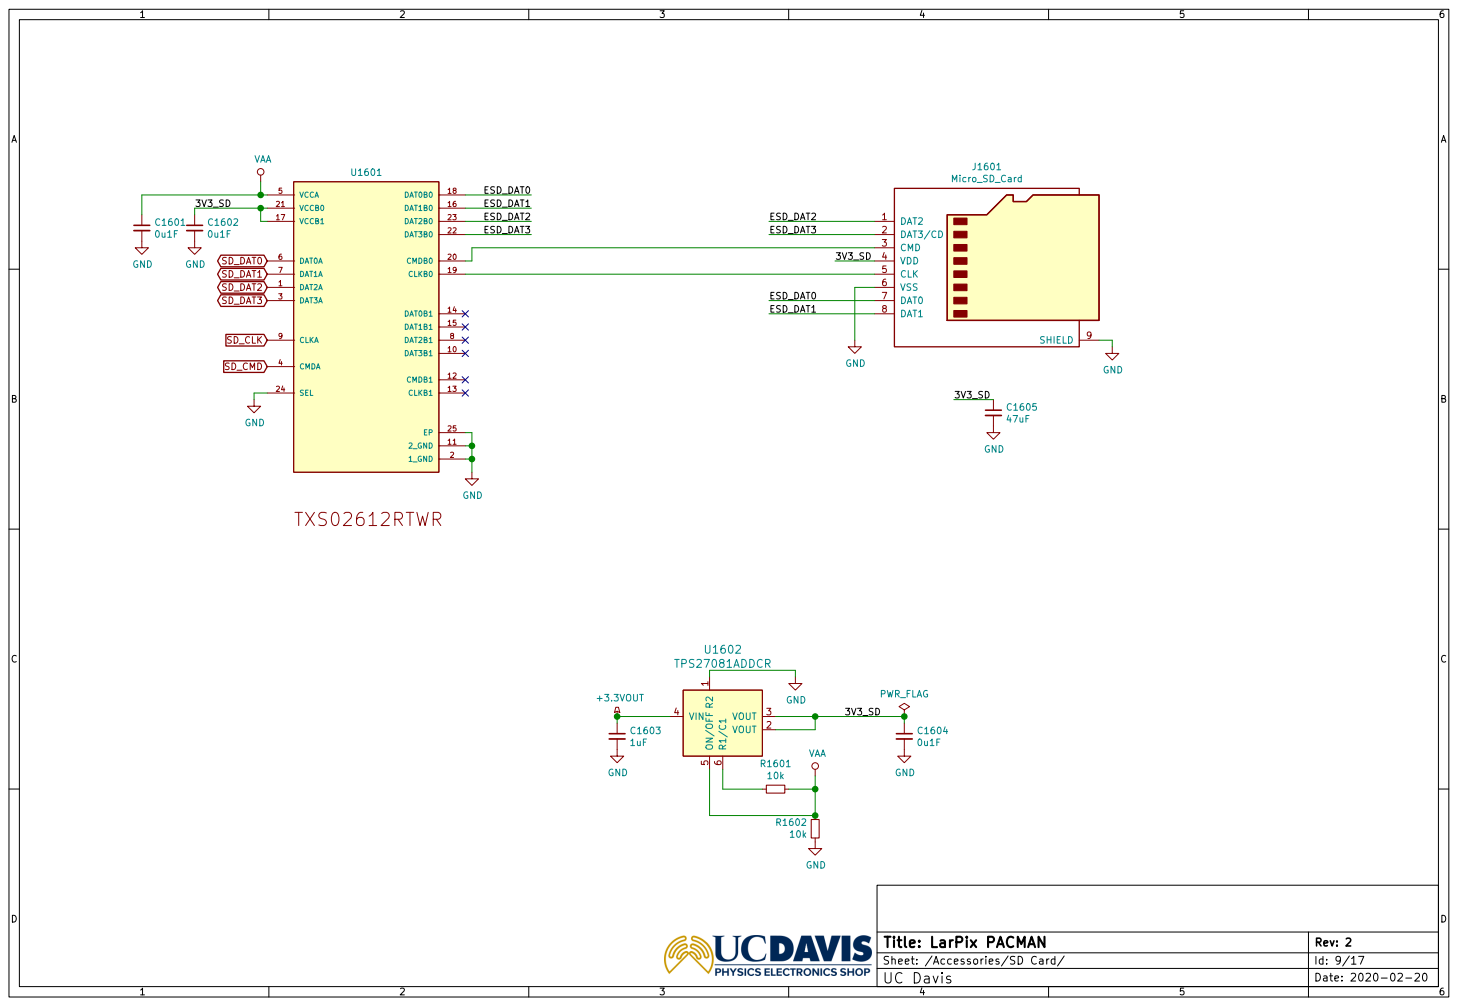
[picture p28: page 9]

1 VOUT 2 VOUT 3 VIN 4 ON/OFF

Id: 9/17 Title: LarPix PACMAN

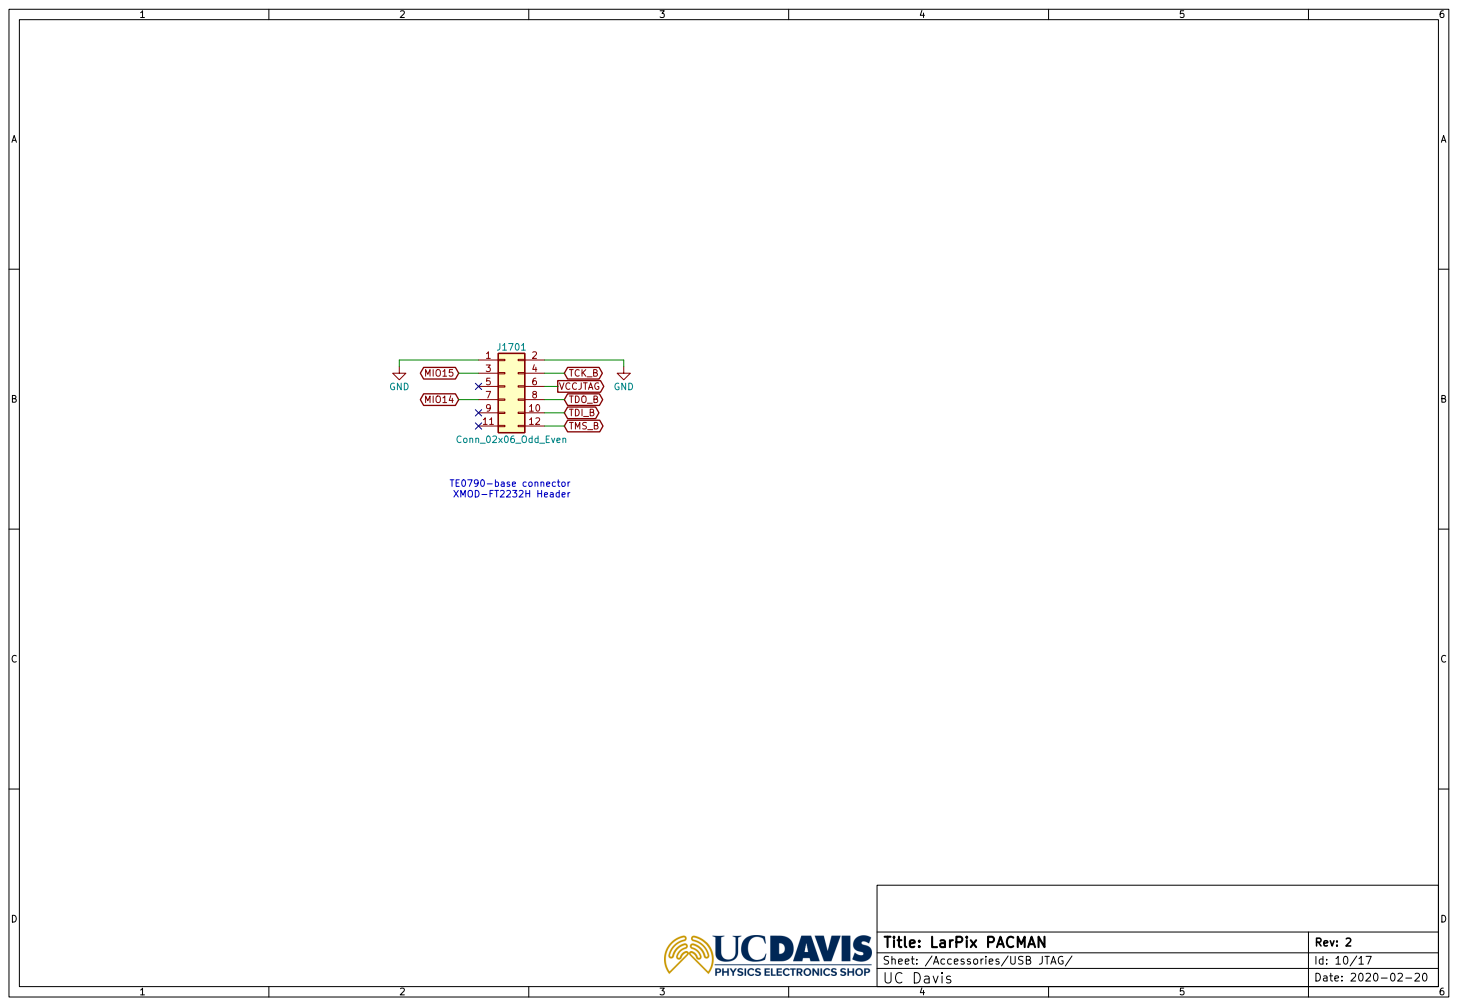
[picture p29: page 10]

TE0790-base connector XMOD-FT2232H Header

Date: 2020-02-20 Rev: 2 Id: 10/17 Title: LarPix PACMAN | D UC Davis

Sheet: /Accessories/USB JTAG/

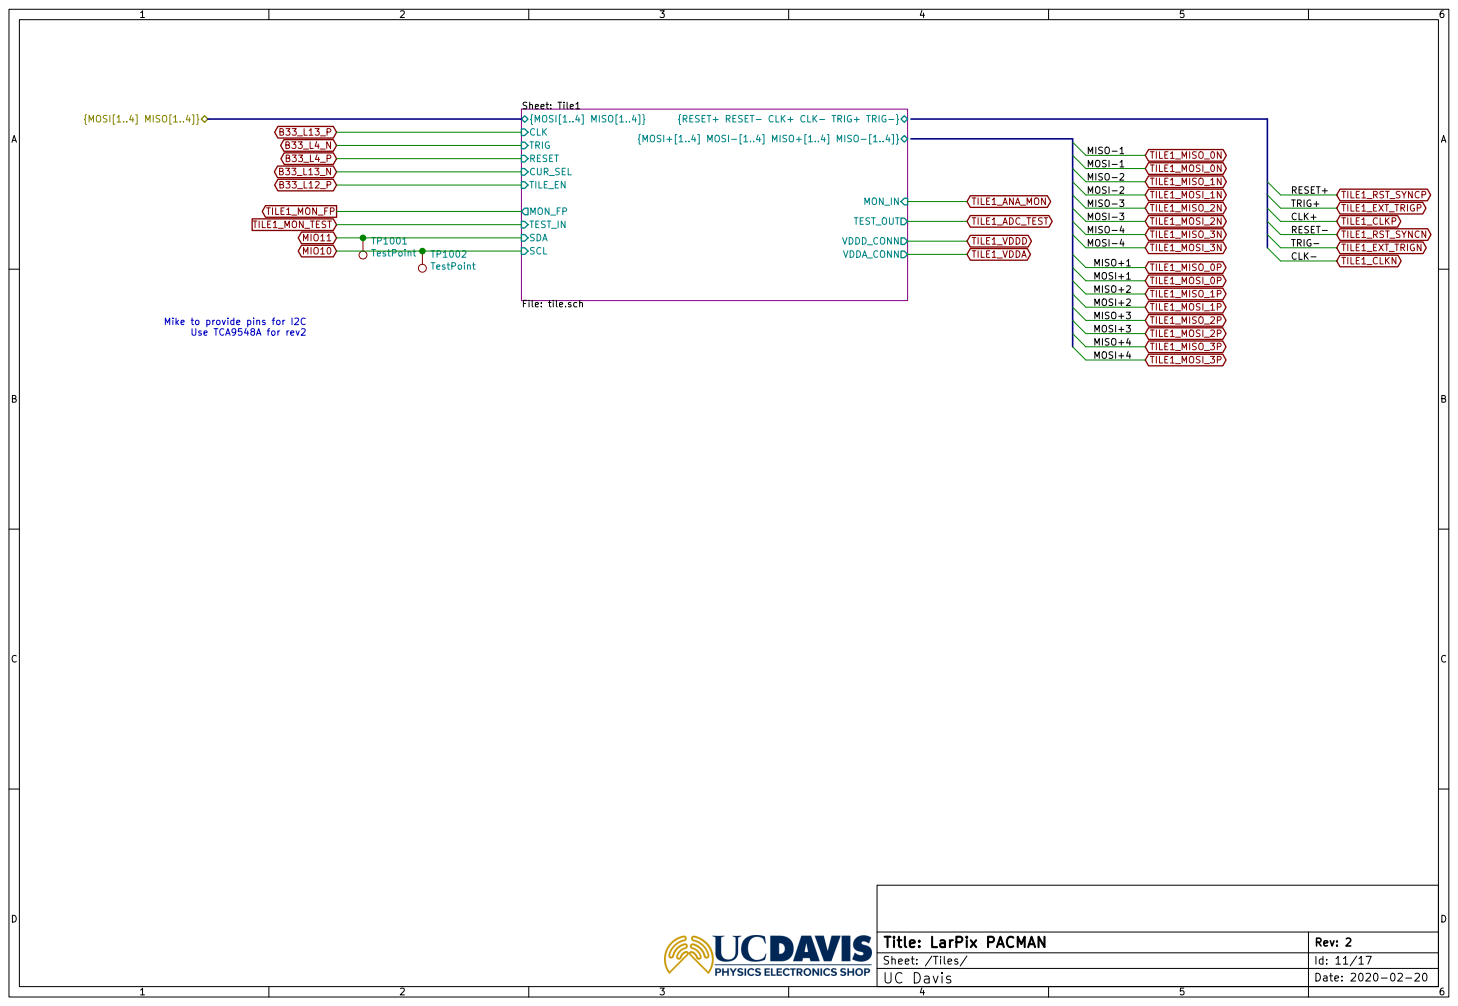
[picture p30: page 11]

Sheet: Tile1 File: tile.sch
{RESET+ RESET- CLK+ CLK- TRIG+ TRIG-} CLK

{MOSI+[1..4] MOSI-[1..4] MISO+[1..4] MISO-[1..4]}

Date: 2020-02-20 Rev: 2 Id: 11/17 Title: LarPix PACMAN | D UC Davis

Sheet: /Tiles/

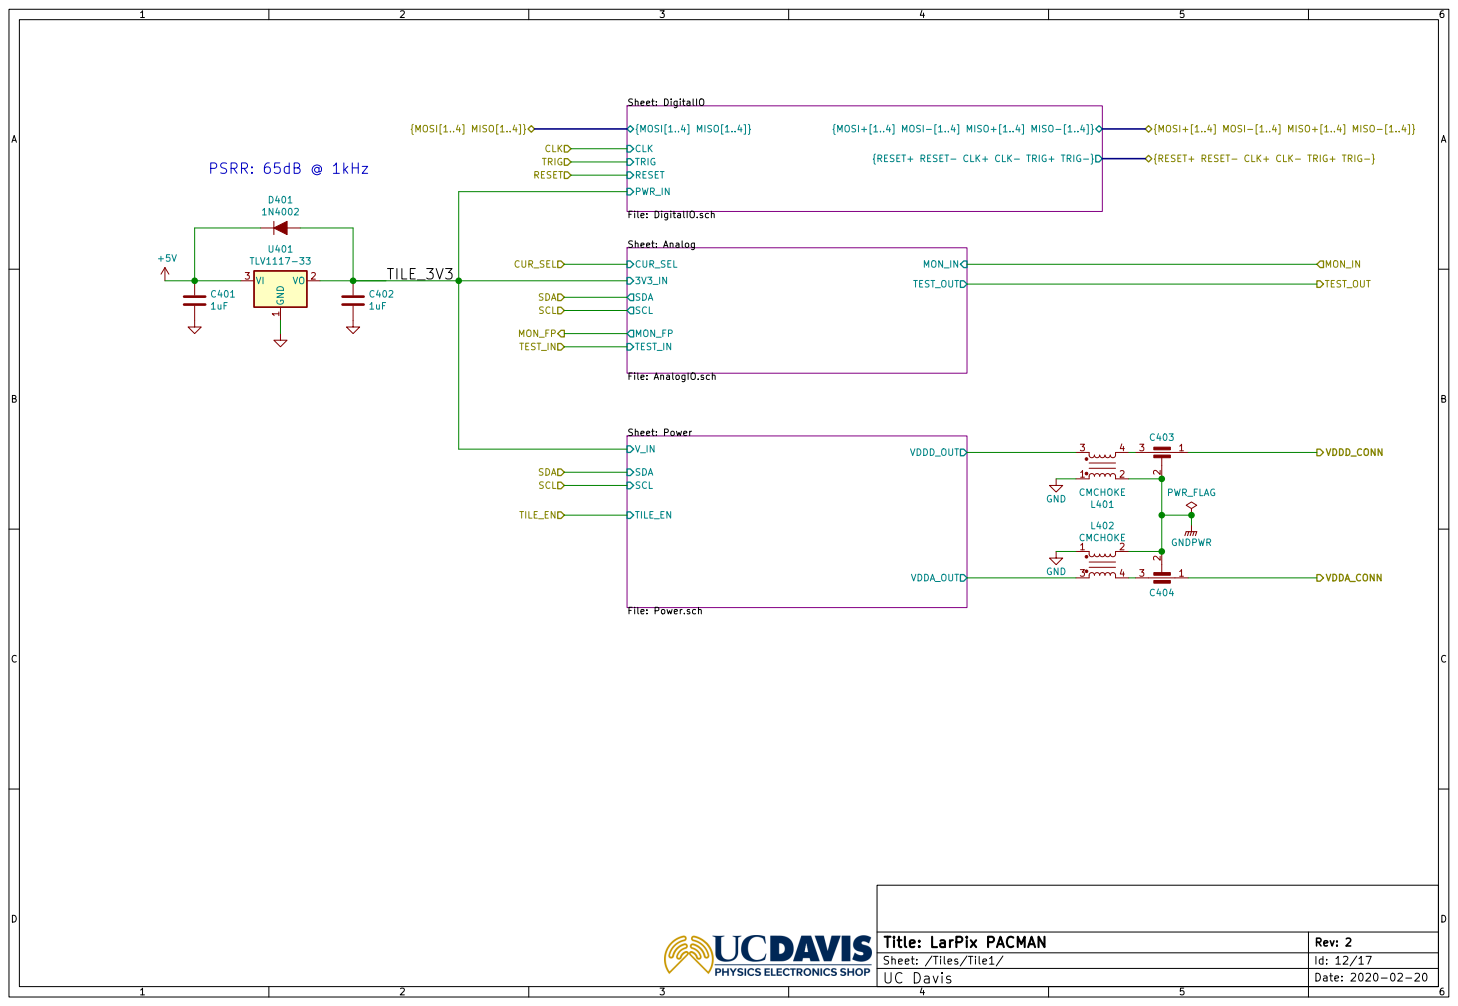
[picture p31: page 12]

{MOSI+[1..4] MOSI-[1..4] MISO+[1..4] MISO-[1..4]} VDDA_CONN TILE_3V3

{MOSI+[1..4] MOSI-[1..4] MISO+[1..4] MISO-[1..4]} PWR_IN

{RESET+ RESET- CLK+ CLK- TRIG+ TRIG-}

Date: 2020-02-20 Rev: 2 Id: 12/17 Title: LarPix PACMAN | D UC Davis

Sheet: /Tiles/Tile1/

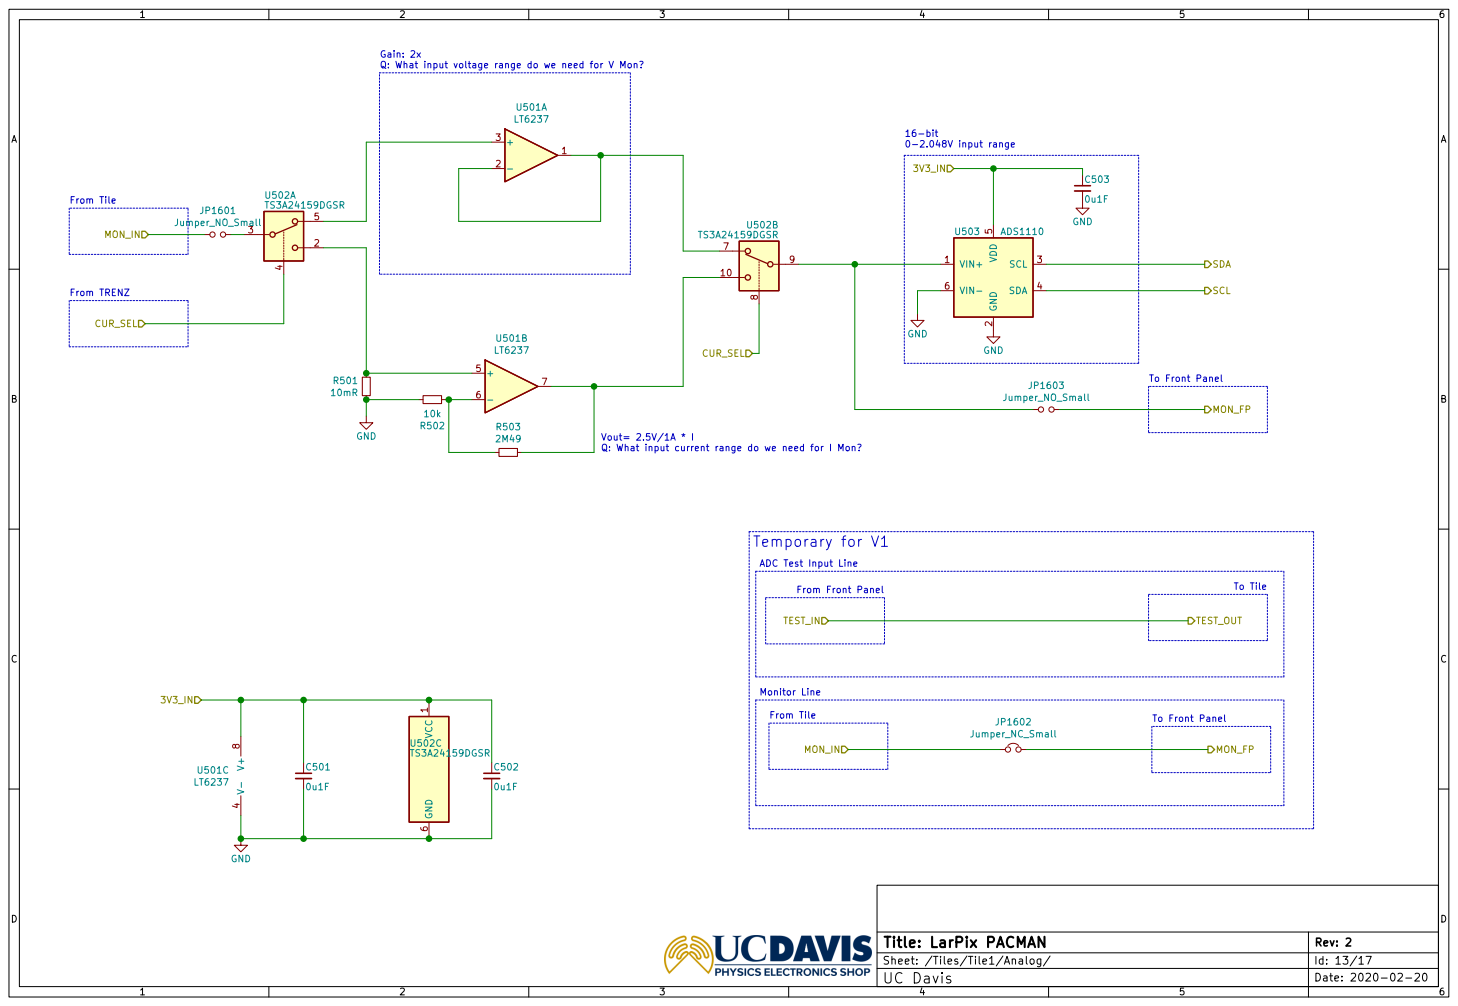
[picture p32: page 13]

Gain: 2x Q: What input voltage range do we need for V Mon?

To Front Panel To Front Panel From TRENZ

ADC Test Input Line Vout= 2.5V/1A * I Q: What input current range do we need for I Mon?From Front Panel Monitor Line

From Tile Temporary for V1

Date: 2020-02-20 Rev: 2 Id: 13/17 Title: LarPix PACMAN | D UC Davis

Sheet: /Tiles/Tile1/Analog/

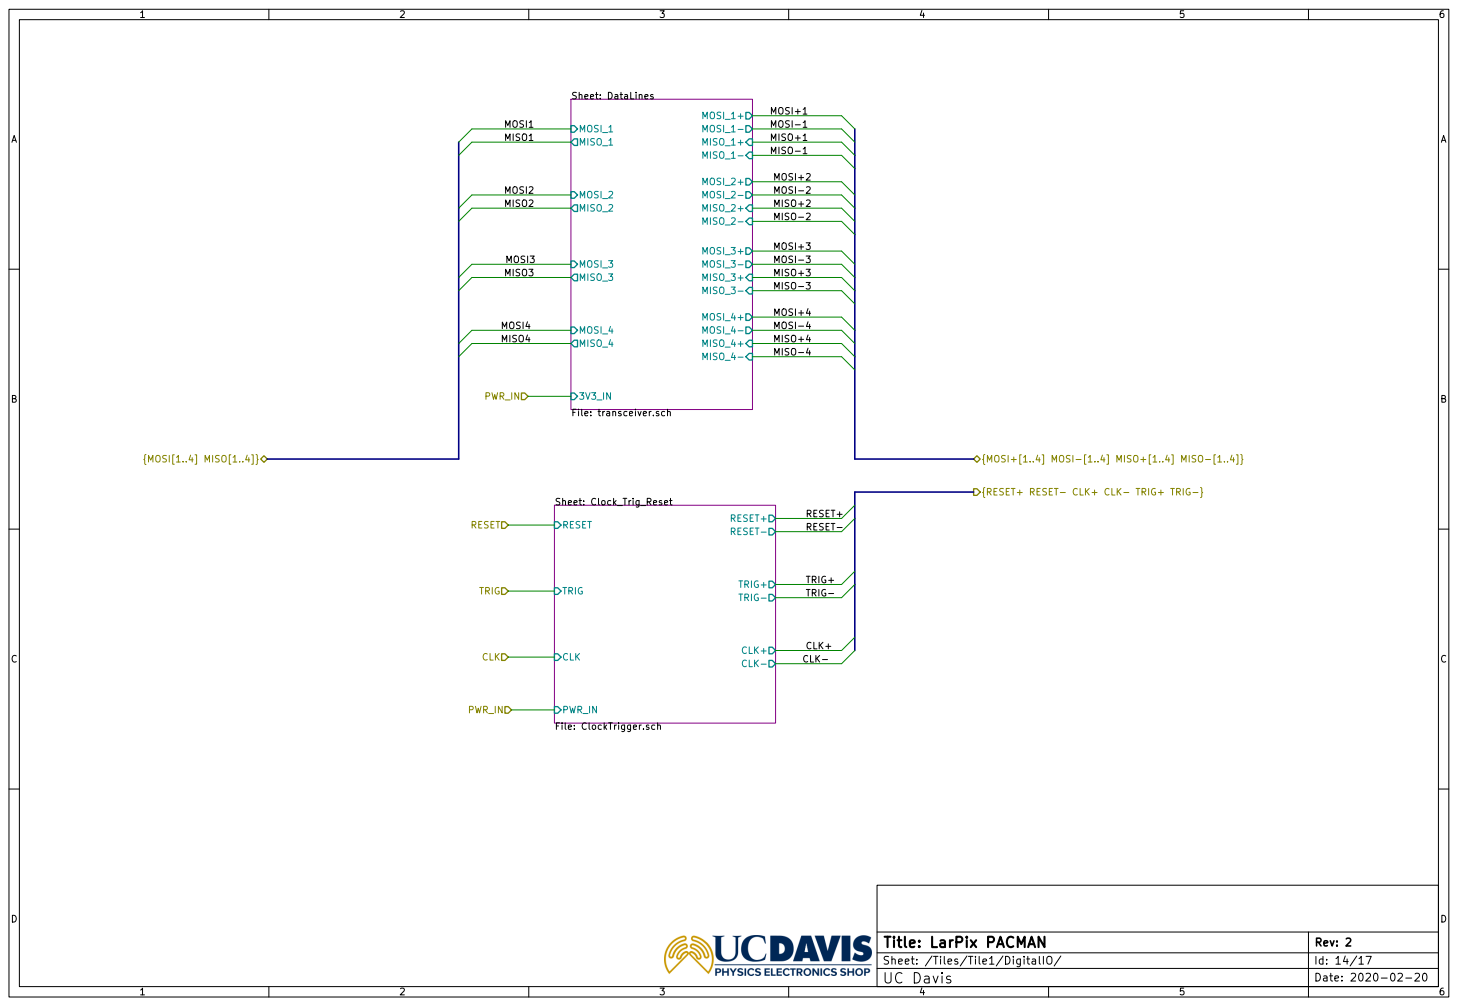
[picture p33: page 14]

{MOSI+[1..4] MOSI-[1..4] MISO+[1..4] MISO-[1..4]} PWR_IN

{RESET+ RESET- CLK+ CLK- TRIG+ TRIG-}

CLK- RESET+ RESET- CLK+ TRIG+ TRIG- PWR_IN

Date: 2020-02-20 Rev: 2 Id: 14/17 Title: LarPix PACMAN | D UC Davis

Sheet: /Tiles/Tile1/DigitalIO/

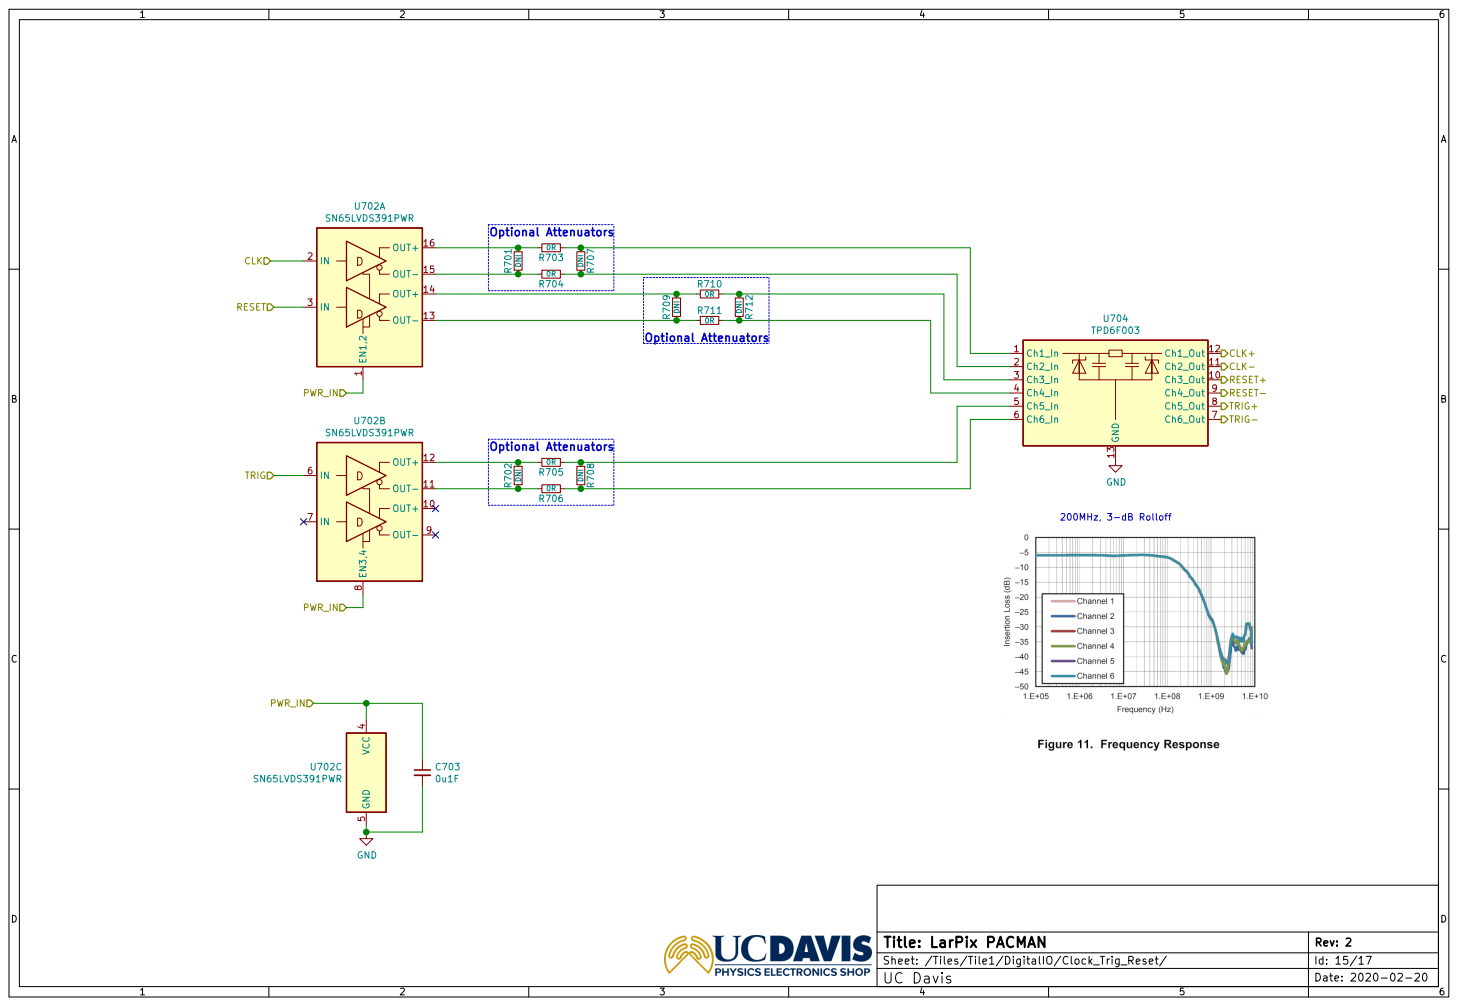
[picture p34: page 15]

1 OUT- 13 OUT+ 14 OUT- 15 OUT+ 16

TRIG- TRIG+ RESET- RESET+ CLK- TRIG

Date: 2020-02-20 Rev: 2 Id: 15/17 Title: LarPix PACMAN | D UC Davis

Sheet: /Tiles/Tile1/DigitalIO/Clock_Trig_Reset/

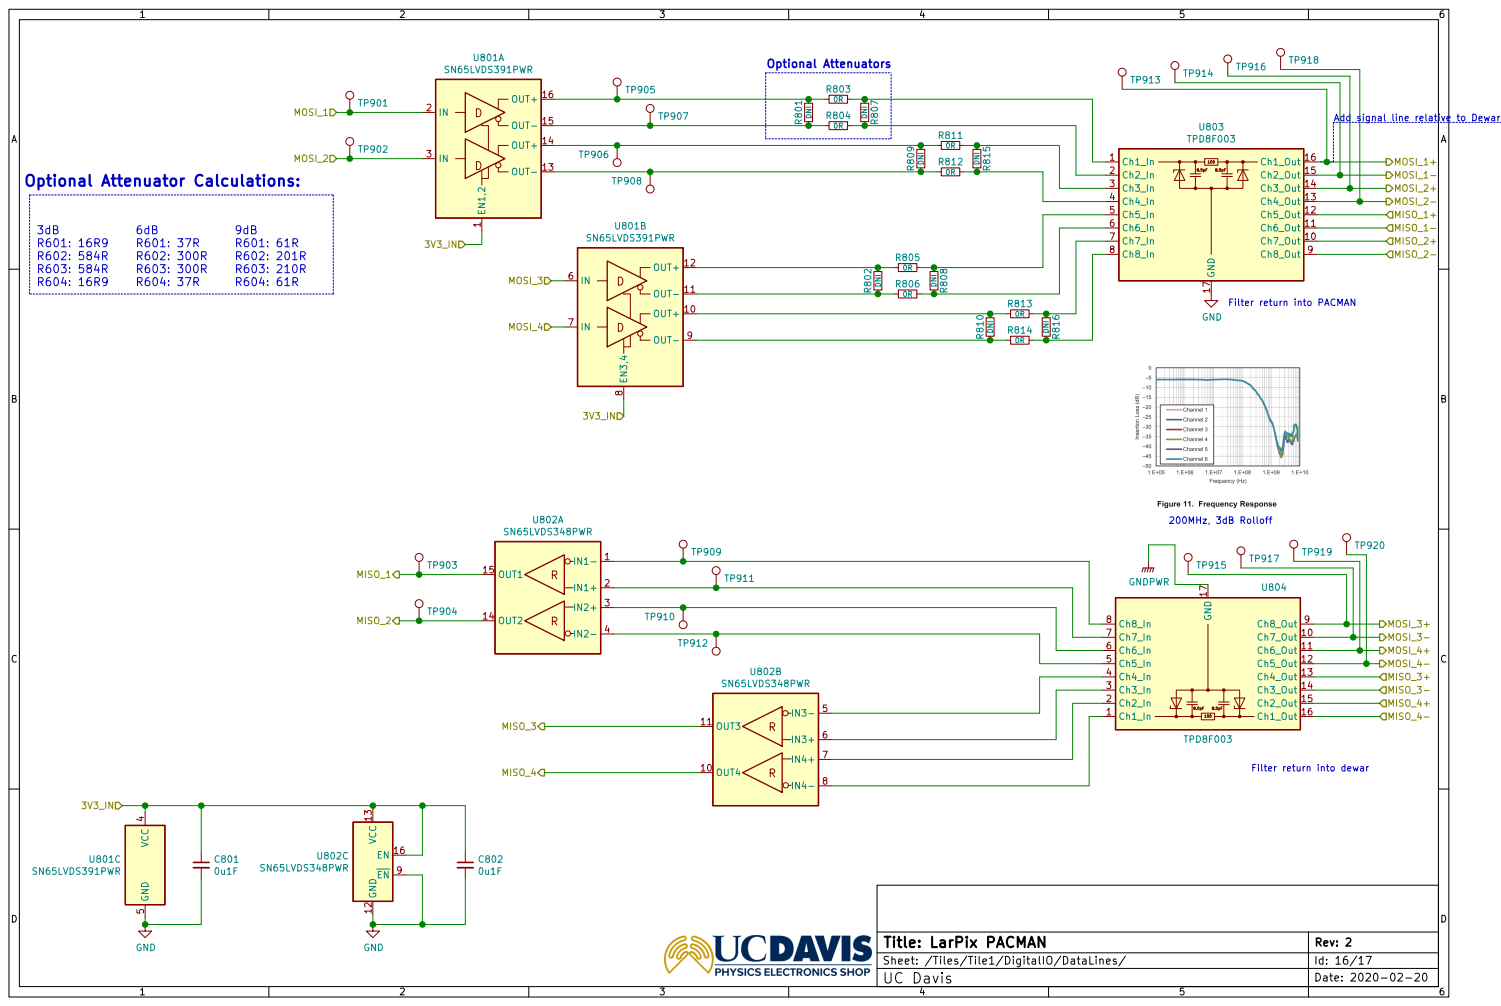
[picture p35: page 16]

Add signal line relative to Dewar ground? Filter return into PACMAN Optional Attenuators

1 OUT- 13 OUT+ 14 OUT- 15 OUT+ 16

Filter return into dewar

Date: 2020-02-20 Rev: 2 Id: 16/17 Title: LarPix PACMAN | D UC Davis

Sheet: /Tiles/Tile1/DigitalIO/DataLines/

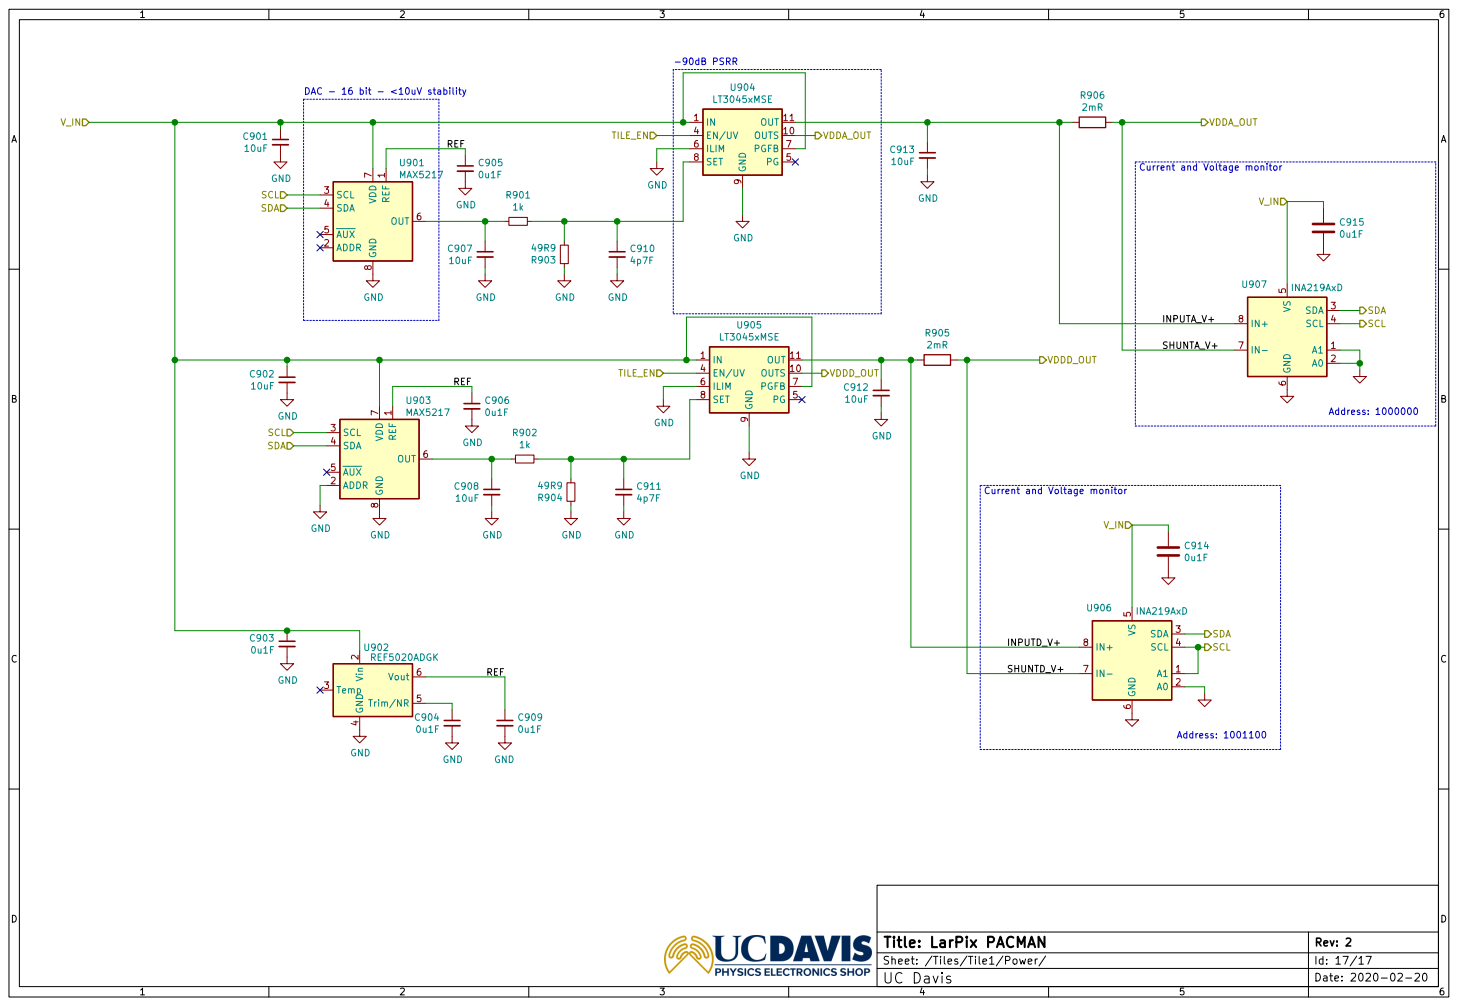
[picture p36: page 17]

4 Trim/NR 5 Vout 6 U902 REF5020ADGK GND
SCL SDA

1 ADDR 2 SCL 3 SDA 4 AUX 5 OUT 6 VDD

7 GND
Sheet: /Tiles/Tile1/Power/ REF

Current and Voltage monitor

Id: 17/17 Title: LarPix PACMAN
