mulhearn/pacman/vivado/src/constraints/hw1v5/pacman.xdc

# pacman v1-rev5 constaints:

set_property IOSTANDARD LVCMOS33 [get_ports POSI_O_0]
set_property IOSTANDARD LVCMOS33 [get_ports PISO_I_0]
set_property PULLUP TRUE [get_ports PISO_I_0]
set_property IOSTANDARD LVCMOS33 [get_ports ANALOG_PWR_EN_O_0]
set_property IOSTANDARD LVCMOS33 [get_ports GLB_CLK_O_0]
set_property IOSTANDARD LVCMOS33 [get_ports TILE_EN_O_0]
set_property IOSTANDARD LVCMOS33 [get_ports TRIG_O_0]
set_property IOSTANDARD LVCMOS33 [get_ports SYNC_O_0]
set_property IOSTANDARD LVCMOS33 [get_ports UART_TX_BUSY]
set_property IOSTANDARD LVCMOS33 [get_ports UART_RX_BUSY]
set_property PACKAGE_PIN J16 [get_ports ANALOG_PWR_EN_O_0]
set_property PACKAGE_PIN C19 [get_ports GLB_CLK_O_0]

set_property PACKAGE_PIN C20 [get_ports PISO_I_0[0]]
set_property PACKAGE_PIN D20 [get_ports PISO_I_0[1]]
set_property PACKAGE_PIN G16 [get_ports PISO_I_0[2]]
set_property PACKAGE_PIN G15 [get_ports PISO_I_0[3]]
set_property PACKAGE_PIN V10 [get_ports PISO_I_0[4]]
set_property PACKAGE_PIN V9 [get_ports PISO_I_0[5]]
set_property PACKAGE_PIN Y9 [get_ports PISO_I_0[6]]
set_property PACKAGE_PIN Y8 [get_ports PISO_I_0[7]]
set_property PACKAGE_PIN V12 [get_ports PISO_I_0[8]]
set_property PACKAGE_PIN W12 [get_ports PISO_I_0[9]]
set_property PACKAGE_PIN W11 [get_ports PISO_I_0[10]]
set_property PACKAGE_PIN W10 [get_ports PISO_I_0[11]]
set_property PACKAGE_PIN B22 [get_ports PISO_I_0[12]]
set_property PACKAGE_PIN B21 [get_ports PISO_I_0[13]]
set_property PACKAGE_PIN A22 [get_ports PISO_I_0[14]]
set_property PACKAGE_PIN A21 [get_ports PISO_I_0[15]]
set_property PACKAGE_PIN AB9 [get_ports PISO_I_0[16]]
set_property PACKAGE_PIN AB10 [get_ports PISO_I_0[17]]
set_property PACKAGE_PIN AA8 [get_ports PISO_I_0[18]]
set_property PACKAGE_PIN AA9 [get_ports PISO_I_0[19]]
set_property PACKAGE_PIN C18 [get_ports PISO_I_0[20]]
set_property PACKAGE_PIN C17 [get_ports PISO_I_0[21]]
set_property PACKAGE_PIN F22 [get_ports PISO_I_0[22]]
set_property PACKAGE_PIN F21 [get_ports PISO_I_0[23]]
set_property PACKAGE_PIN B15 [get_ports PISO_I_0[24]]
set_property PACKAGE_PIN C15 [get_ports PISO_I_0[25]]
set_property PACKAGE_PIN D17 [get_ports PISO_I_0[26]]
set_property PACKAGE_PIN D16 [get_ports PISO_I_0[27]]
set_property PACKAGE_PIN AA4 [get_ports PISO_I_0[28]]
set_property PACKAGE_PIN Y4 [get_ports PISO_I_0[29]]
set_property PACKAGE_PIN AB4 [get_ports PISO_I_0[30]]
set_property PACKAGE_PIN AB5 [get_ports PISO_I_0[31]]
set_property PACKAGE_PIN F17 [get_ports PISO_I_0[32]]
set_property PACKAGE_PIN G17 [get_ports PISO_I_0[33]]
set_property PACKAGE_PIN E16 [get_ports PISO_I_0[34]]
set_property PACKAGE_PIN F16 [get_ports PISO_I_0[35]]
set_property PACKAGE_PIN V7 [get_ports PISO_I_0[36]]
set_property PACKAGE_PIN W7 [get_ports PISO_I_0[37]]
set_property PACKAGE_PIN W6 [get_ports PISO_I_0[38]]
set_property PACKAGE_PIN W5 [get_ports PISO_I_0[39]]

set_property PACKAGE_PIN D21 [get_ports POSI_O_0[0]]
set_property PACKAGE_PIN E21 [get_ports POSI_O_0[1]]
set_property PACKAGE_PIN B20 [get_ports POSI_O_0[2]]
set_property PACKAGE_PIN B19 [get_ports POSI_O_0[3]]
set_property PACKAGE_PIN U12 [get_ports POSI_O_0[4]]
set_property PACKAGE_PIN U11 [get_ports POSI_O_0[5]]
set_property PACKAGE_PIN U10 [get_ports POSI_O_0[6]]
set_property PACKAGE_PIN U9 [get_ports POSI_O_0[7]]
set_property PACKAGE_PIN AA7 [get_ports POSI_O_0[8]]
set_property PACKAGE_PIN AA6 [get_ports POSI_O_0[9]]
set_property PACKAGE_PIN Y6 [get_ports POSI_O_0[10]]
set_property PACKAGE_PIN Y5 [get_ports POSI_O_0[11]]
set_property PACKAGE_PIN C22 [get_ports POSI_O_0[12]]
set_property PACKAGE_PIN D22 [get_ports POSI_O_0[13]]
set_property PACKAGE_PIN G22 [get_ports POSI_O_0[14]]
set_property PACKAGE_PIN H22 [get_ports POSI_O_0[15]]
set_property PACKAGE_PIN AB11 [get_ports POSI_O_0[16]]
set_property PACKAGE_PIN AA11 [get_ports POSI_O_0[17]]
set_property PACKAGE_PIN AB12 [get_ports POSI_O_0[18]]
set_property PACKAGE_PIN AA12 [get_ports POSI_O_0[19]]
set_property PACKAGE_PIN B17 [get_ports POSI_O_0[20]]
set_property PACKAGE_PIN B16 [get_ports POSI_O_0[21]]
set_property PACKAGE_PIN E20 [get_ports POSI_O_0[22]]
set_property PACKAGE_PIN E19 [get_ports POSI_O_0[23]]
set_property PACKAGE_PIN A19 [get_ports POSI_O_0[24]]
set_property PACKAGE_PIN A18 [get_ports POSI_O_0[25]]
set_property PACKAGE_PIN A17 [get_ports POSI_O_0[26]]
set_property PACKAGE_PIN A16 [get_ports POSI_O_0[27]]
set_property PACKAGE_PIN AB6 [get_ports POSI_O_0[28]]
set_property PACKAGE_PIN AB7 [get_ports POSI_O_0[29]]
set_property PACKAGE_PIN U4 [get_ports POSI_O_0[30]]
set_property PACKAGE_PIN T4 [get_ports POSI_O_0[31]]
set_property PACKAGE_PIN E18 [get_ports POSI_O_0[32]]
set_property PACKAGE_PIN F18 [get_ports POSI_O_0[33]]
set_property PACKAGE_PIN D15 [get_ports POSI_O_0[34]]
set_property PACKAGE_PIN E15 [get_ports POSI_O_0[35]]
set_property PACKAGE_PIN Y11 [get_ports POSI_O_0[36]]
set_property PACKAGE_PIN Y10 [get_ports POSI_O_0[37]]
set_property PACKAGE_PIN V8 [get_ports POSI_O_0[38]]
set_property PACKAGE_PIN W8 [get_ports POSI_O_0[39]]

set_property PACKAGE_PIN G21 [get_ports TILE_EN_O_0[0]]
set_property PACKAGE_PIN P18 [get_ports TILE_EN_O_0[1]]
set_property PACKAGE_PIN P17 [get_ports TILE_EN_O_0[2]]
set_property PACKAGE_PIN K15 [get_ports TILE_EN_O_0[3]]
set_property PACKAGE_PIN L21 [get_ports TILE_EN_O_0[4]]
set_property PACKAGE_PIN P21 [get_ports TILE_EN_O_0[5]]
set_property PACKAGE_PIN P20 [get_ports TILE_EN_O_0[6]]
set_property PACKAGE_PIN L22 [get_ports TILE_EN_O_0[7]]
set_property PACKAGE_PIN M19 [get_ports TILE_EN_O_0[8]]
set_property PACKAGE_PIN M20 [get_ports TILE_EN_O_0[9]]

set_property PACKAGE_PIN G20 [get_ports TRIG_O_0[0]]
set_property PACKAGE_PIN R21 [get_ports TRIG_O_0[1]]
set_property PACKAGE_PIN R20 [get_ports TRIG_O_0[2]]
set_property PACKAGE_PIN T17 [get_ports TRIG_O_0[3]]
set_property PACKAGE_PIN R18 [get_ports TRIG_O_0[4]]
set_property PACKAGE_PIN M22 [get_ports TRIG_O_0[5]]
set_property PACKAGE_PIN M21 [get_ports TRIG_O_0[6]]
set_property PACKAGE_PIN T18 [get_ports TRIG_O_0[7]]
set_property PACKAGE_PIN N19 [get_ports TRIG_O_0[8]]
set_property PACKAGE_PIN N20 [get_ports TRIG_O_0[9]]

set_property PACKAGE_PIN D18 [get_ports SYNC_O_0[0]]
set_property PACKAGE_PIN J17 [get_ports SYNC_O_0[1]]
set_property PACKAGE_PIN L17 [get_ports SYNC_O_0[2]]
set_property PACKAGE_PIN M17 [get_ports SYNC_O_0[3]]
set_property PACKAGE_PIN N17 [get_ports SYNC_O_0[4]]
set_property PACKAGE_PIN N18 [get_ports SYNC_O_0[5]]
set_property PACKAGE_PIN J21 [get_ports SYNC_O_0[6]]
set_property PACKAGE_PIN J22 [get_ports SYNC_O_0[7]]
set_property PACKAGE_PIN J20 [get_ports SYNC_O_0[8]]
set_property PACKAGE_PIN K21 [get_ports SYNC_O_0[9]]

set_property PACKAGE_PIN J18 [get_ports LEMO_A_0]
set_property PACKAGE_PIN K18 [get_ports LEMO_B_0]

set_property IOSTANDARD LVCMOS33 [get_ports LED_O_0[0]]
set_property IOSTANDARD LVCMOS33 [get_ports LED_O_0[1]]
set_property PACKAGE_PIN R19 [get_ports LED_O_0[0]]
set_property PACKAGE_PIN T19 [get_ports LED_O_0[1]]

set_property PACKAGE_PIN J15  [get_ports ADC_CLK_O_0]
set_property PACKAGE_PIN AB16 [get_ports ADC_EN_O_0]
set_property PACKAGE_PIN AA16 [get_ports ADC_OF_I_0]
set_property PACKAGE_PIN F19  [get_ports ADC_D_I_0[0]]
set_property PACKAGE_PIN G19  [get_ports ADC_D_I_0[1]]
set_property PACKAGE_PIN H20  [get_ports ADC_D_I_0[2]]
set_property PACKAGE_PIN H19  [get_ports ADC_D_I_0[3]]
set_property PACKAGE_PIN R6   [get_ports ADC_D_I_0[4]]
set_property PACKAGE_PIN T6   [get_ports ADC_D_I_0[5]]
set_property PACKAGE_PIN U6   [get_ports ADC_D_I_0[6]]
set_property PACKAGE_PIN U5   [get_ports ADC_D_I_0[7]]
set_property PACKAGE_PIN Y18  [get_ports ADC_D_I_0[8]]
set_property PACKAGE_PIN AA18 [get_ports ADC_D_I_0[9]]
set_property PACKAGE_PIN AA17 [get_ports ADC_D_I_0[10]]
set_property PACKAGE_PIN AB17 [get_ports ADC_D_I_0[11]]

set_property IOSTANDARD LVCMOS33 [get_ports ADC_CLK_O_0]
set_property IOSTANDARD LVCMOS33 [get_ports ADC_D_I_0[0]]
set_property IOSTANDARD LVCMOS33 [get_ports ADC_D_I_0[1]]
set_property IOSTANDARD LVCMOS33 [get_ports ADC_D_I_0[2]]
set_property IOSTANDARD LVCMOS33 [get_ports ADC_D_I_0[3]]
set_property IOSTANDARD LVCMOS33 [get_ports ADC_D_I_0[4]]
set_property IOSTANDARD LVCMOS33 [get_ports ADC_D_I_0[5]]
set_property IOSTANDARD LVCMOS33 [get_ports ADC_D_I_0[6]]
set_property IOSTANDARD LVCMOS33 [get_ports ADC_D_I_0[7]]

set_property IOSTANDARD LVCMOS25 [get_ports ADC_EN_O_0]
set_property IOSTANDARD LVCMOS25 [get_ports ADC_OF_I_0]
set_property IOSTANDARD LVCMOS25 [get_ports ADC_D_I_0[8]]
set_property IOSTANDARD LVCMOS25 [get_ports ADC_D_I_0[9]]
set_property IOSTANDARD LVCMOS25 [get_ports ADC_D_I_0[10]]
set_property IOSTANDARD LVCMOS25 [get_ports ADC_D_I_0[11]]

set_property IOSTANDARD LVCMOS33 [get_ports LEMO_A_0]
set_property IOSTANDARD LVCMOS33 [get_ports LEMO_B_0]
