mulhearn/pacman/vivado/src/hdl/hw1v3/hardware_version.vhd

library ieee;
use ieee.std_logic_1164.all;
use ieee.numeric_std.all;

package hardware_version is
  constant C_HARDWARE_MAJOR  : integer  := 1;
  constant C_HARDWARE_MINOR  : integer  := 3;
  constant C_HARDWARE_PATCH  : integer  := 0;
end package hardware_version;
