mulhearn/pacman/apps/pacman_fsbl/src/trenz_custom.c

#include "trenz.h"
#include "fsbl.h"
#include "xstatus.h"
#include "xparameters.h"
#include "xemacps.h"
#include "xdevcfg.h"
#include "xil_cache.h"

#define TE0720

/*
 * Settings to copy MAC address into OCM for u-boot usage in environment
 */
#define UBOOT_ENV_MAGIC 0xCAFEBABE
#define UBOOT_ENV_MAGIC_ADDR 0xFFFFFC00
#define UBOOT_ENV_ADDR 0xFFFFFC04



#ifdef UBOOT_ENV_MAGIC

/******************************************************************************
* Convert a 4-bit value to hexadecimal representation (lowercase letters).
*
* @param x 4-bit value to be converted.
* @return Hexadecimal representation.
****************************************************************************/
static char Uint4ToHex(const unsigned char x)
{
	if (x<10) {
		return x + '0';
	} else {
		return x + ('a' - 10);
	}
}

/******************************************************************************
* Convert an octet to the hexadecimal representation (lowercase letters). A null byte is not appended.
*
* @param s Buffer to store hexadecimal representation. At least two bytes must be available.
* @param x Octet to be converted.
****************************************************************************/
static void Uint8ToHex(char* s, const unsigned char x)
{
	s[0] = Uint4ToHex((x >> 4) & 0x0F);
	s[1] = Uint4ToHex((x >> 0) & 0x0F);
}

/******************************************************************************
* Convert MAC address to the environment string for the U-Boot to read the MAC address from.
* Example: "ethaddr=00:0a:35:00:00:05\n"
*
* @param env Buffer to store the environment string. Must have at least 27 bytes available.
* @param mac_addr MAC address, 6 bytes.
****************************************************************************/
static void MacToUbootEnvironment(char* env, const unsigned char* mac_addr)
{
	// end of "ethaddr=".
	const int idx0 = 8;
	const int N_MAC = 6;
	int i;

	strcpy(env, "ethaddr=");
	for (i=0; i<N_MAC; ++i) {
		const int idx = idx0 + 3*i;
		Uint8ToHex(&env[idx], mac_addr[i]);
		env[idx+2] = ':';
	}
	env[idx0 + 3 * N_MAC - 1] = '\n';
	env[idx0 + 3 * N_MAC - 0] = 0;
}

#endif


u32 TE_FsblHookBeforeHandoff_Custom(void)
{
  u32 Status;

  Status = XST_SUCCESS;

  xil_printf("\r\n--------------------------------------------------------------------------------\r\n");
  xil_printf("Custom FsblHookBeforeHandoff for TE0720\r\n");

  Status = te_read_IDCODE(); if(Status != XST_SUCCESS){ return XST_FAILURE; }

  u16 rval16;
  u8 speed_grade;
  u8 pcb_rev;
  unsigned char temp_grade;
  unsigned char model1;
  unsigned char model2;
  unsigned char model3;

  u8 wdt;
  u8 cpld_rev;
  u8 cpld_bm;
  u8 boot;
  u8 pudc;
  u8 boot_gen;


  char* wdt_status;
  char* pudc_mode;
  char* boot_mode;
  char* bootmode_gen;
  char* cpld_bootmode;
  XEmacPs Emac;
  XEmacPs_Config *Mac_Config;

  unsigned char mac_addr[6];
  int i = 0;



#ifdef TE0720


  Mac_Config = XEmacPs_LookupConfig(XPAR_PS7_ETHERNET_0_DEVICE_ID); if(Mac_Config == NULL) { return XST_FAILURE; }

  Status = XEmacPs_CfgInitialize(&Emac, Mac_Config, Mac_Config->BaseAddress); if(Status != XST_SUCCESS){ return XST_FAILURE; }
  /*
   * Read out MAC Address bytes
   */
  Status = XEmacPs_PhyRead(&Emac, 0x1A,  9, &rval16); if(Status != XST_SUCCESS){ return XST_FAILURE; }
  mac_addr[0] = (unsigned char)(rval16 >> 8);
  mac_addr[1] = (unsigned char)(rval16 & 0xFF);
  Status = XEmacPs_PhyRead(&Emac, 0x1A,  10, &rval16); if(Status != XST_SUCCESS){	return XST_FAILURE; }
  mac_addr[2] = (unsigned char)(rval16 >> 8);
  mac_addr[3] = (unsigned char)(rval16 & 0xFF);
  Status = XEmacPs_PhyRead(&Emac, 0x1A,  11, &rval16); if(Status != XST_SUCCESS){	return XST_FAILURE; }
  mac_addr[4] = (unsigned char)(rval16 >> 8);
  mac_addr[5] = (unsigned char)(rval16 & 0xFF);

  /*
   * Decode SoM model and version information!
   */
  // Read register 3
  Status = XEmacPs_PhyRead(&Emac, 0x1A,  3, &rval16); if(Status != XST_SUCCESS){	return XST_FAILURE; }
  pcb_rev = (rval16 >>10) & 0x7;

  // Read register 4
  Status = XEmacPs_PhyRead(&Emac, 0x1A,  4, &rval16); if(Status != XST_SUCCESS){	return XST_FAILURE; }

  cpld_rev = (rval16 & 0x00FF);
  if (cpld_rev <= 6)
    {
      speed_grade = (rval16 >> 14) & 3;
      /* 0=C, 1=E, 2=I, 3=A */
      if ((rval16 & 0x3000)==0x0000) { temp_grade = 0x43; }
      else if ((rval16 & 0x3000)==0x1000) { temp_grade = 0x45; }
      else if ((rval16 & 0x3000)==0x2000) { temp_grade = 0x49; }
      else if ((rval16 & 0x3000)==0x3000) { temp_grade = 0x41; }
      else { temp_grade = 0x20; }

      if ((rval16 & 0x0F00)==0x000) { model1 = 0x20;model2 = 0x20;model3 = 0x46; }
      else if ((rval16 & 0x0F00)==0x100) { model1 = 0x20;model2 = 0x20;model3 = 0x52; }
      else if ((rval16 & 0x0F00)==0x200) { model1 = 0x20;model2 = 0x4C;model3 = 0x46; }
      else if ((rval16 & 0x0F00)==0x300) { model1 = 0x31;model2 = 0x34;model3 = 0x53; }
      else { model1 = 0x31;model2 = 0x31;model3 = 0x31; }


      xil_printf("\n\rSoM: TE0720-0%d-%d%c%c%c%c SC REV:%02x", pcb_rev, speed_grade, temp_grade, model1, model2, model3, rval16 & 0xFF);
      xil_printf("\n\rMAC: ");

      for(i = 0; i < 6; i++) {
        xil_printf("%02x ", mac_addr[i]);
      }
      xil_printf("\n\r");
    }
  else
    {
      Status = XEmacPs_PhyRead(&Emac, 0x1A,  4, &rval16); if(Status != XST_SUCCESS){	return XST_FAILURE; }
      wdt = (rval16 >> 14) & 0x3;
      if (wdt == 0b00)
        {
	  wdt_status = "Deactive";
        }else if (wdt == 0b01)
        {
	  wdt_status = "Hardware_WDT";
        }else if (wdt == 0b10)
        {
	  wdt_status = "Software_WDT";
        }else if (wdt == 0b11)
        {
	  wdt_status = "No WDT chip on the board. SOftware_WDT with PL clock";
        }



      boot_gen = (rval16 >> 12) & 0x3;
      if (boot_gen == 0b00)
        {
	  bootmode_gen = "QSPI/SD";
        }else if (boot_gen == 0b01)
        {
	  bootmode_gen = "QSPI/JTAG";
        }else if (boot_gen == 0b10)
        {
	  bootmode_gen = "JTAG/SD";
        }else if (boot_gen == 0b11)
        {
	  bootmode_gen = "default QSPI/JTAG/SD";
        }else
        {
	  bootmode_gen = "undefined";
        }


      pudc = (rval16 >> 11) & 0x1;
      if (pudc==1)
        {
	  pudc_mode = "Pulldown";
        } else
        {
	  pudc_mode = "Pullup";
        }


      Status = XEmacPs_PhyRead(&Emac, 0x1A,  4, &rval16); if(Status != XST_SUCCESS){	return XST_FAILURE; }
      cpld_bm = (rval16 >> 10)& 0x01;
      if (cpld_bm == 0)
        {
	  cpld_bootmode = "Deactive";
	  // Read register 4
	  Status = XEmacPs_PhyRead(&Emac, 0x1A,  4, &rval16); if(Status != XST_SUCCESS){	return XST_FAILURE; }
	  boot = (rval16 >> 8) & 0x3;
	  if (boot == 0b00)
            {
	      boot_mode = "JTAG";
            }
	  else if (boot == 0b10)
            {
	      boot_mode = "QSPI";
            }
	  else if (boot == 0b11)
            {
	      boot_mode = "SD Card";
            }
	  else if (boot == 0b01)
            {
	      boot_mode = "undefined";
            }
	  // xil_printf("\n\rSoM: TE0720 CPLD_BM=%s(%x) BOOTMOD_GEN=%x(%s) PUDC_MODE=%s(%d) BOOT_MODE=%s(%x) CPLD_REV=%02x", cpld_bootmode, cpld_bm, boot_gen, bootmode_gen, pudc_mode, pudc, boot_mode, boot, cpld_rev);
	  // xil_printf("\n\rSoM: TE0720 WDT_STATUS=%s(%x) CPLD_BM=%s(%x) BOOTMOD_GEN=%x(%s) PUDC_MODE=%s(%d) BOOT_MODE=%s(%x) CPLD_REV=%02x", wdt_status, wdt, cpld_bootmode, cpld_bm, boot_gen, bootmode_gen, pudc_mode, pudc, boot_mode, boot, cpld_rev);
	  xil_printf("\n\rCPLD_REV=%02x\n\r",cpld_rev);
	  xil_printf("\n\rWDT_STATUS=%s(%x)\n\r", wdt_status,wdt);
	  xil_printf("\n\rCPLD_BM=%s(%x)\n\r",cpld_bootmode, cpld_bm);
	  xil_printf("\n\rBOOTMOD_GEN=%x(%s)\n\r", boot_gen, bootmode_gen);
	  xil_printf("\n\rPUDC_MODE=%s(%d)\n\r", pudc_mode, pudc);
	  xil_printf("\n\rBOOT_MODE=%s(%x)\n\r", boot_mode, boot);
        } else
        {
	  cpld_bootmode="Active";
	  // Read register 12 (CR4[15:8])
	  Status = XEmacPs_PhyRead(&Emac, 0x1A,  12, &rval16); if(Status != XST_SUCCESS){	return XST_FAILURE; }
	  boot = (rval16 >> 8) & 0x3;
	  if (boot == 0b01)
            {
	      boot_mode = "JTAG";
            }
	  else if (boot == 0b10)
            {
	      boot_mode = "QSPI";
            }
	  else if (boot == 0b11)
            {
	      boot_mode = "SD Card";
            }
	  else if (boot == 0b00)
            {
	      boot_mode = "undefined";
            }
	  // xil_printf("\n\rSoM: TE0720 CPLD_BM=%s(%x) BOOTMOD_GEN=%x(%s) PUDC_MODE=%s(%d) BOOT_MODE=%s(%x) CPLD_REV=%02x", cpld_bootmode, cpld_bm, boot_gen, bootmode_gen, pudc_mode, pudc, boot_mode, boot, cpld_rev);
	  // xil_printf("\n\rSoM: TE0720 WDT_STATUS=%s(%x) CPLD_BM=%s(%x) BOOTMOD_GEN=%x(%s) PUDC_MODE=%s(%d) BOOT_MODE=%s(%x) CPLD_REV=%02x", wdt_status, wdt, cpld_bootmode, cpld_bm, boot_gen, bootmode_gen, pudc_mode, pudc, boot_mode, boot, cpld_rev);
	  xil_printf("\n\rCPLD_REV=%02x\n\r",cpld_rev);
	  xil_printf("\n\rWDT_STATUS=%s(%x)\n\r", wdt_status,wdt);
	  xil_printf("\n\rCPLD_BM=%s(%x)\n\r",cpld_bootmode, cpld_bm);
	  xil_printf("\n\rBOOTMOD_GEN=%x(%s)\n\r", boot_gen, bootmode_gen);
	  xil_printf("\n\rPUDC_MODE=%s(%d)\n\r", pudc_mode, pudc);
	  xil_printf("\n\rBOOT_MODE=%s(%x)\n\r", boot_mode, boot);
        }

      xil_printf("\n\rMAC: ");

      for(i = 0; i < 6; i++) {
	xil_printf("%02x ", mac_addr[i]);
      }
      xil_printf("\n\r");
    }

#endif

  /*
   * Write MAC Address to OCM memory for u-boot to import!
   *
   */

  //strcpy(0xFFFFFC04, "ethaddr=00:0a:35:00:00:05\n" );
#ifdef UBOOT_ENV_MAGIC
  Xil_Out32(UBOOT_ENV_MAGIC_ADDR, UBOOT_ENV_MAGIC); // Magic!
  MacToUbootEnvironment((char*)UBOOT_ENV_ADDR, mac_addr);
#endif


  /*
   * Set MAC Address in PS7 IP Core registers
   */
  Status = XEmacPs_SetMacAddress(&Emac, mac_addr, 1); if(Status != XST_SUCCESS){ return XST_FAILURE; }



  /*
   * Marvell PHY Config
   */

  /* Select Page 18 */
  Status = XEmacPs_PhyWrite(&Emac, 0x00,  0x16, 0x0012); if(Status != XST_SUCCESS){ return XST_FAILURE; }
  /* Disable fiber/SGMII Autodetect */
  Status = XEmacPs_PhyWrite(&Emac, 0x00,  0x14, 0x8210); if(Status != XST_SUCCESS){ return XST_FAILURE; }

  /* Select Page 3 */
  Status = XEmacPs_PhyWrite(&Emac, 0x00,  0x16, 0x0003); if(Status != XST_SUCCESS){ return XST_FAILURE; }
  /* LED0: On link, Blink activity, LED1 Receive, LED2 Transmit */
  Status = XEmacPs_PhyWrite(&Emac, 0x00,  16, 0x0501); if(Status != XST_SUCCESS){ return XST_FAILURE; }
  /* LED polarity positive, push-pull on=high */
  Status = XEmacPs_PhyWrite(&Emac, 0x00,  17, 0x4415); if(Status != XST_SUCCESS){ return XST_FAILURE; }


  /* Select Page 0 */
  Status = XEmacPs_PhyWrite(&Emac, 0x00,  0x16, 0x0000); if(Status != XST_SUCCESS){ return XST_FAILURE; }

#ifdef TE0720
  /*
   * SC LED remap
   * Green = ETH LED 0, Red = MIO7, NOSEQ output = ETH LED0
   */
  Status = XEmacPs_PhyWrite(&Emac, 0x1A,  5, 0x0041); if(Status != XST_SUCCESS){ return XST_FAILURE; }

  /*
   * Reset pulse to USB PHY
   */
  Status = XEmacPs_PhyWrite(&Emac, 0x1A,  7, 0x0010); if(Status != XST_SUCCESS){ return XST_FAILURE; }
  Status = XEmacPs_PhyWrite(&Emac, 0x1A,  7, 0x0000); if(Status != XST_SUCCESS){ return XST_FAILURE; }
#endif


  xil_printf("\r\n--------------------------------------------------------------------------------\r\n");

  return (Status);
}
