mulhearn/pacman/(commit log)

2024-10-04 Trenz test board demo with Vivado 2020.2
    [devtool-fragment.cfg, pinout_JB1-3.csv, pinout_bugged.csv]
2024-10-04 petalinux 2023
    [bsp.cfg, user_2024-01-16-07-49-00.cfg]
2025-06-20 initial implementation of on-board ADC feature
2025-06-20 install updated ghdl modules from previous commits in vivado, update constraints for ADC and LEMO inputs, update top-level diagram for new modules, update tcl scripts.
2025-06-20 update apps to exercise new ADC and timing features, and better organization via submenus
2025-06-20 All HW features now supported through menu-based access to linux drivers in pacman_menu program of hwutil pkg, new pacman_server utility scripts
2025-09-10 import new HDL into vivado, implement scatter-gather mode in DMA, implement synthesis date stamp and vivado version, cleanup tcl scripts from unused IP
2025-09-10 implement scatter-gather mode in driver, implement new common drivers based on platform layer shared between bare-metal and linux
2025-09-10 updated pacman-server and hwutil for scatter-gather mode, using new platform layer supporting common drivers for bare-metal/linux
2025-09-18 fixup for pacman-server 3.3
    [pacman.cc, pacman_vspace.cc, rxtx.c]
2025-10-24 new snappier RX and TX units, with 64-bit stream size and 192-bit LArPix word size
    [axis_read.vhd, axis_read_tb.vhd, axis_write.vhd, axis_write_tb.vhd, common.vhd, heartbeat.vhd, heartbeat_tb.vhd, register_map.vhd]
2025-10-24 revert to a simplified ADC unit
    [adc_registers.vhd, adc_registers_tb.vhd, adc_unit.vhd, adc_unit_tb.vhd]
2025-12-07 move I2C into platform layer, at ASIC config support to driver
2025-12-07 sync common drivers, add ASIC support, restore pacman_push and pacman_counter for loopback testing
2026-02-12 fix printf errors when using 64-bit unsigned on 32-bit ARM
    [pacman_message.cc]
2026-02-15 fix alignment problems introduced with new 64-bit message format
    [dma.c, hw_access.c, hw_access.h, main.cc, pacman.cc, pacman_message.cc, pacman_simulated.cc, tx_buffer.cc]
2026-02-16 I2C update
2026-02-16 sync common drivers
2026-02-16 add support for multiple HW versions in I2C
2026-02-17 add simultaneous support for PACMAN 1V4 in I2C. Not yet tested on 1V4 hardware, but does not break 1V5.
2026-02-18 update flow summary
2026-02-18 fix compile of bare metal demo
    [hw_access.h]
2026-02-19 bugfix for UART mask registers
    [pacman_vspace.cc]
2026-04-21 fix printf errors / warnings for bare-metal
    [adc.c, asic.c, asic_menu.c, atc.c, dma.c, global.c, iic.c, iic.h]
2026-04-23 commmon driver updates
